cocobot/cocotter/elec/hw/cartes/pmi_charger_2023/pmi_charger_2023.step

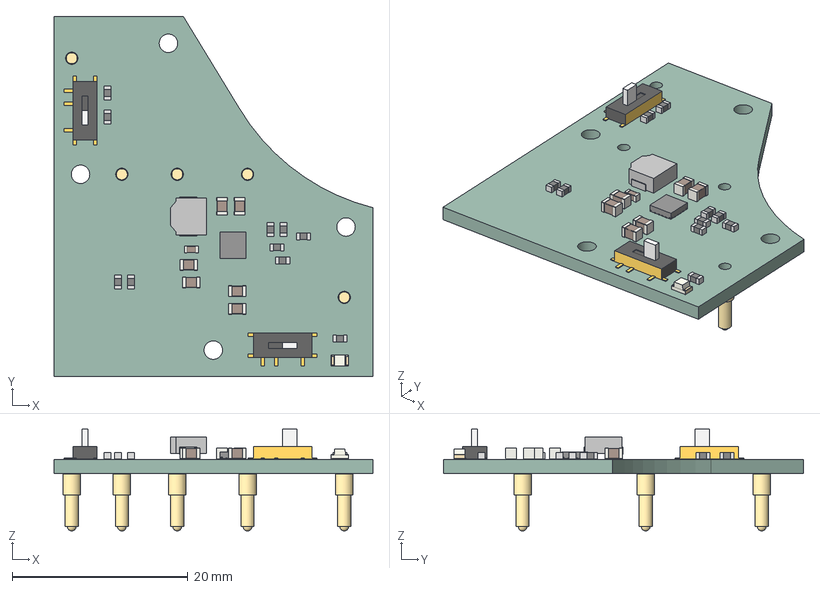
[picture p5: CAD file, 2024-06-13]
elec/hw/cartes/pmi_charger_2023/pmi_charger_2023.step
36.2 x 41.0 x 11.6 mm
C_0805_2012Metric x 6
SPM4020F
LED_0805_2012Metric
C_0603_1608Metric
RTE0016C_ASM
pmi_charger_PCB
