cocobot/cocotter/meca/pami/PAMI-support_moteur_helice.stl

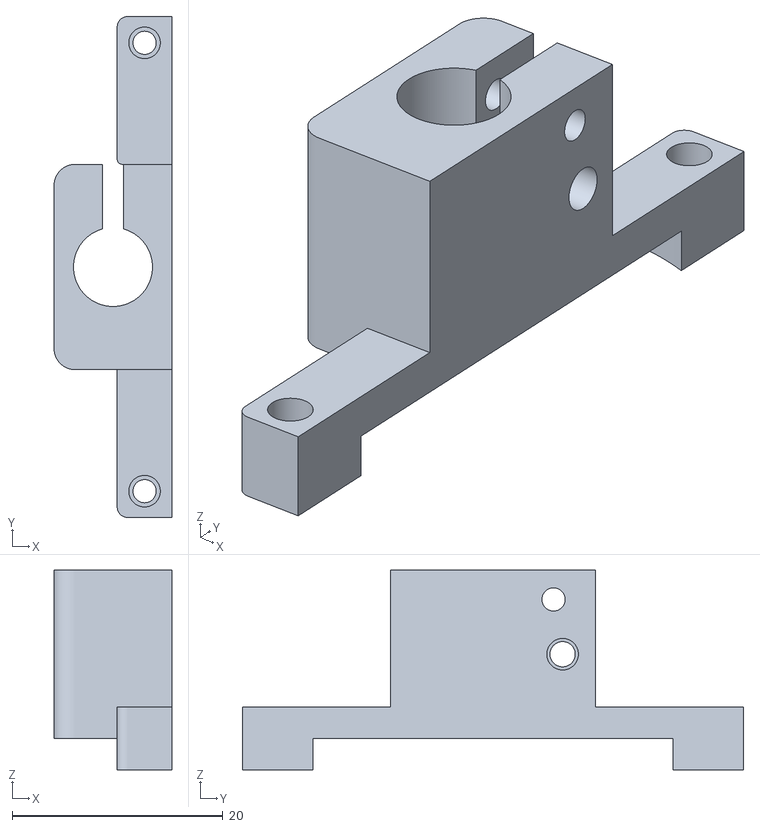
[picture p6: CAD file, 2025-01-07]
meca/pami/PAMI-support_moteur_helice.stl
11.2 x 47.6 x 19.0
