cocobot/cocotter/elec/hw/cartes/pmi_2023/pmi_2023.kicad_pcb

## KiCad design elec/hw/cartes/pmi_2023/pmi_2023.kicad_pcb (2024-12-13)

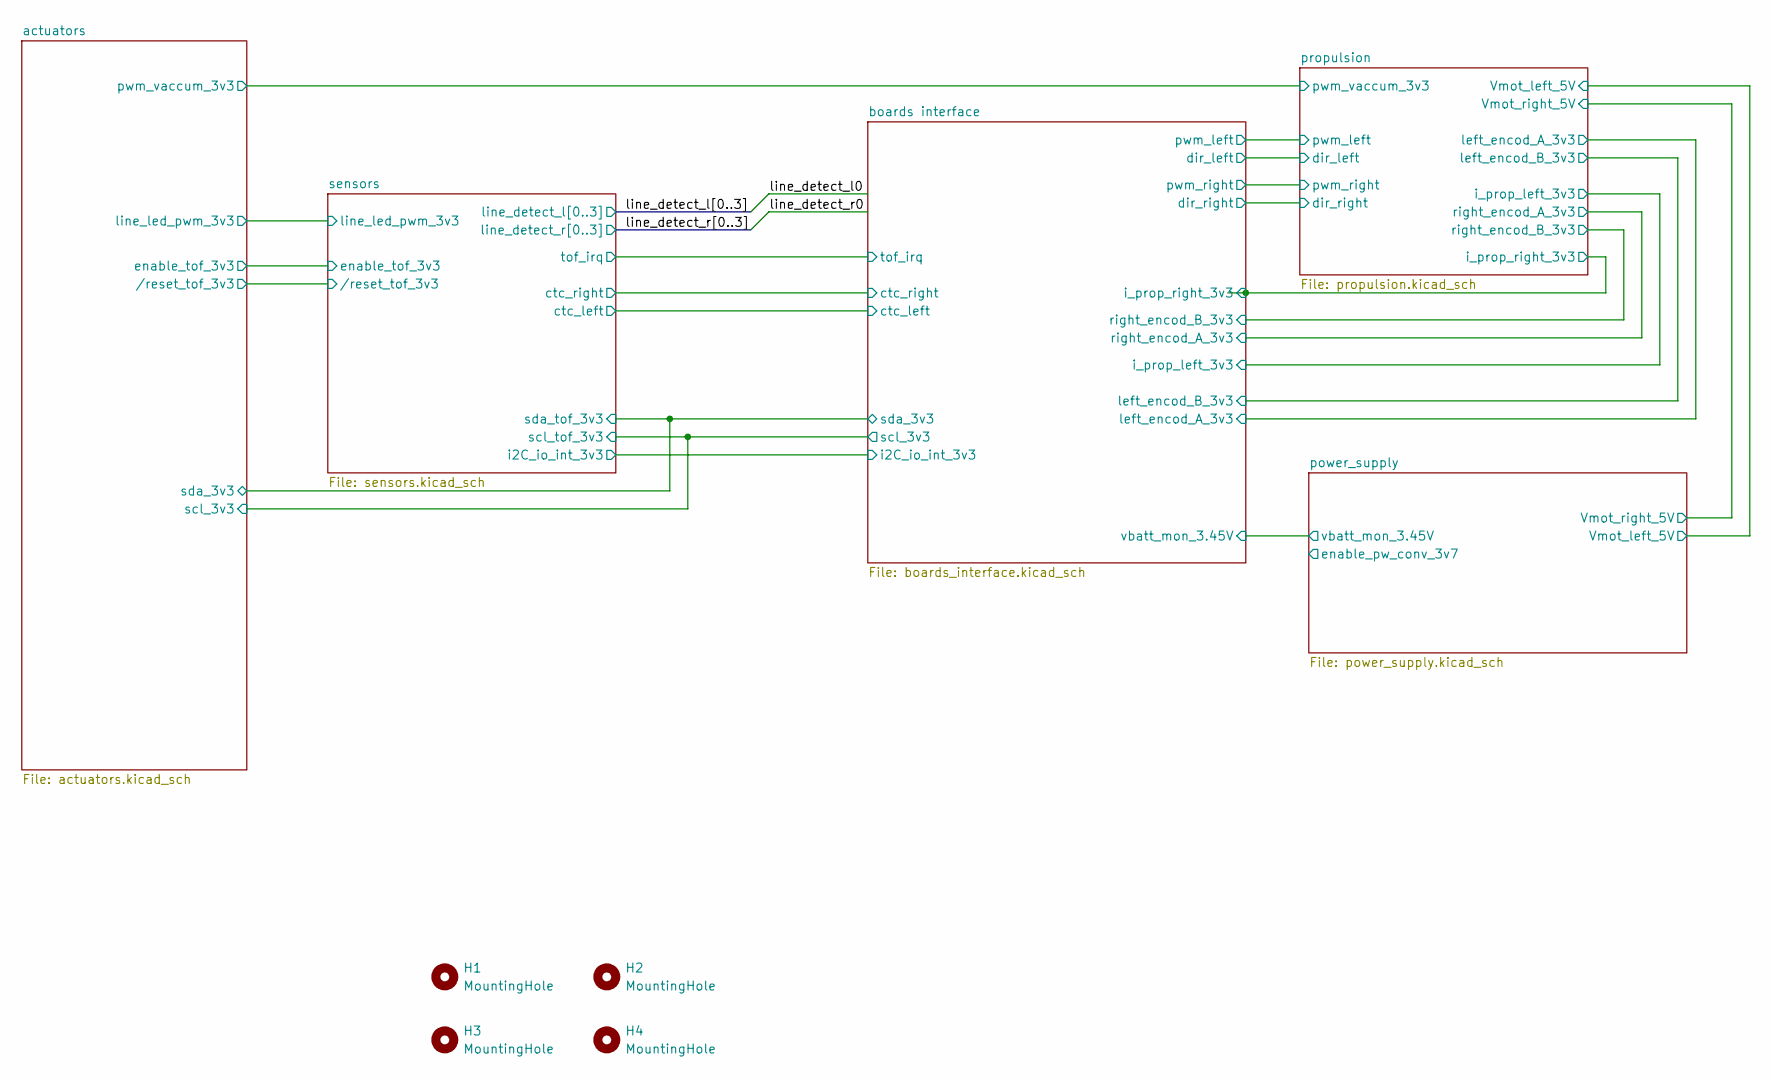
[picture p7: schematic pmi_2023.kicad_sch]

Parts:
H1, H2, H3, H4: MountingHole; MountingHole_2.1mm

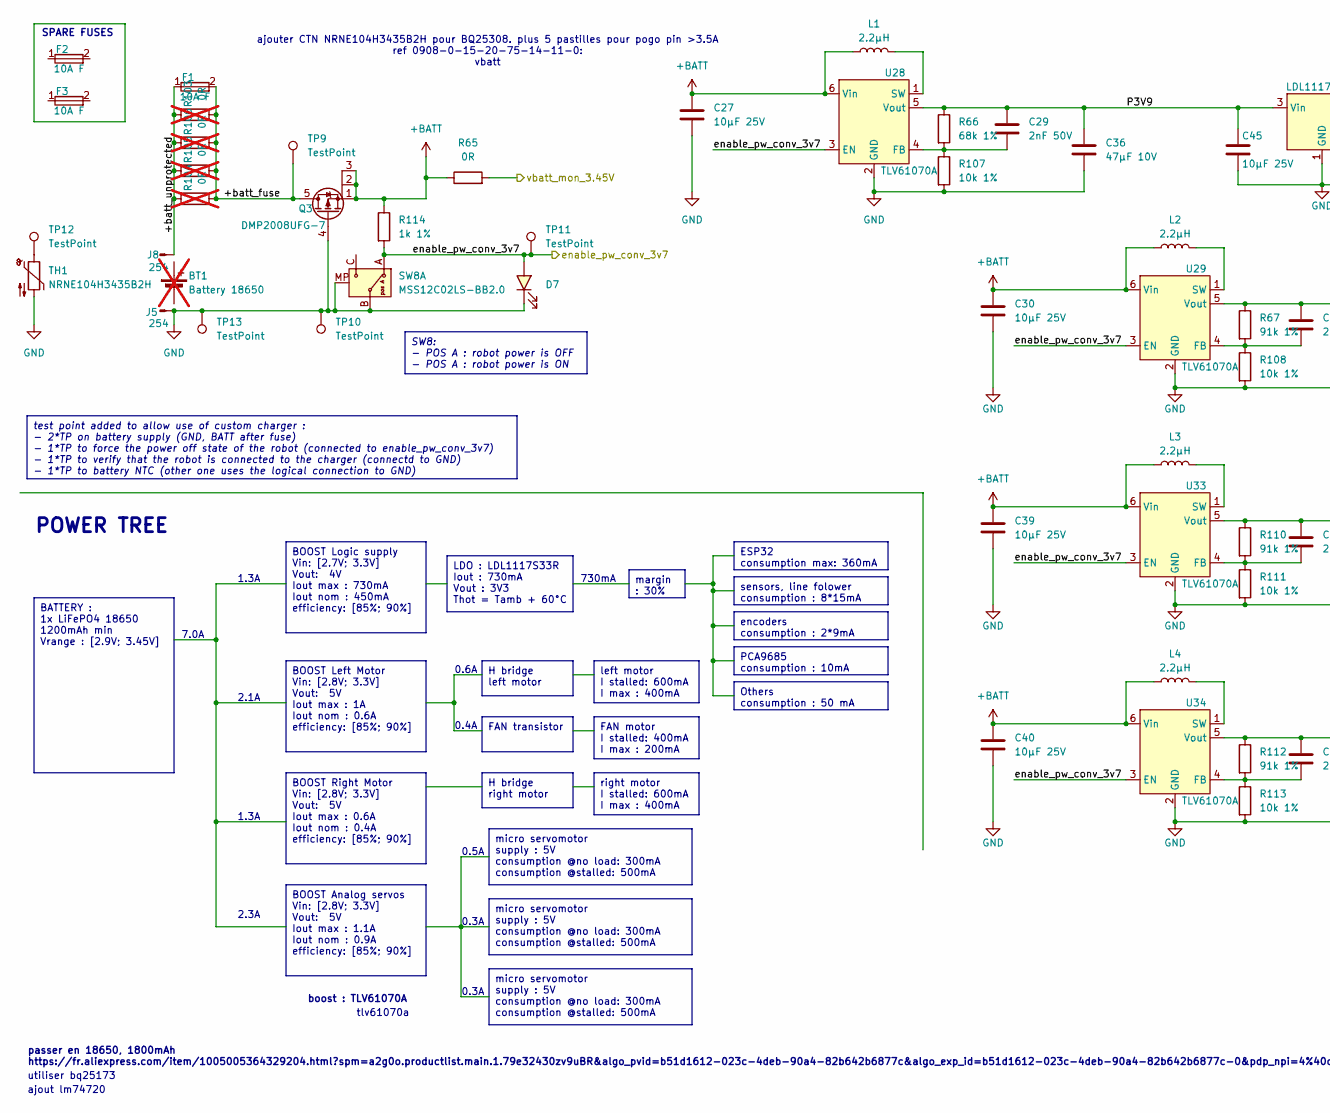
[picture p8: schematic power_supply.kicad_sch, part in row 1, column 1]

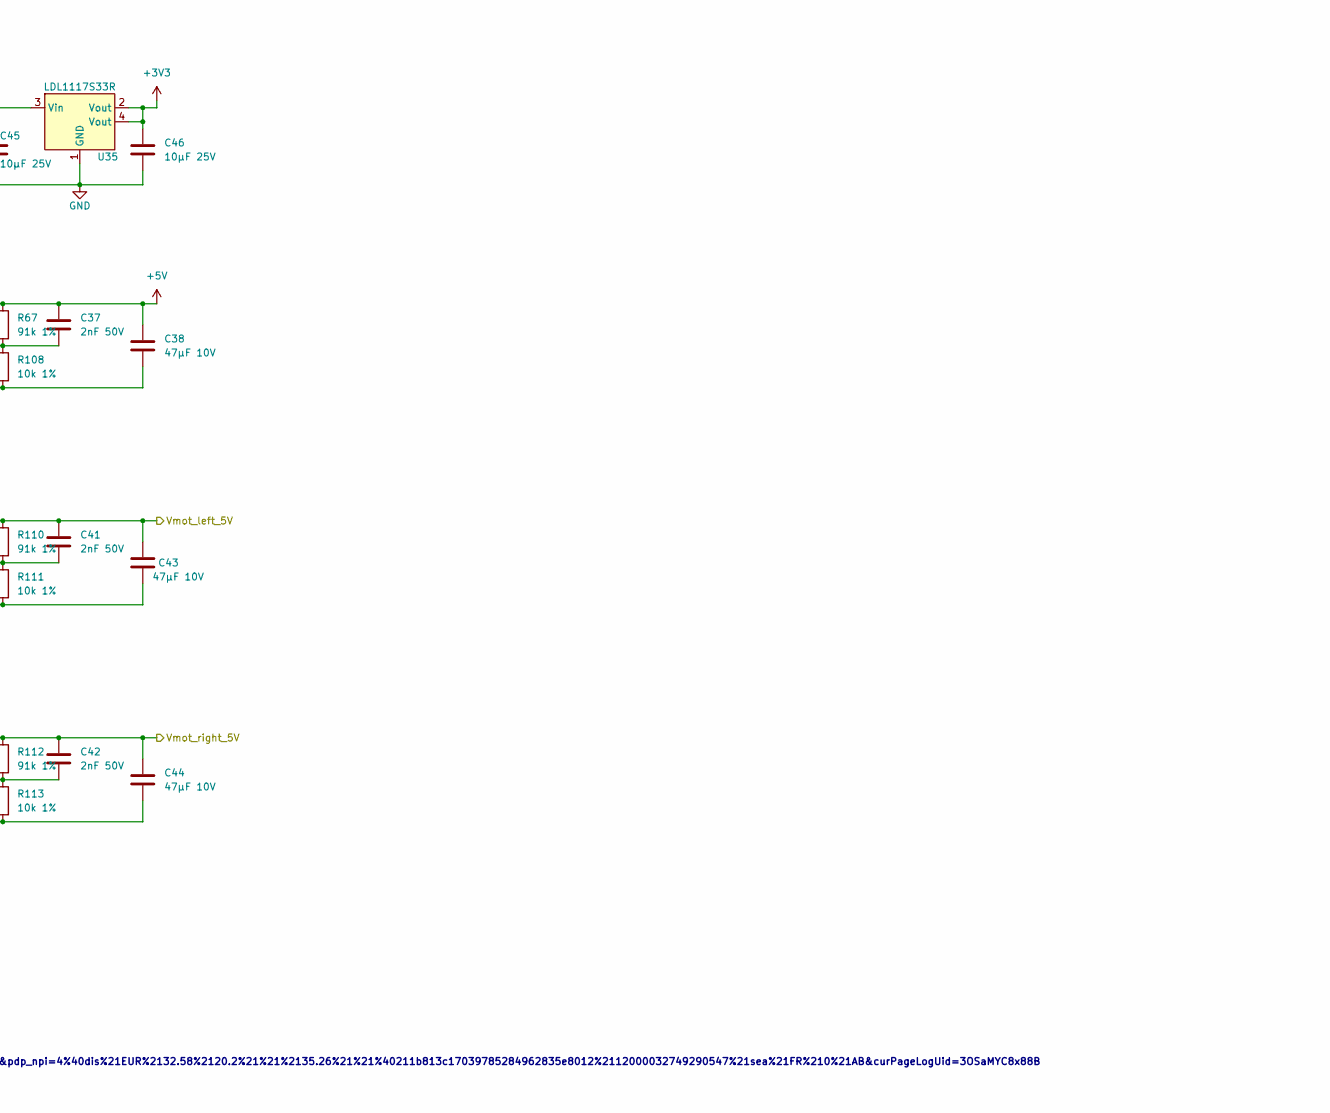
[picture p9: schematic power_supply.kicad_sch, part in row 1, column 2]

Parts:
BT1: Battery 18650; not fitted
C27, C30, C39, C40, C45, C46: 10µF 25V; C_0805_2012Metric; JLCPCB Part # C15850
C29, C37, C41, C42: 2nF 50V; C_0603_1608Metric; JLCPCB Part # C282245
C36, C38, C43, C44: 47µF 10V; C_1206_3216Metric; JLCPCB Part # C96123
D7: green, 0603; LED_0603_1608Metric; DIGIKEY_REF 3147-B19Y1UYG-20C000313U1930CT-ND
F1, F2, F3: 10A F; JFC2410; JLCPCB Part # C136374
J5, J8: 254; JLCPCB Part # C2979182
L1, L2, L3, L4: 2.2µH; L_Kyocera_07A7_7.3x6.6mm; MOUSER 581-LMLP07A7M2R2DTAS
Q3: DMP2008UFG-7; Diodes_PowerDI3333-8; JLCPCB Part # C461052
R65: 0R; r0603_reflow; JLCPCB Part # C431718
R66: 68k 1%; r0603_reflow; JLCPCB Part # C23231
R67, R110, R112: 91k 1%; r0603_reflow; JLCPCB Part # C23265
R103, R104, R105, R106: 0R; r0603_reflow; JLCPCB Part # C431718; not fitted
R107, R108, R111, R113: 10k 1%; r0603_reflow; mouser 603-RC0603FR-10100KL
R114: 1k 1%; r0603_reflow; mouser 603-RC0603FR-10100KL
SW8: MSS12C02LS-BB2.0; JLCPCB Part # C3008585
TH1: NRNE104H3435B2H; CTN-NRN
TP9, TP10, TP11, TP12, TP13: TestPoint; testpoint-THT-0.5mm
U28, U29, U33, U34: TLV61070A; SOT-23-6
U35: LDL1117S33R; SOT-223

Connections:
+3V3: C46.1, U35.2 (Vout), U35.4 (Vout); also elsewhere on the board
+5V: C37.1, C38.1, R67.1, U29.5 (Vout); also elsewhere on the board
+BATT: C27.1, C30.1, C39.1, C40.1, L1.1, L2.1, L3.1, L4.1, Q3.1 (S), Q3.2 (S), Q3.3 (S), R65.1, R114.1, U28.6 (Vin), U29.6 (Vin), U33.6 (Vin), U34.6 (Vin)
/boards interface/vbatt_mon_3.45V: R65.2; also elsewhere on the board
/power_supply/+batt_fuse: F1.2, Q3.5 (D), R103.2, R104.2, R105.2, R106.2, TP9.1
/power_supply/+batt_unprotected: F1.1, J8.1 (GND), R103.1, R104.1, R105.1, R106.1
/power_supply/P3V9: C29.1, C36.1, C45.1, R66.1, U28.5 (Vout), U35.3 (Vin)
/power_supply/Vmot_left_5V: C41.1, C43.1, R110.1, U33.5 (Vout); also elsewhere on the board
/power_supply/Vmot_right_5V: C42.1, C44.1, R112.1, U34.5 (Vout); also elsewhere on the board
/power_supply/enable_pw_conv_3v7: D7.A, R114.2, SW8.A, TP11.1, U28.3 (EN), U29.3 (EN), U33.3 (EN), U34.3 (EN)
GND: C27.2, C30.2, C36.2, C38.2, C39.2, C40.2, C43.2, C44.2, C45.2, C46.2, D7.C, J5.1 (GND), Q3.4 (G), R107.2, R108.2, R111.2, R113.2, SW8.B, SW8.MP, TH1.2, TP10.1, TP13.1, U28.2 (GND), U29.2 (GND), U33.2 (GND), U34.2 (GND), U35.1 (GND); also elsewhere on the board
unnamed: TH1.1, TP12.1
unnamed: C29.2, R66.2, R107.1, U28.4 (FB)
unnamed: L1.2, U28.1 (SW)
unnamed: C37.2, R67.2, R108.1, U29.4 (FB)
unnamed: L2.2, U29.1 (SW)
unnamed: C41.2, R110.2, R111.1, U33.4 (FB)
unnamed: L3.2, U33.1 (SW)
unnamed: C42.2, R112.2, R113.1, U34.4 (FB)
unnamed: L4.2, U34.1 (SW)

Notes on the sheet:
FAN motor I stalled: 400mA I max : 200mA
H bridge left motor
micro servomotor supply : 5V consumption @no load: 300mA consumption @stalled: 500mA
right motor I stalled: 600mA I max : 400mA
BATTERY : 1x LiFePO4 18650 1200mAh min Vrange : [2.9V; 3.45V]
encoders consumption : 2*9mA
BOOST Right Motor Vin: [2.8V; 3.3V] Vout: 5V Iout max : 0.6A Iout nom : 0.4A efficiency: [85%; 90%]
FAN transistor
left motor I stalled: 600mA I max : 400mA
ESP32 consumption max: 360mA
H bridge right motor
Others consumption : 50 mA
BOOST Left Motor Vin: [2.8V; 3.3V] Vout: 5V Iout max : 1A Iout nom : 0.6A efficiency: [85%; 90%]
BOOST Logic supply Vin: [2.7V; 3.3V] Vout: 4V Iout max : 730mA Iout nom : 450mA efficiency: [85%; 90%]
PCA9685 consumption : 10mA
SW8: - POS A : robot power is OFF - POS A : robot power is ON
test point added to allow use of custom charger : - 2*TP on battery supply (GND, BATT after fuse) - 1*TP to force the power off state of the robot (connected to enable_pw_conv_3v7) - 1*TP to verify that the robot is connected to the charger (connectd to GND) - 1*TP to battery NTC (other one uses th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
margin : 30%
BOOST Analog servos Vin: [2.8V; 3.3V] Vout: 5V Iout max : 1.1A Iout nom : 0.9A efficiency: [85%; 90%]
LDO : LDL1117S33R Iout : 730mA Vout : 3V3 Thot = Tamb + 60°C
sensors, line folower consumption : 8*15mA
ajouter CTN NRNE104H3435B2H pour BQ25308. plus 5 pastilles pour pogo pin >3.5A ref 0908-0-15-20-75-14-11-0: vbatt
0.3A
1.3A
ajout lm74720
POWER TREE
passer en 18650, 1800mAh https://fr.aliexpress.com/item/1005005364329204.html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…
0.4A
2.1A
tlv61070a
utiliser bq25173
0.6A
2.3A
boost : TLV61070A
SPARE FUSES
7.0A
0.5A
730mA

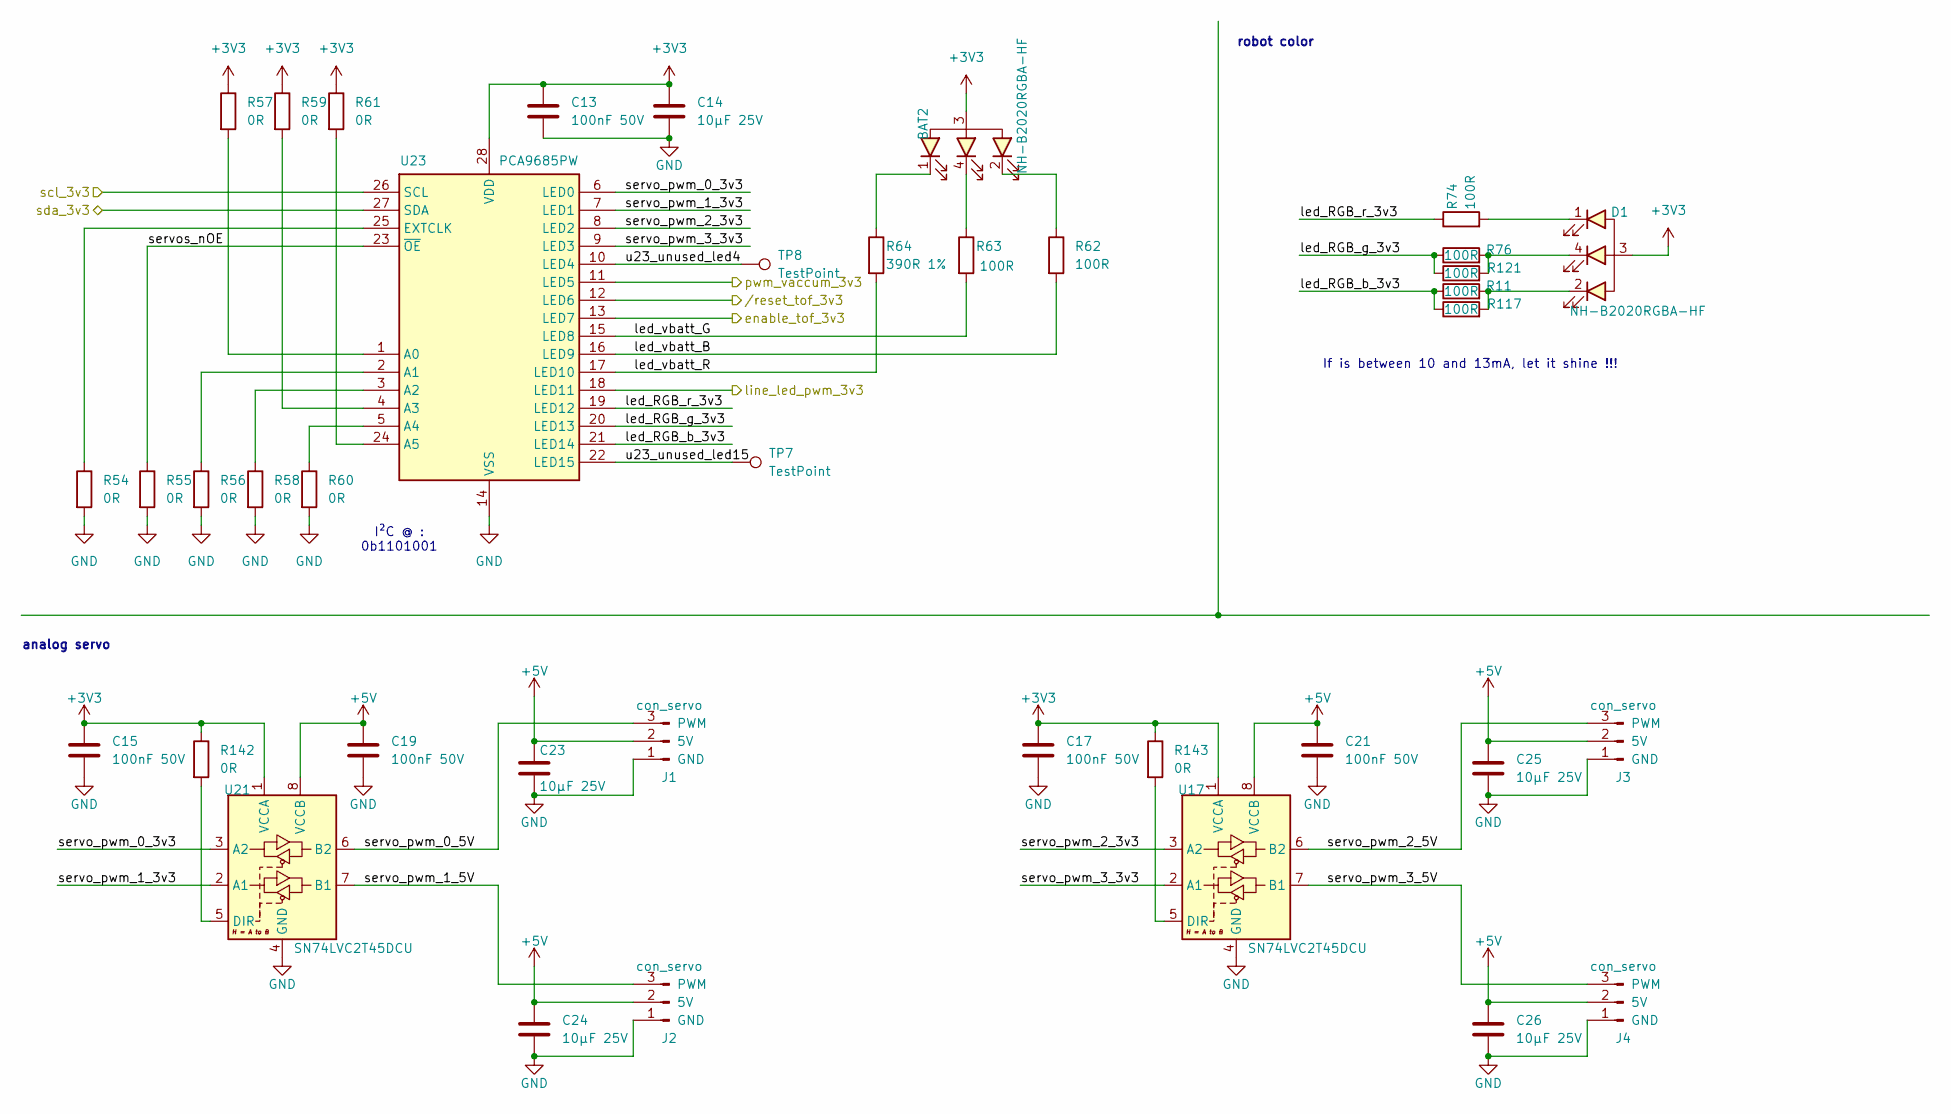
[picture p10: schematic actuators.kicad_sch]

Parts:
BAT2: NH-B2020RGBA-HF; JLCPCB Part # C2874116
C13, C15, C17, C19, C21: 100nF 50V; C_0603_1608Metric; JLCPCB Part # C14663
C14, C23, C24, C25, C26: 10µF 25V; C_0805_2012Metric; JLCPCB Part # C15850
D1: NH-B2020RGBA-HF; JLCPCB Part # C2874116
J1, J2, J3, J4: con_servo; ana_servo_5V; JLCPCB Part # C2932698
R11, R74, R76, R117, R121: 100R; r0603_reflow; JLCPCB Part # C22775
R54, R55, R56, R57, R58, R59, R60, R61, R142, R143: 0R; r0603_reflow; JLCPCB Part # C431718
R62, R63: 100R; r0603_reflow; mouser 603-RC0603FR-10100KL
R64: 390R 1%; r0603_reflow; mouser 603-RC0603FR-10100KL
TP7, TP8: TestPoint; testpoint-THT-0.5mm
U17, U21: SN74LVC2T45DCU; VSSOP-8-DCU
U23: PCA9685PW; TSSOP-28_4.4x9.7mm_P0.65mm; JLCPCB Part # C2678753

Connections:
+3V3: BAT2.3 (COM), C13.1, C14.1, C15.1, C17.1, D1.3 (COM), R57.1, R59.1, R61.1, R142.1, R143.1, U17.1 (VCCA), U21.1 (VCCA), U23.28 (VDD); also elsewhere on the board
+5V: C19.1, C21.1, C23.1, C24.1, C25.1, C26.1, J1.2 (5V), J2.2 (5V), J3.2 (5V), J4.2 (5V), U17.8 (VCCB), U21.8 (VCCB); also elsewhere on the board
/actuators/enable_tof_3v3: U23.13 (LED7); also elsewhere on the board
/actuators/led_RGB_b_3v3: R11.1, R117.1, U23.21 (LED14)
/actuators/led_RGB_g_3v3: R76.1, R121.1, U23.20 (LED13)
/actuators/led_RGB_r_3v3: R74.1, U23.19 (LED12)
/actuators/led_vbatt_B: R62.2, U23.16 (LED9)
/actuators/led_vbatt_G: R63.2, U23.15 (LED8)
/actuators/led_vbatt_R: R64.2, U23.17 (LED10)
/actuators/line_led_pwm_3v3: U23.18 (LED11); also elsewhere on the board
/actuators/scl_3v3: U23.26 (SCL); also elsewhere on the board
/actuators/sda_3v3: U23.27 (SDA); also elsewhere on the board
/actuators/servo_pwm_0_3v3: U21.3 (A2), U23.6 (LED0)
/actuators/servo_pwm_0_5V: J1.3 (PWM), U21.6 (B2)
/actuators/servo_pwm_1_3v3: U21.2 (A1), U23.7 (LED1)
/actuators/servo_pwm_1_5V: J2.3 (PWM), U21.7 (B1)
/actuators/servo_pwm_2_3v3: U17.3 (A2), U23.8 (LED2)
/actuators/servo_pwm_2_5V: J3.3 (PWM), U17.6 (B2)
/actuators/servo_pwm_3_3v3: U17.2 (A1), U23.9 (LED3)
/actuators/servo_pwm_3_5V: J4.3 (PWM), U17.7 (B1)
/actuators/servos_nOE: R55.1, U23.23 (~OE)
/actuators/u23_unused_led4: TP8.1, U23.10 (LED4)
/actuators/u23_unused_led15: TP7.1, U23.22 (LED15)
/actuators//reset_tof_3v3: U23.12 (LED6); also elsewhere on the board
/propulsion/pwm_vaccum_3v3: U23.11 (LED5); also elsewhere on the board
GND: C13.2, C14.2, C15.2, C17.2, C19.2, C21.2, C23.2, C24.2, C25.2, C26.2, J1.1 (GND), J2.1 (GND), J3.1 (GND), J4.1 (GND), R54.2, R55.2, R56.2, R58.2, R60.2, U17.4 (GND), U21.4 (GND), U23.14 (VSS); also elsewhere on the board
unnamed: BAT2.2 (C_BLUE), R62.1
unnamed: BAT2.4 (C_GREEN), R63.1
unnamed: BAT2.1 (C_RED), R64.1
unnamed: D1.2 (C_BLUE), R11.2, R117.2
unnamed: D1.4 (C_GREEN), R76.2, R121.2
unnamed: D1.1 (C_RED), R74.2
unnamed: R143.2, U17.5 (DIR)
unnamed: R142.2, U21.5 (DIR)
unnamed: R57.2, U23.1 (A0)
unnamed: R56.1, U23.2 (A1)
unnamed: R58.1, U23.3 (A2)
unnamed: R59.2, U23.4 (A3)
unnamed: R60.1, U23.5 (A4)
unnamed: R61.2, U23.24 (A5)
unnamed: R54.1, U23.25 (EXTCLK)

Notes on the sheet:
I²C @ : 0b1101001
If is between 10 and 13mA, let it shine !!!
robot color
analog servo

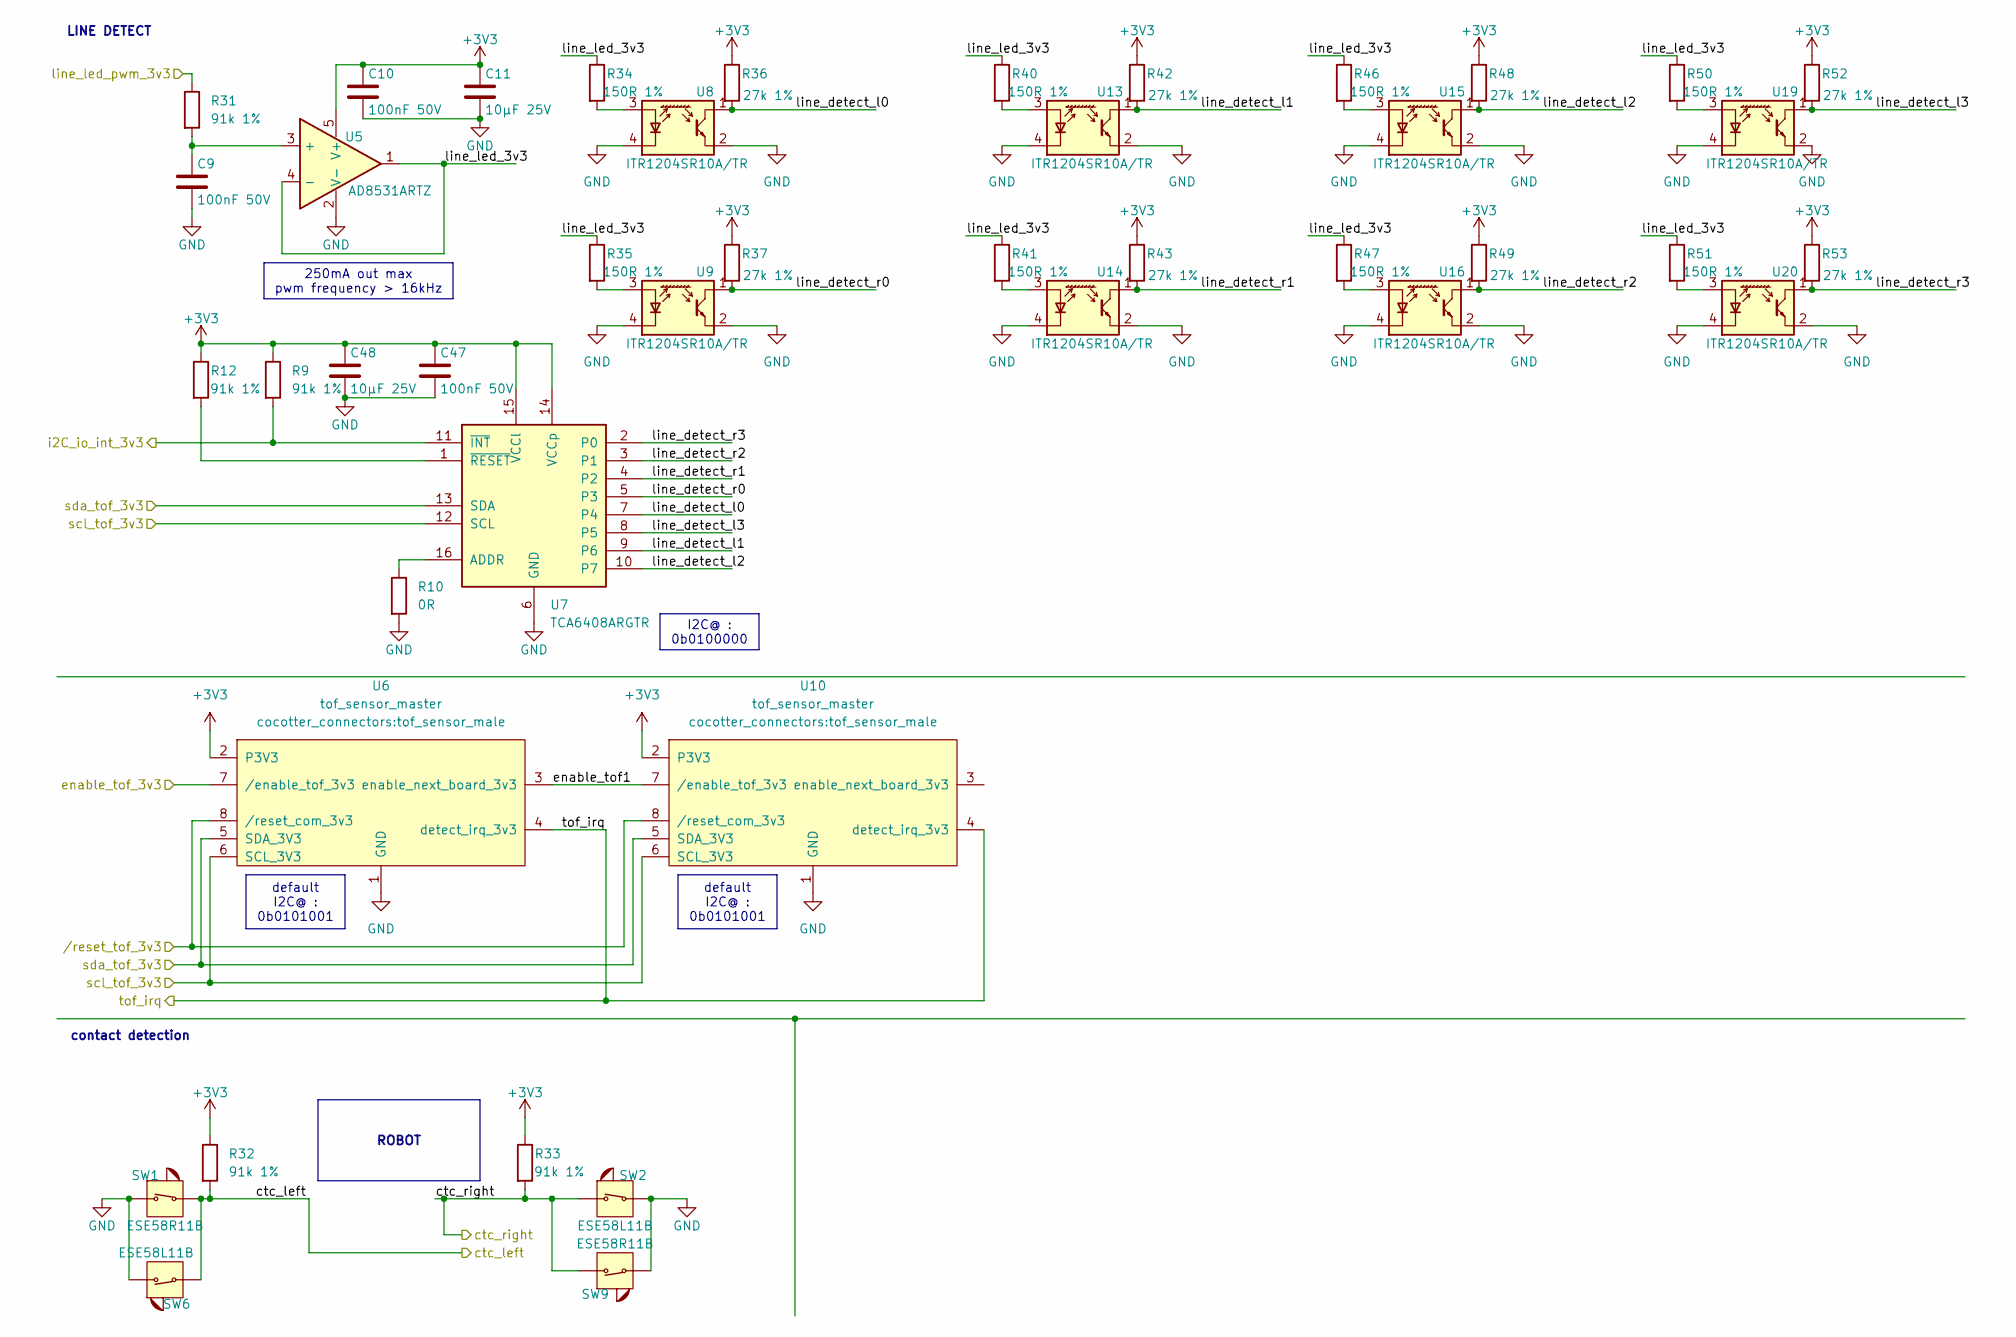
[picture p11: schematic sensors.kicad_sch]

Parts:
C9, C10, C47: 100nF 50V; C_0603_1608Metric; JLCPCB Part # C14663
C11, C48: 10µF 25V; C_0805_2012Metric; JLCPCB Part # C15850
R9, R12, R31, R32, R33: 91k 1%; r0603_reflow; JLCPCB Part # C23265
R10: 0R; r0603_reflow; JLCPCB Part # C431718
R34, R35, R40, R41, R46, R47, R50, R51: 150R 1%; r0805_reflow; JLCPCB Part # C17471
R36, R37, R42, R43, R48, R49, R52, R53: 27k 1%; r0603_reflow; JLCPCB Part # C22967
SW1, SW9: ESE58R11B; Mouser 667-ESE-22MH22
SW2, SW6: ESE58L11B; Mouser 667-ESE-22MH24
U5: AD8531ARTZ; SOT-23-5; MOUSER_REF 584-AD8531ARTZ-R7
U6, U10: tof_sensor_master; tof_sensor_male
U7: TCA6408ARGTR; VQFN-16-1EP_3x3mm_P0.5mm_EP1.1x1.1mm; mouser 595-TCA6408ARGTR
U8, U9, U13, U14, U15, U16, U19, U20: ITR1204SR10A/TR; ITR1204SR10A; JLCPCB Part # C2943466

Connections:
+3V3: C10.1, C11.1, C47.1, C48.1, R9.1, R12.1, R32.1, R33.1, R36.1, R37.1, R42.1, R43.1, R48.1, R49.1, R52.1, R53.1, U5.5 (V+), U6.2 (P3V3), U7.14 (VCCp), U7.15 (VCCl), U10.2 (P3V3); also elsewhere on the board
/actuators/enable_tof_3v3: U6.7 (/enable_tof_3v3); also elsewhere on the board
/actuators/line_led_pwm_3v3: R31.1; also elsewhere on the board
/actuators/scl_3v3: U6.6 (SCL_3V3), U7.12 (SCL), U10.6 (SCL_3V3); also elsewhere on the board
/actuators/sda_3v3: U6.5 (SDA_3V3), U7.13 (SDA), U10.5 (SDA_3V3); also elsewhere on the board
/actuators//reset_tof_3v3: U6.8 (/reset_com_3v3), U10.8 (/reset_com_3v3); also elsewhere on the board
/boards interface/i2C_io_int_3v3: R9.2, U7.11 (~INT); also elsewhere on the board
/sensors/ctc_left: R32.2, SW1.2, SW6.2; also elsewhere on the board
/sensors/ctc_right: R33.2, SW2.1, SW9.1; also elsewhere on the board
/sensors/enable_tof1: U6.3 (enable_next_board_3v3), U10.7 (/enable_tof_3v3)
/sensors/line_detect_l0: R36.2, U7.7 (P4), U8.1 (C)
/sensors/line_detect_l1: R42.2, U7.9 (P6), U13.1 (C)
/sensors/line_detect_l2: R48.2, U7.10 (P7), U15.1 (C)
/sensors/line_detect_l3: R52.2, U7.8 (P5), U19.1 (C)
/sensors/line_detect_r0: R37.2, U7.5 (P3), U9.1 (C)
/sensors/line_detect_r1: R43.2, U7.4 (P2), U14.1 (C)
/sensors/line_detect_r2: R49.2, U7.3 (P1), U16.1 (C)
/sensors/line_detect_r3: R53.2, U7.2 (P0), U20.1 (C)
/sensors/line_led_3v3: R34.1, R35.1, R40.1, R41.1, R46.1, R47.1, R50.1, R51.1, U5.1, U5.4 (-)
/sensors/tof_irq: U6.4 (detect_irq_3v3), U10.4 (detect_irq_3v3); also elsewhere on the board
GND: C9.2, C10.2, C11.2, C47.2, C48.2, R10.2, SW1.1, SW2.2, SW6.1, SW9.2, U5.2 (V-), U6.1 (GND), U7.6 (GND), U8.2 (E), U8.4 (K), U9.2 (E), U9.4 (K), U10.1 (GND), U13.2 (E), U13.4 (K), U14.2 (E), U14.4 (K), U15.2 (E), U15.4 (K), U16.2 (E), U16.4 (K), U19.2 (E), U19.4 (K), U20.2 (E), U20.4 (K); also elsewhere on the board
unnamed: C9.1, R31.2, U5.3 (+)
unnamed: R10.1, U7.16 (ADDR)
unnamed: R12.2, U7.1 (~RESET)
unnamed: R34.2, U8.3 (A)
unnamed: R35.2, U9.3 (A)
unnamed: R40.2, U13.3 (A)
unnamed: R41.2, U14.3 (A)
unnamed: R46.2, U15.3 (A)
unnamed: R47.2, U16.3 (A)
unnamed: R50.2, U19.3 (A)
unnamed: R51.2, U20.3 (A)

Notes on the sheet:
250mA out max pwm frequency > 16kHz
default I2C@ : 0b0101001
ROBOT
I2C@ : 0b0100000
contact detection
LINE DETECT

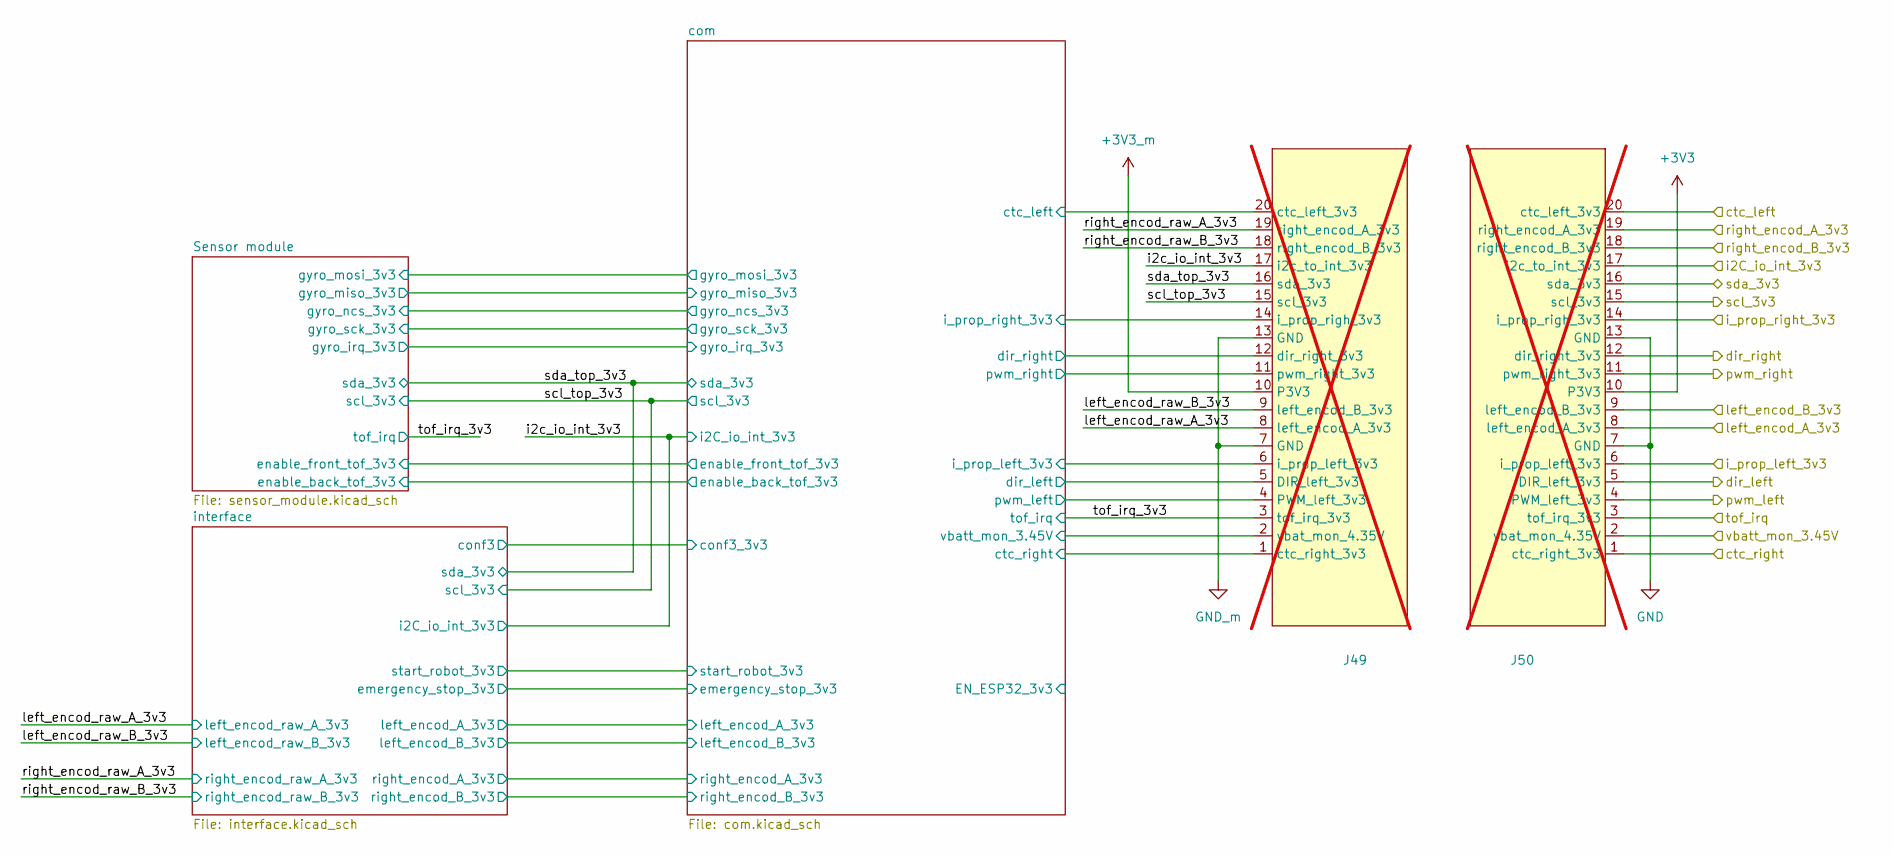
[picture p12: schematic boards_interface.kicad_sch]

Parts:
J49: pmi_2023_interconnection_top; not fitted
J50: pmi_2023_interconnection; not fitted

Connections:
+3V3: J50.10 (P3V3); also elsewhere on the board
+3V3_m: J49.10 (P3V3); also elsewhere on the board
/actuators/scl_3v3: J50.15 (scl_3v3); also elsewhere on the board
/actuators/sda_3v3: J50.16 (sda_3v3); also elsewhere on the board
/boards interface/com/ctc_left: J49.20 (ctc_left_3v3); also elsewhere on the board
/boards interface/com/ctc_right: J49.1 (ctc_right_3v3); also elsewhere on the board
/boards interface/com/dir_left: J49.5 (DIR_left_3v3); also elsewhere on the board
/boards interface/com/dir_right: J49.12 (dir_right_3v3); also elsewhere on the board
/boards interface/com/i_prop_left_3v3: J49.6 (i_prop_left_3v3); also elsewhere on the board
/boards interface/com/i_prop_right_3v3: J49.14 (i_prop_righ_3v3); also elsewhere on the board
/boards interface/com/pwm_left: J49.4 (PWM_left_3v3); also elsewhere on the board
/boards interface/com/pwm_right: J49.11 (pwm_right_3v3); also elsewhere on the board
/boards interface/com/vbatt_mon_3.45V: J49.2 (vbat_mon_4.35V); also elsewhere on the board
/boards interface/i2C_io_int_3v3: J50.17 (i2c_to_int_3v3); also elsewhere on the board
/boards interface/i2c_io_int_3v3: J49.17 (i2c_to_int_3v3); also elsewhere on the board
/boards interface/i_prop_left_3v3: J50.6 (i_prop_left_3v3); also elsewhere on the board
/boards interface/i_prop_right_3v3: J50.14 (i_prop_righ_3v3); also elsewhere on the board
/boards interface/left_encod_raw_A_3v3: J49.8 (left_encod_A_3v3); also elsewhere on the board
/boards interface/left_encod_raw_B_3v3: J49.9 (left_encod_B_3v3); also elsewhere on the board
/boards interface/right_encod_raw_A_3v3: J49.19 (right_encod_A_3v3); also elsewhere on the board
/boards interface/right_encod_raw_B_3v3: J49.18 (right_encod_B_3v3); also elsewhere on the board
/boards interface/scl_top_3v3: J49.15 (scl_3v3); also elsewhere on the board
/boards interface/sda_top_3v3: J49.16 (sda_3v3); also elsewhere on the board
/boards interface/tof_irq_3v3: J49.3 (tof_irq_3v3); also elsewhere on the board
/boards interface/vbatt_mon_3.45V: J50.2 (vbat_mon_4.35V); also elsewhere on the board
/propulsion/dir_left: J50.5 (DIR_left_3v3); also elsewhere on the board
/propulsion/dir_right: J50.12 (dir_right_3v3); also elsewhere on the board
/propulsion/left_encod_A_3v3: J50.8 (left_encod_A_3v3); also elsewhere on the board
/propulsion/left_encod_B_3v3: J50.9 (left_encod_B_3v3); also elsewhere on the board
/propulsion/pwm_left: J50.4 (PWM_left_3v3); also elsewhere on the board
/propulsion/pwm_right: J50.11 (pwm_right_3v3); also elsewhere on the board
/propulsion/right_encod_A_3v3: J50.19 (right_encod_A_3v3); also elsewhere on the board
/propulsion/right_encod_B_3v3: J50.18 (right_encod_B_3v3); also elsewhere on the board
/sensors/ctc_left: J50.20 (ctc_left_3v3); also elsewhere on the board
/sensors/ctc_right: J50.1 (ctc_right_3v3); also elsewhere on the board
/sensors/tof_irq: J50.3 (tof_irq_3v3); also elsewhere on the board
GND: J50.7 (GND), J50.13 (GND); also elsewhere on the board
GND_m: J49.7 (GND), J49.13 (GND); also elsewhere on the board
