cocobot/cocotter/elec/hw/cartes/pmi_2023/pmi_2023.kicad_pcb

## KiCad design elec/hw/cartes/pmi_2023/pmi_2023.kicad_pcb (continued)

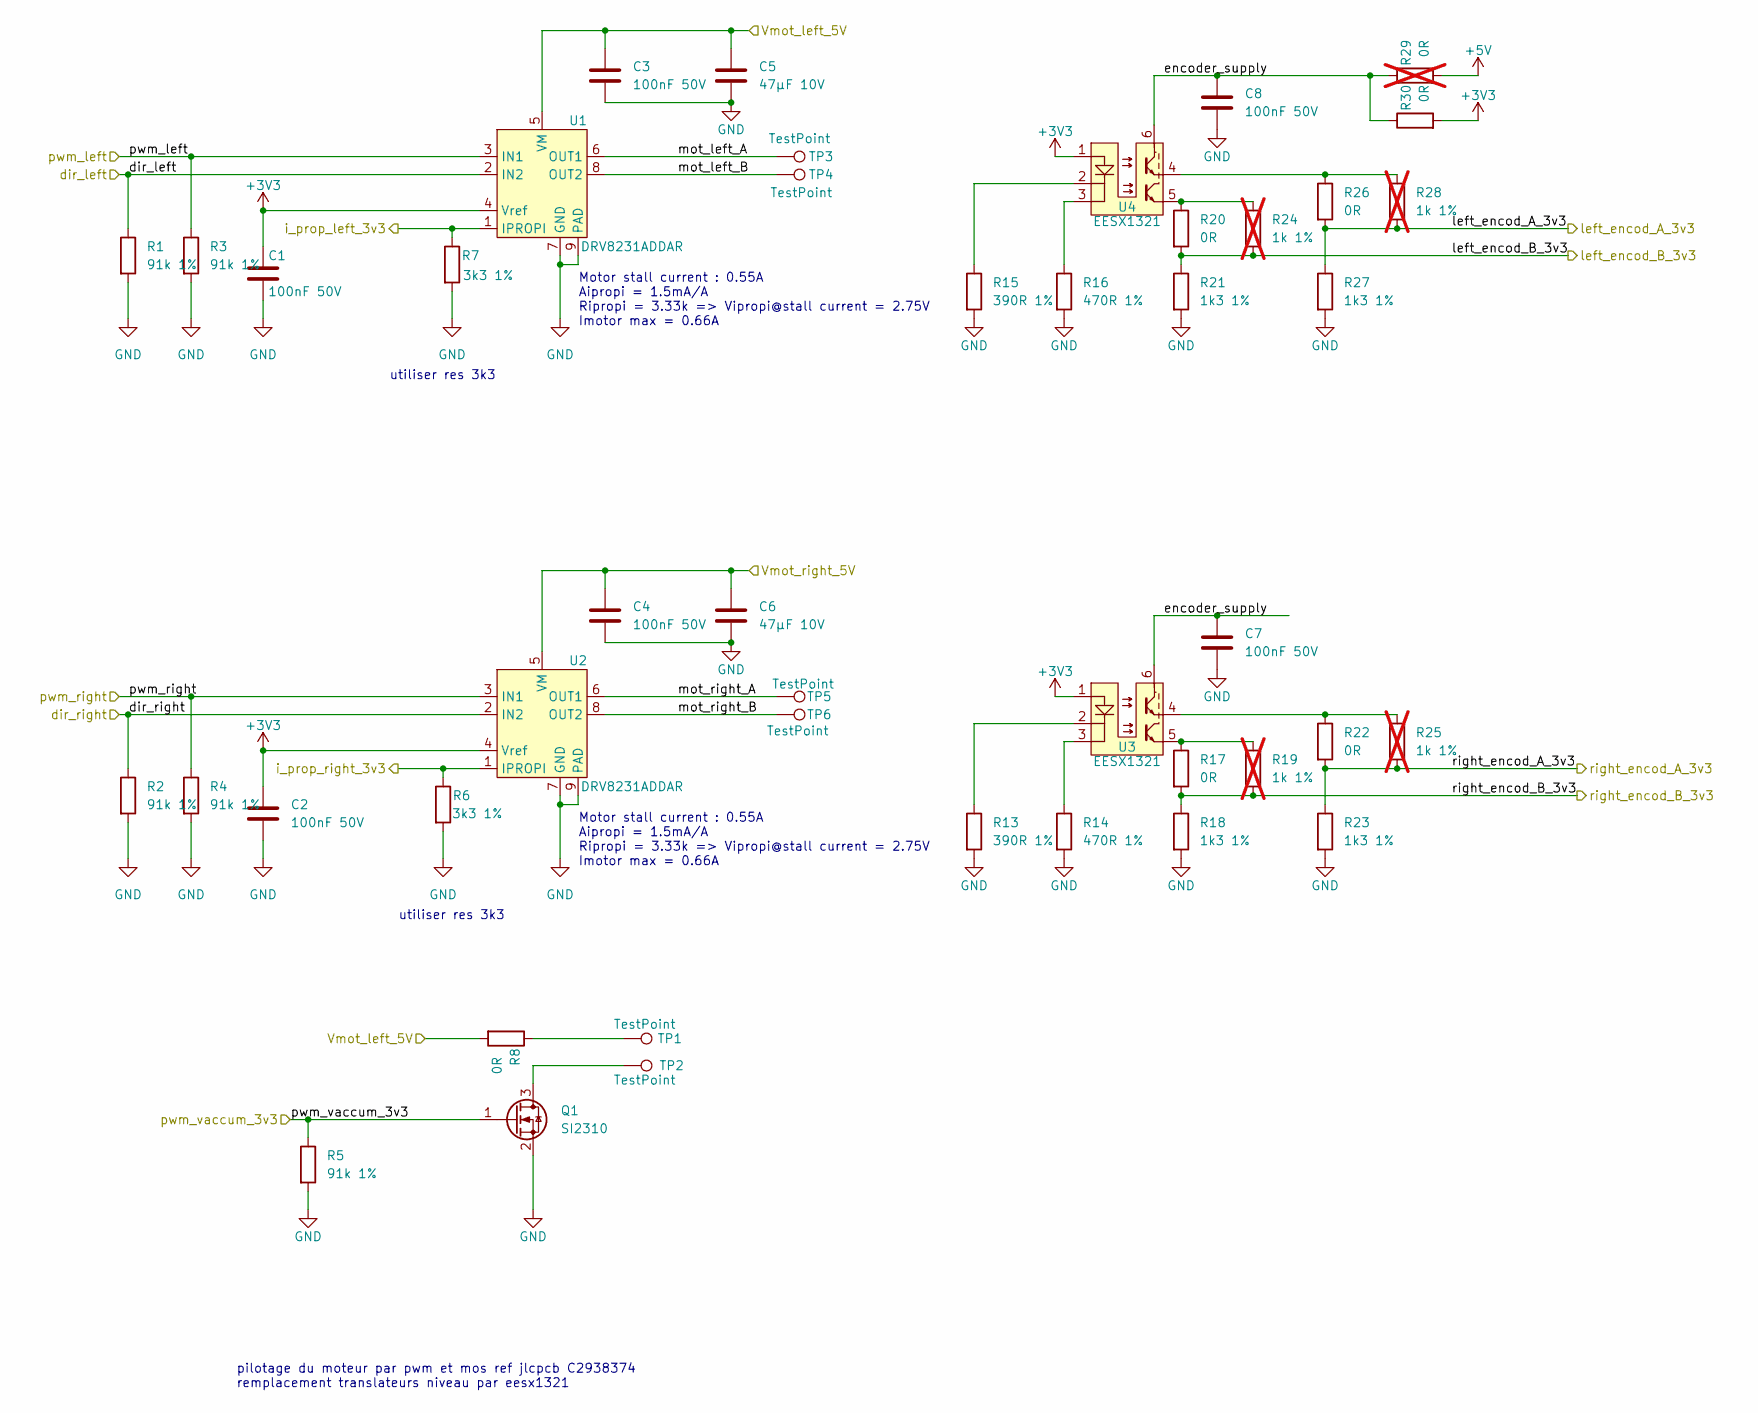
[picture p13: schematic propulsion.kicad_sch]

Parts:
C1, C2, C3, C4, C7, C8: 100nF 50V; C_0603_1608Metric; JLCPCB Part # C14663
C5, C6: 47µF 10V; C_1206_3216Metric; JLCPCB Part # C96123
Q1: SI2310; SOT-23-3; JLCPCB Part # C2938374
R1, R2, R3, R4, R5: 91k 1%; r0603_reflow; JLCPCB Part # C23265
R6, R7: 3k3 1%; r0603_reflow; JLCPCB Part # C22978
R8, R17, R20, R22, R26, R30: 0R; r0603_reflow; JLCPCB Part # C431718
R13, R15: 390R 1%; r0603_reflow; JLCPCB Part # C23151
R14, R16: 470R 1%; r0603_reflow; JLCPCB Part # C23179
R18, R21, R23, R27: 1k3 1%; r0603_reflow; JLCPCB Part # C22767
R19, R24, R25, R28: 1k 1%; r0603_reflow; mouser 603-RC0603FR-10100KL; not fitted
R29: 0R; r0603_reflow; JLCPCB Part # C431718; not fitted
TP1, TP2, TP3, TP4, TP5, TP6: TestPoint; testpoint-THT-0.5mm
U1, U2: DRV8231ADDAR; DDA0008B; JLCPCB Part # C5218849
U3, U4: EESX1321

Connections:
+3V3: C1.1, C2.1, R30.2, U1.4 (Vref), U2.4 (Vref), U3.1 (A), U4.1 (A); also elsewhere on the board
+5V: R29.2; also elsewhere on the board
/boards interface/i_prop_left_3v3: R7.1, U1.1 (IPROPI); also elsewhere on the board
/boards interface/i_prop_right_3v3: R6.1, U2.1 (IPROPI); also elsewhere on the board
/power_supply/Vmot_left_5V: C3.1, C5.1, R8.2, U1.5 (VM); also elsewhere on the board
/power_supply/Vmot_right_5V: C4.1, C6.1, U2.5 (VM); also elsewhere on the board
/propulsion/dir_left: R1.1, U1.2 (IN2); also elsewhere on the board
/propulsion/dir_right: R2.1, U2.2 (IN2); also elsewhere on the board
/propulsion/encoder_supply: C7.1, C8.1, R29.1, R30.1, U3.6 (C), U4.6 (C)
/propulsion/left_encod_A_3v3: R26.2, R27.1, R28.2; also elsewhere on the board
/propulsion/left_encod_B_3v3: R20.2, R21.1, R24.2; also elsewhere on the board
/propulsion/mot_left_A: TP3.1, U1.6 (OUT1)
/propulsion/mot_left_B: TP4.1, U1.8 (OUT2)
/propulsion/mot_right_A: TP5.1, U2.6 (OUT1)
/propulsion/mot_right_B: TP6.1, U2.8 (OUT2)
/propulsion/pwm_left: R3.1, U1.3 (IN1); also elsewhere on the board
/propulsion/pwm_right: R4.1, U2.3 (IN1); also elsewhere on the board
/propulsion/pwm_vaccum_3v3: Q1.1 (G), R5.1; also elsewhere on the board
/propulsion/right_encod_A_3v3: R22.2, R23.1, R25.2; also elsewhere on the board
/propulsion/right_encod_B_3v3: R17.2, R18.1, R19.2; also elsewhere on the board
GND: C1.2, C2.2, C3.2, C4.2, C5.2, C6.2, C7.2, C8.2, Q1.2 (S), R1.2, R2.2, R3.2, R4.2, R5.2, R6.2, R7.2, R13.2, R14.2, R15.2, R16.2, R18.2, R21.2, R23.2, R27.2, U1.7 (GND), U1.9 (PAD), U2.7 (GND), U2.9 (PAD); also elsewhere on the board
unnamed: Q1.3 (D), TP2.1
unnamed: R8.1, TP1.1
unnamed: R13.1, U3.2 (C1)
unnamed: R14.1, U3.3 (C2)
unnamed: R22.1, R25.1, U3.4 (E1)
unnamed: R17.1, R19.1, U3.5 (E2)
unnamed: R15.1, U4.2 (C1)
unnamed: R16.1, U4.3 (C2)
unnamed: R26.1, R28.1, U4.4 (E1)
unnamed: R20.1, R24.1, U4.5 (E2)

Notes on the sheet:
utiliser res 3k3
Motor stall current : 0.55A Aipropi = 1.5mA/A Ripropi = 3.33k => Vipropi@stall current = 2.75V Imotor max = 0.66A
pilotage du moteur par pwm et mos ref jlcpcb C2938374 remplacement translateurs niveau par eesx1321

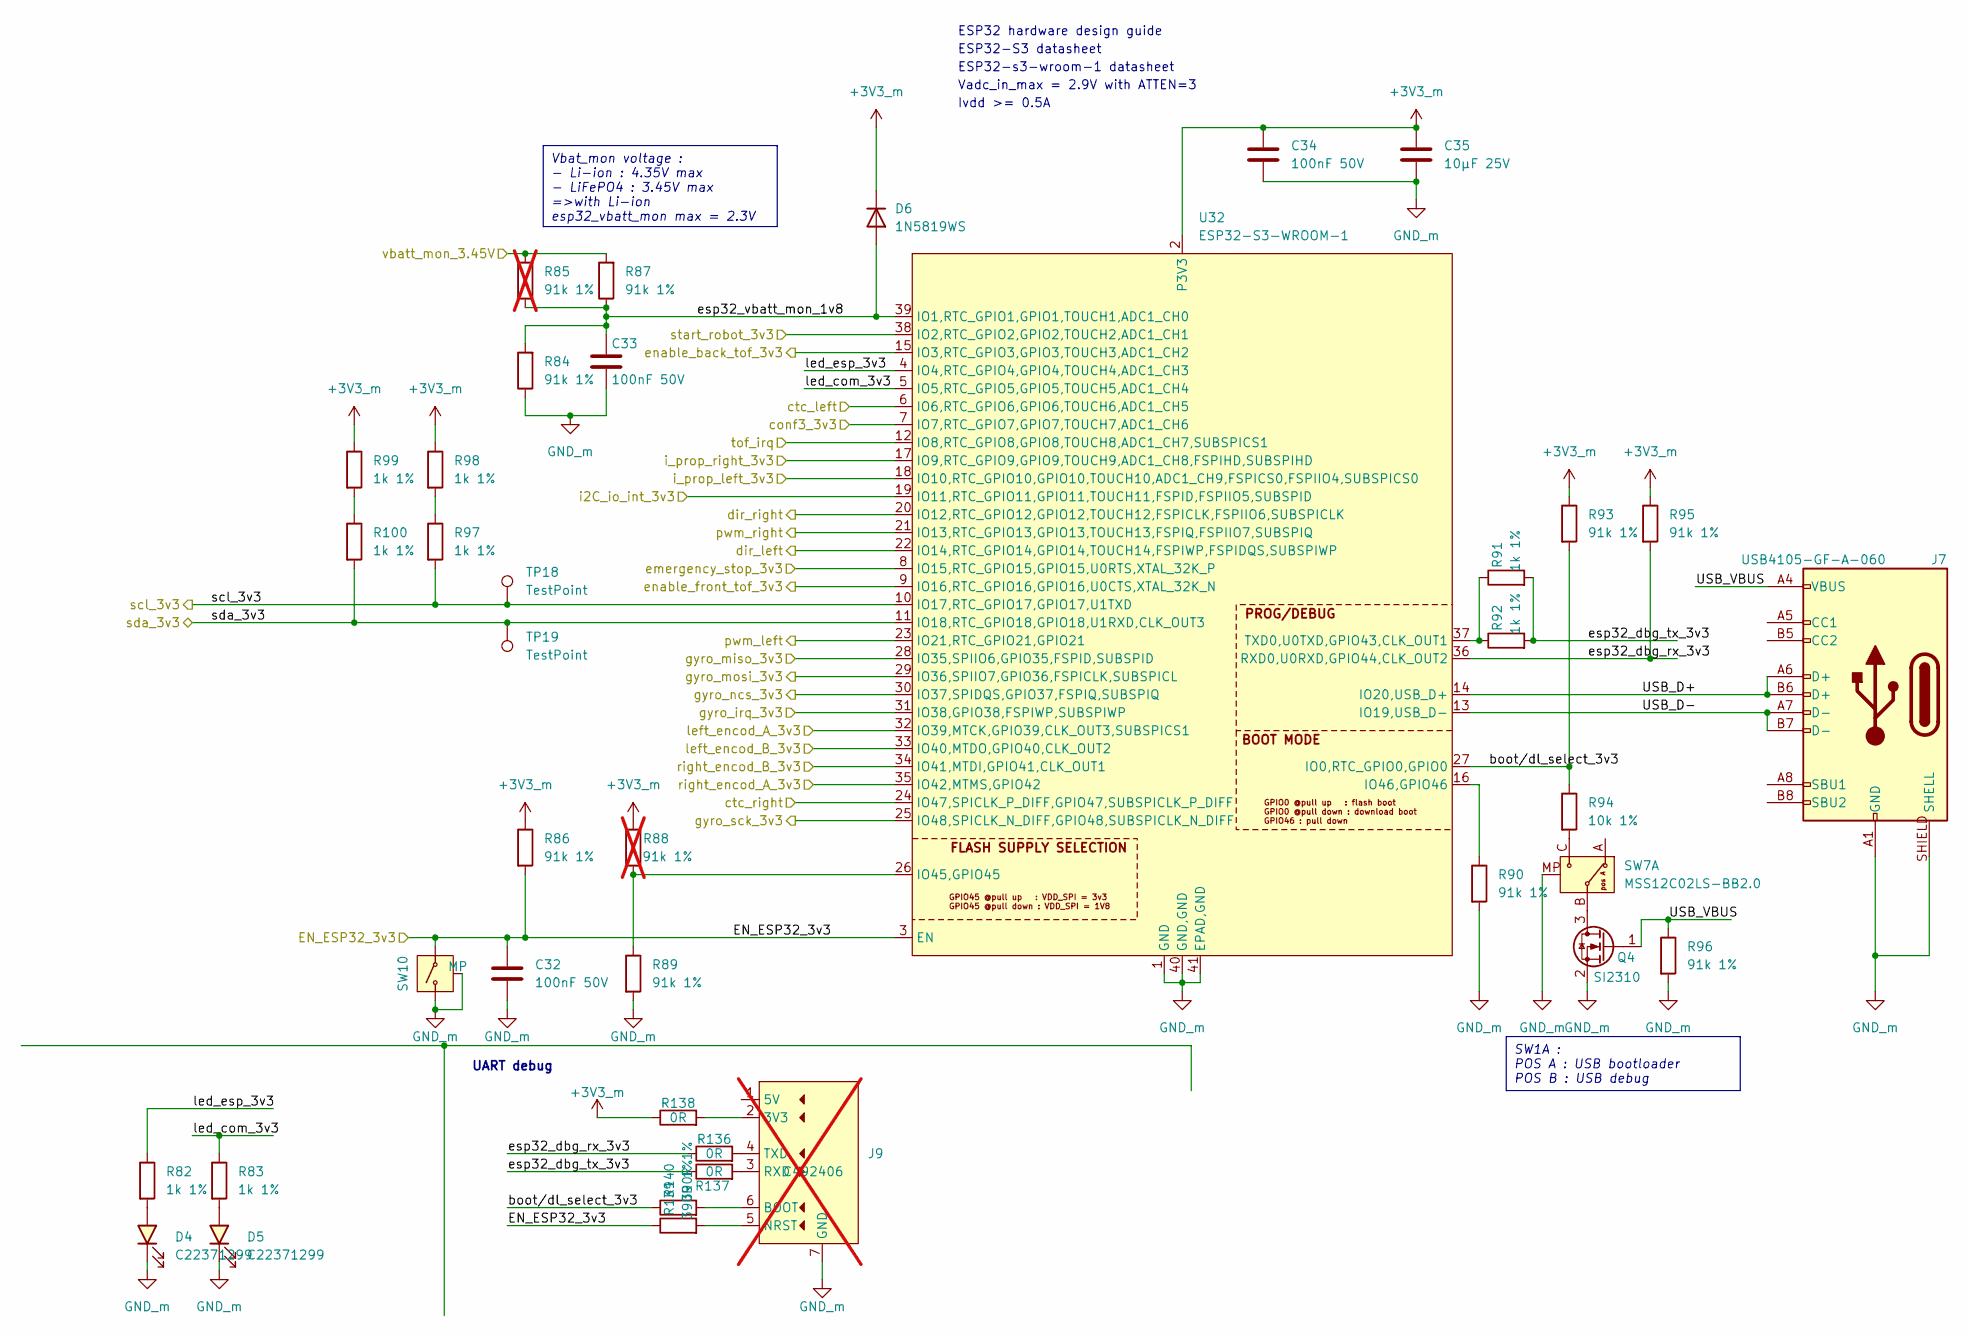
[picture p14: schematic com.kicad_sch]

Parts:
C32, C33, C34: 100nF 50V; C_0603_1608Metric; JLCPCB Part # C14663
C35: 10µF 25V; C_0805_2012Metric; JLCPCB Part # C15850
D4, D5: green, 0603; LED_0603_1608Metric; DIGIKEY_REF 3147-B19Y1UYG-20C000313U1930CT-ND
D6: 1N5819WS; D_SOD-323F; JLCPCB C191023
J7: USB4105-GF-A-060; USB4105; DIGIKEY_REF 2073-USB4105-GF-A-060TR-ND
J9: eps32_uart_programmer; JLCPCB Part # C492406; not fitted
Q4: SI2310; SOT-23-3; JLCPCB Part # C2938374
R82, R83, R91, R92, R97, R98, R99, R100: 1k 1%; r0603_reflow; mouser 603-RC0603FR-10100KL
R84, R86, R89, R90, R93, R95, R96: 91k 1%; r0603_reflow; JLCPCB Part # C23265
R85, R88: 91k 1%; r0603_reflow; JLCPCB Part # C23265; not fitted
R87: 91k 1%; r0603_reflow; mouser 603-RC0603FR-10100KL
R94: 10k 1%; r0603_reflow; mouser 603-RC0603FR-10100KL
R136, R137, R138: 0R; r0603_reflow; JLCPCB Part # C431718
R139, R140: 390R 1%; r0603_reflow; JLCPCB Part # C23151
SW7: MSS12C02LS-BB2.0; JLCPCB Part # C3008585
SW10: TSB001A3526A02; JLCPCB Part # C2888889
TP18, TP19: TestPoint; testpoint-THT-0.5mm
U32: ESP32-S3-WROOM-1; JLCPCB Part # C3013944

Connections:
+3V3_m: C34.1, C35.1, D6.1 (K), R86.1, R88.1, R93.1, R95.1, R98.1, R99.1, R138.1, U32.2 (P3V3); also elsewhere on the board
/boards interface/Sensor module/enable_back_tof_3v3: U32.15 (IO3,RTC_GPIO3,GPIO3,TOUCH3,ADC1_CH2); also elsewhere on the board
/boards interface/Sensor module/enable_front_tof_3v3: U32.9 (IO16,RTC_GPIO16,GPIO16,U0CTS,XTAL_32K_N); also elsewhere on the board
/boards interface/Sensor module/gyro_irq_3v3: U32.31 (IO38,GPIO38,FSPIWP,SUBSPIWP); also elsewhere on the board
/boards interface/Sensor module/gyro_miso_3v3: U32.28 (IO35,SPIIO6,GPIO35,FSPID,SUBSPID); also elsewhere on the board
/boards interface/Sensor module/gyro_mosi_3v3: U32.29 (IO36,SPIIO7,GPIO36,FSPICLK,SUBSPICL); also elsewhere on the board
/boards interface/Sensor module/gyro_ncs_3v3: U32.30 (IO37,SPIDQS,GPIO37,FSPIQ,SUBSPIQ); also elsewhere on the board
/boards interface/Sensor module/gyro_sck_3v3: U32.25 (IO48,SPICLK_N_DIFF,GPIO48,SUBSPICLK_N_D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); also elsewhere on the board
/boards interface/com/EN_ESP32_3v3: C32.1, R86.2, R139.1, SW10.2, U32.3 (EN)
/boards interface/com/USB_D+: J7.A6 (D+), J7.B6 (D+), U32.14 (IO20,USB_D+)
/boards interface/com/USB_D-: J7.A7 (D-), J7.B7 (D-), U32.13 (IO19,USB_D-)
/boards interface/com/USB_VBUS: J7.A4 (VBUS), J7.A9 (VBUS), J7.B4 (VBUS), J7.B9 (VBUS), Q4.1 (G), R96.1
/boards interface/com/boot/dl_select_3v3: R93.2, R94.1, R140.1, U32.27 (IO0,RTC_GPIO0,GPIO0)
/boards interface/com/ctc_left: U32.6 (IO6,RTC_GPIO6,GPIO6,TOUCH6,ADC1_CH5); also elsewhere on the board
/boards interface/com/ctc_right: U32.24 (IO47,SPICLK_P_DIFF,GPIO47,SUBSPICLK_P_D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); also elsewhere on the board
/boards interface/com/dir_left: U32.22 (IO14,RTC_GPIO14,GPIO14,TOUCH14,FSPIWP,F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); also elsewhere on the board
/boards interface/com/dir_right: U32.20 (IO12,RTC_GPIO12,GPIO12,TOUCH12,FSPICLK,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); also elsewhere on the board
/boards interface/com/emergency_stop_3v3: U32.8 (IO15,RTC_GPIO15,GPIO15,U0RTS,XTAL_32K_P); also elsewhere on the board
/boards interface/com/esp32_dbg_rx_3v3: R95.2, R136.1, U32.36 (RXD0,U0RXD,GPIO44,CLK_OUT2)
/boards interface/com/esp32_dbg_tx_3v3: R91.2, R92.2, R137.1
/boards interface/com/esp32_vbatt_mon_1v8: C33.1, D6.2 (A), R84.2, R85.1, R87.1, U32.39 (IO1,RTC_GPIO1,GPIO1,TOUCH1,ADC1_CH0)
/boards interface/com/i_prop_left_3v3: U32.18 (IO10,RTC_GPIO10,GPIO10,TOUCH10,ADC1_CH9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); also elsewhere on the board
/boards interface/com/i_prop_right_3v3: U32.17 (IO9,RTC_GPIO9,GPIO9,TOUCH9,ADC1_CH8,FSP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); also elsewhere on the board
/boards interface/com/led_com_3v3: R83.1, U32.5 (IO5,RTC_GPIO5,GPIO5,TOUCH5,ADC1_CH4)
/boards interface/com/led_esp_3v3: R82.1, U32.4 (IO4,RTC_GPIO4,GPIO4,TOUCH4,ADC1_CH3)
/boards interface/com/left_encod_A_3v3: U32.32 (IO39,MTCK,GPIO39,CLK_OUT3,SUBSPICS1); also elsewhere on the board
/boards interface/com/left_encod_B_3v3: U32.33 (IO40,MTDO,GPIO40,CLK_OUT2); also elsewhere on the board
/boards interface/com/pwm_left: U32.23 (IO21,RTC_GPIO21,GPIO21); also elsewhere on the board
/boards interface/com/pwm_right: U32.21 (IO13,RTC_GPIO13,GPIO13,TOUCH13,FSPIQ,FS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); also elsewhere on the board
/boards interface/com/right_encod_A_3v3: U32.35 (IO42,MTMS,GPIO42); also elsewhere on the board
/boards interface/com/right_encod_B_3v3: U32.34 (IO41,MTDI,GPIO41,CLK_OUT1); also elsewhere on the board
/boards interface/com/start_robot_3v3: U32.38 (IO2,RTC_GPIO2,GPIO2,TOUCH2,ADC1_CH1); also elsewhere on the board
/boards interface/com/vbatt_mon_3.45V: R85.2, R87.2; also elsewhere on the board
/boards interface/i2c_io_int_3v3: U32.19 (IO11,RTC_GPIO11,GPIO11,TOUCH11,FSPID,FS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); also elsewhere on the board
/boards interface/interface/conf3: U32.7 (IO7,RTC_GPIO7,GPIO7,TOUCH7,ADC1_CH6); also elsewhere on the board
/boards interface/scl_top_3v3: R97.2, TP18.1, U32.10 (IO17,RTC_GPIO17,GPIO17,U1TXD); also elsewhere on the board
/boards interface/sda_top_3v3: R100.2, TP19.1, U32.11 (IO18,RTC_GPIO18,GPIO18,U1RXD,CLK_OUT3); also elsewhere on the board
/boards interface/tof_irq_3v3: U32.12 (IO8,RTC_GPIO8,GPIO8,TOUCH8,ADC1_CH7,SUB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); also elsewhere on the board
GND_m: C32.2, C33.2, C34.2, C35.2, D4.C, D5.C, J7.A1 (GND), J7.A12 (GND), J7.B1 (GND), J7.B12 (GND), J7.SHIELD (SHELL), J9.7 (GND), Q4.2 (S), R84.1, R89.2, R90.2, R96.2, SW7.MP, SW10.1, SW10.MP, U32.1 (GND), U32.40 (GND,GND), U32.41 (EPAD,GND); also elsewhere on the board
unnamed: D4.A, R82.2
unnamed: D5.A, R83.2
unnamed: J9.2 (3V3), R138.2
unnamed: J9.6 (BOOT), R140.2
unnamed: J9.5 (NRST), R139.2
unnamed: J9.3 (RXD), R137.2
unnamed: J9.4 (TXD), R136.2
unnamed: Q4.3 (D), SW7.B
unnamed: R94.2, SW7.C
unnamed: R97.1, R98.2
unnamed: R99.2, R100.1
unnamed: R88.2, R89.1, U32.26 (IO45,GPIO45)
unnamed: R90.1, U32.16 (IO46,GPIO46)
unnamed: R91.1, R92.1, U32.37 (TXD0,U0TXD,GPIO43,CLK_OUT1)

Notes on the sheet:
Vbat_mon voltage : - Li-ion : 4.35V max - LiFePO4 : 3.45V max =>with Li-ion esp32_vbatt_mon max = 2.3V
SW1A : POS A : USB bootloader POS B : USB debug
ESP32-s3-wroom-1 datasheet
ESP32-S3 datasheet
ESP32 hardware design guide
UART debug
Ivdd >= 0.5A
Vadc_in_max = 2.9V with ATTEN=3

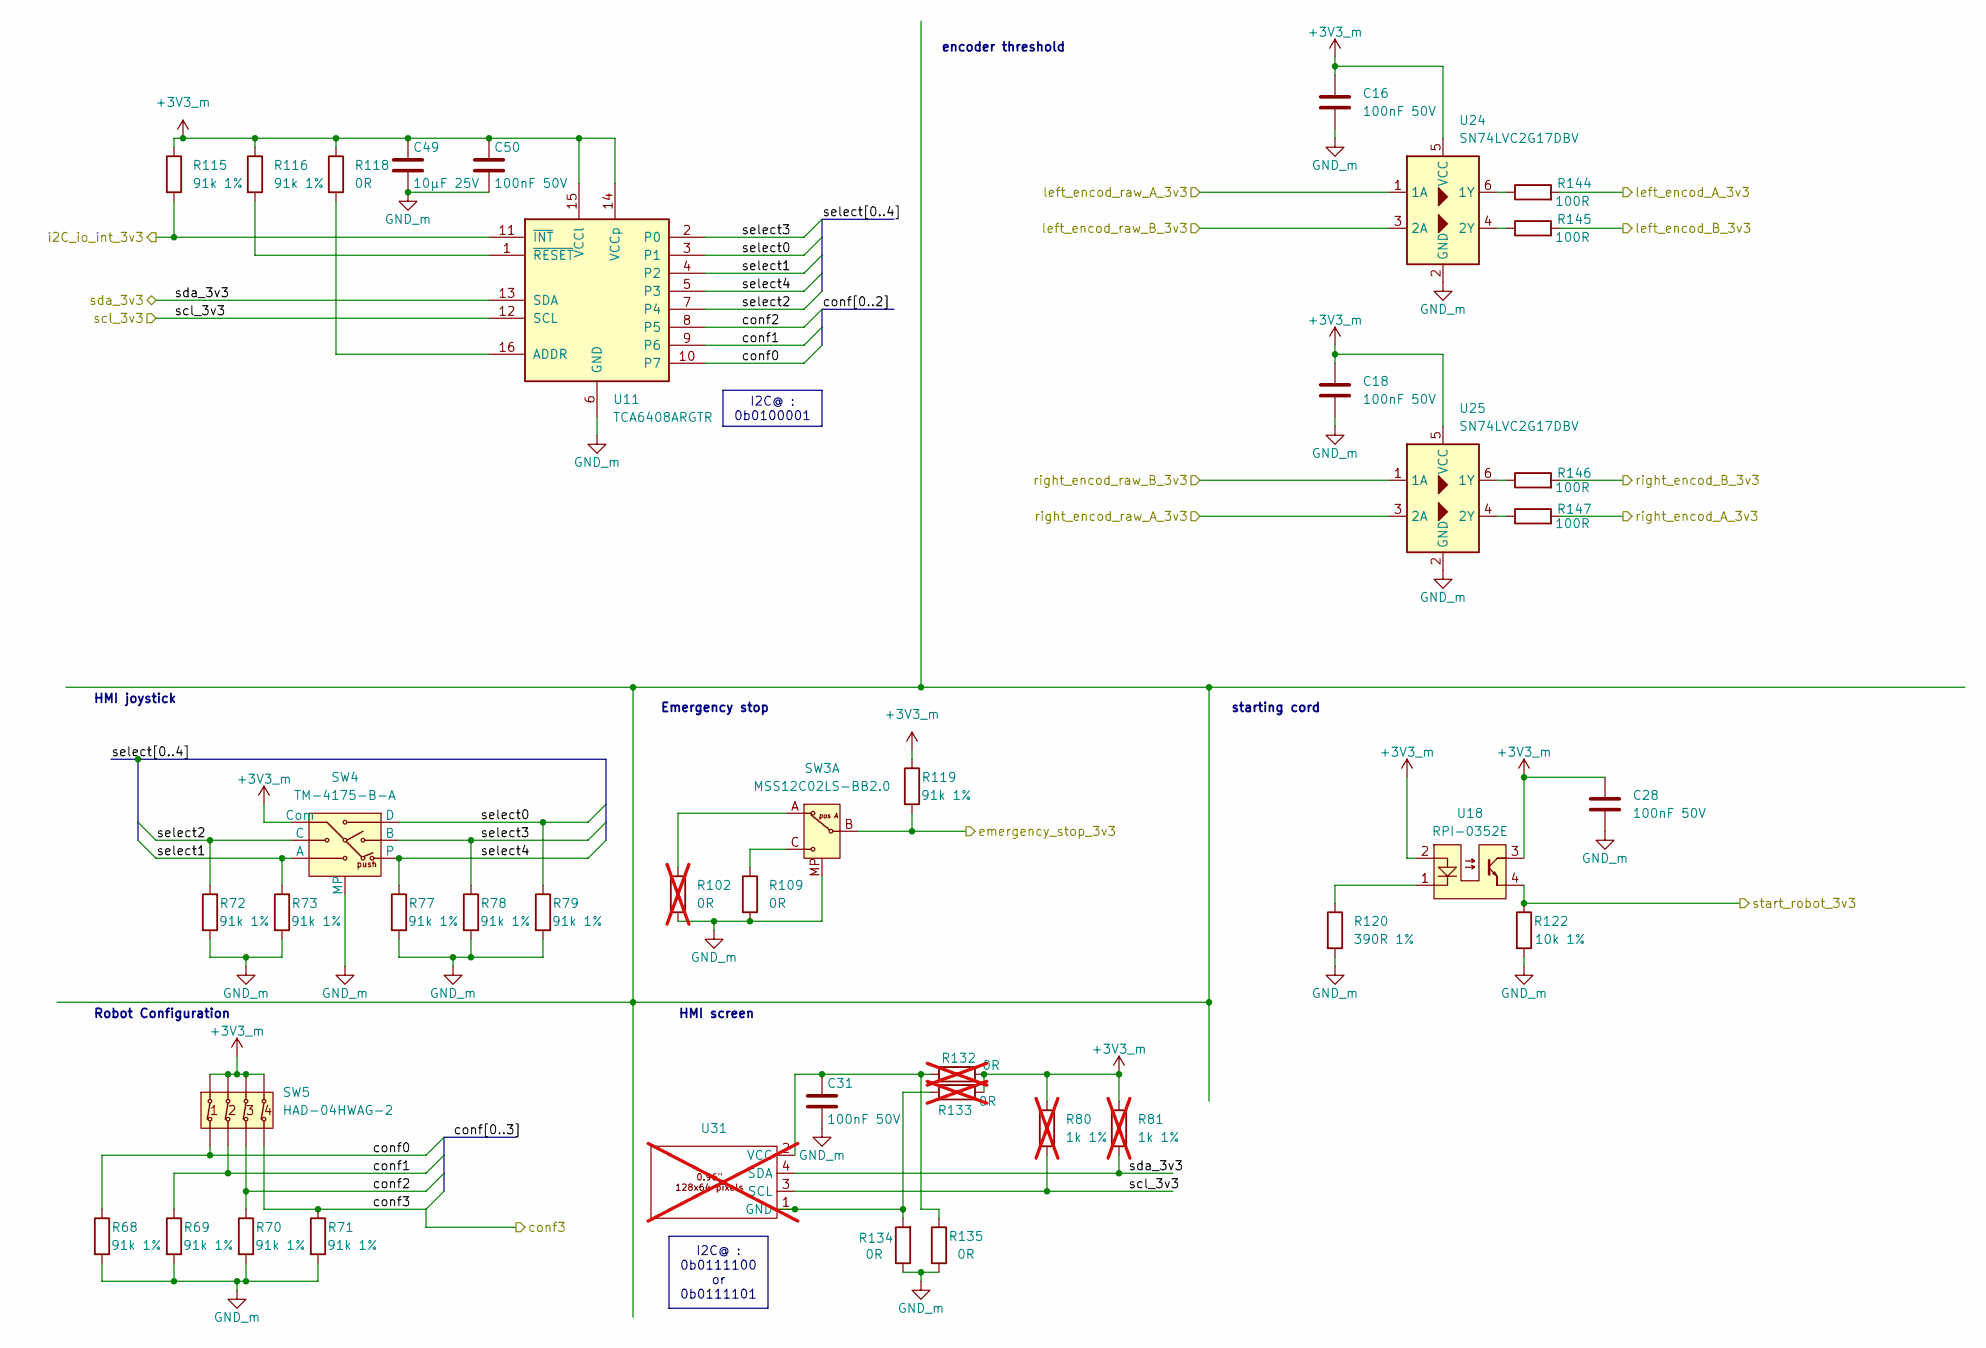
[picture p15: schematic interface.kicad_sch]

Parts:
C16, C18, C28, C31, C50: 100nF 50V; C_0603_1608Metric; JLCPCB Part # C14663
C49: 10µF 25V; C_0805_2012Metric; JLCPCB Part # C15850
R68, R69, R70, R71, R72, R73, R77, R78, R79, R115, R116, R119: 91k 1%; r0603_reflow; JLCPCB Part # C23265
R80, R81: 1k 1%; r0603_reflow; mouser 603-RC0603FR-10100KL; not fitted
R102, R132, R133: 0R; r0603_reflow; JLCPCB Part # C431718; not fitted
R109, R118, R134, R135: 0R; r0603_reflow; JLCPCB Part # C431718
R120: 390R 1%; r0603_reflow; mouser 603-RC0603FR-10100KL
R122: 10k 1%; r0603_reflow; mouser 603-RC0603FR-10100KL
R144, R145, R146, R147: 100R; r0603_reflow; JLCPCB Part # C22775
SW3: MSS12C02LS-BB2.0; JLCPCB Part # C3008585
SW4: TM-4175-B-A; DIGIKEY_REF 450-2425755-1TR-ND
SW5: HAD-04HWAG-2; JLCPCB Part # C437204
U11: TCA6408ARGTR; VQFN-16-1EP_3x3mm_P0.5mm_EP1.1x1.1mm; mouser 595-TCA6408ARGTR
U18: RPI-0352E; JLCPCB Part # C509307
U24, U25: SN74LVC2G17DBV; SOT-23-6
U31: OLED_0.96inch; not fitted

Connections:
+3V3_m: C16.1, C18.1, C28.1, C49.1, C50.1, R80.1, R81.1, R115.1, R116.1, R118.1, R119.1, R132.2, R133.2, SW4.5 (Com), SW5.5, SW5.6, SW5.7, SW5.8, U11.14 (VCCp), U11.15 (VCCl), U18.2 (A), U18.3 (C), U24.5 (VCC), U25.5 (VCC); also elsewhere on the board
/boards interface/com/emergency_stop_3v3: R119.2, SW3.B; also elsewhere on the board
/boards interface/com/left_encod_A_3v3: R144.2; also elsewhere on the board
/boards interface/com/left_encod_B_3v3: R145.2; also elsewhere on the board
/boards interface/com/right_encod_A_3v3: R147.2; also elsewhere on the board
/boards interface/com/right_encod_B_3v3: R146.2; also elsewhere on the board
/boards interface/com/start_robot_3v3: R122.1, U18.4 (E); also elsewhere on the board
/boards interface/i2c_io_int_3v3: R115.2, U11.11 (~INT); also elsewhere on the board
/boards interface/interface/conf0: R68.1, SW5.1, U11.10 (P7)
/boards interface/interface/conf1: R69.1, SW5.2, U11.9 (P6)
/boards interface/interface/conf2: R70.1, SW5.3, U11.8 (P5)
/boards interface/interface/conf3: R71.1, SW5.4; also elsewhere on the board
/boards interface/interface/select0: R79.1, SW4.6 (D), U11.3 (P1)
/boards interface/interface/select1: R73.1, SW4.1 (A), U11.4 (P2)
/boards interface/interface/select2: R72.1, SW4.3 (C), U11.7 (P4)
/boards interface/interface/select3: R78.1, SW4.4 (B), U11.2 (P0)
/boards interface/interface/select4: R77.1, SW4.2, U11.5 (P3)
/boards interface/left_encod_raw_A_3v3: U24.1 (1A); also elsewhere on the board
/boards interface/left_encod_raw_B_3v3: U24.3 (2A); also elsewhere on the board
/boards interface/right_encod_raw_A_3v3: U25.3 (2A); also elsewhere on the board
/boards interface/right_encod_raw_B_3v3: U25.1 (1A); also elsewhere on the board
/boards interface/scl_top_3v3: R80.2, U11.12 (SCL), U31.3 (SCL); also elsewhere on the board
/boards interface/sda_top_3v3: R81.2, U11.13 (SDA), U31.4 (SDA); also elsewhere on the board
GND_m: C16.2, C18.2, C28.2, C31.2, C49.2, C50.2, R68.2, R69.2, R70.2, R71.2, R72.2, R73.2, R77.2, R78.2, R79.2, R102.2, R109.2, R120.2, R122.2, R134.1, R135.2, SW3.MP, SW4.MP, U11.6 (GND), U24.2 (GND), U25.2 (GND); also elsewhere on the board
unnamed: R102.1, SW3.A
unnamed: R109.1, SW3.C
unnamed: R120.1, U18.1 (C)
unnamed: R118.2, U11.16 (ADDR)
unnamed: R116.2, U11.1 (~RESET)
unnamed: R144.1, U24.6 (1Y)
unnamed: R145.1, U24.4 (2Y)
unnamed: R146.1, U25.6 (1Y)
unnamed: R147.1, U25.4 (2Y)
unnamed: R133.1, R134.2, U31.1 (GND)
unnamed: C31.1, R132.1, R135.1, U31.2 (VCC)

Notes on the sheet:
I2C@ : 0b0111100 or 0b0111101
I2C@ : 0b0100001
Emergency stop
HMI screen
Robot Configuration
HMI joystick
encoder threshold
starting cord

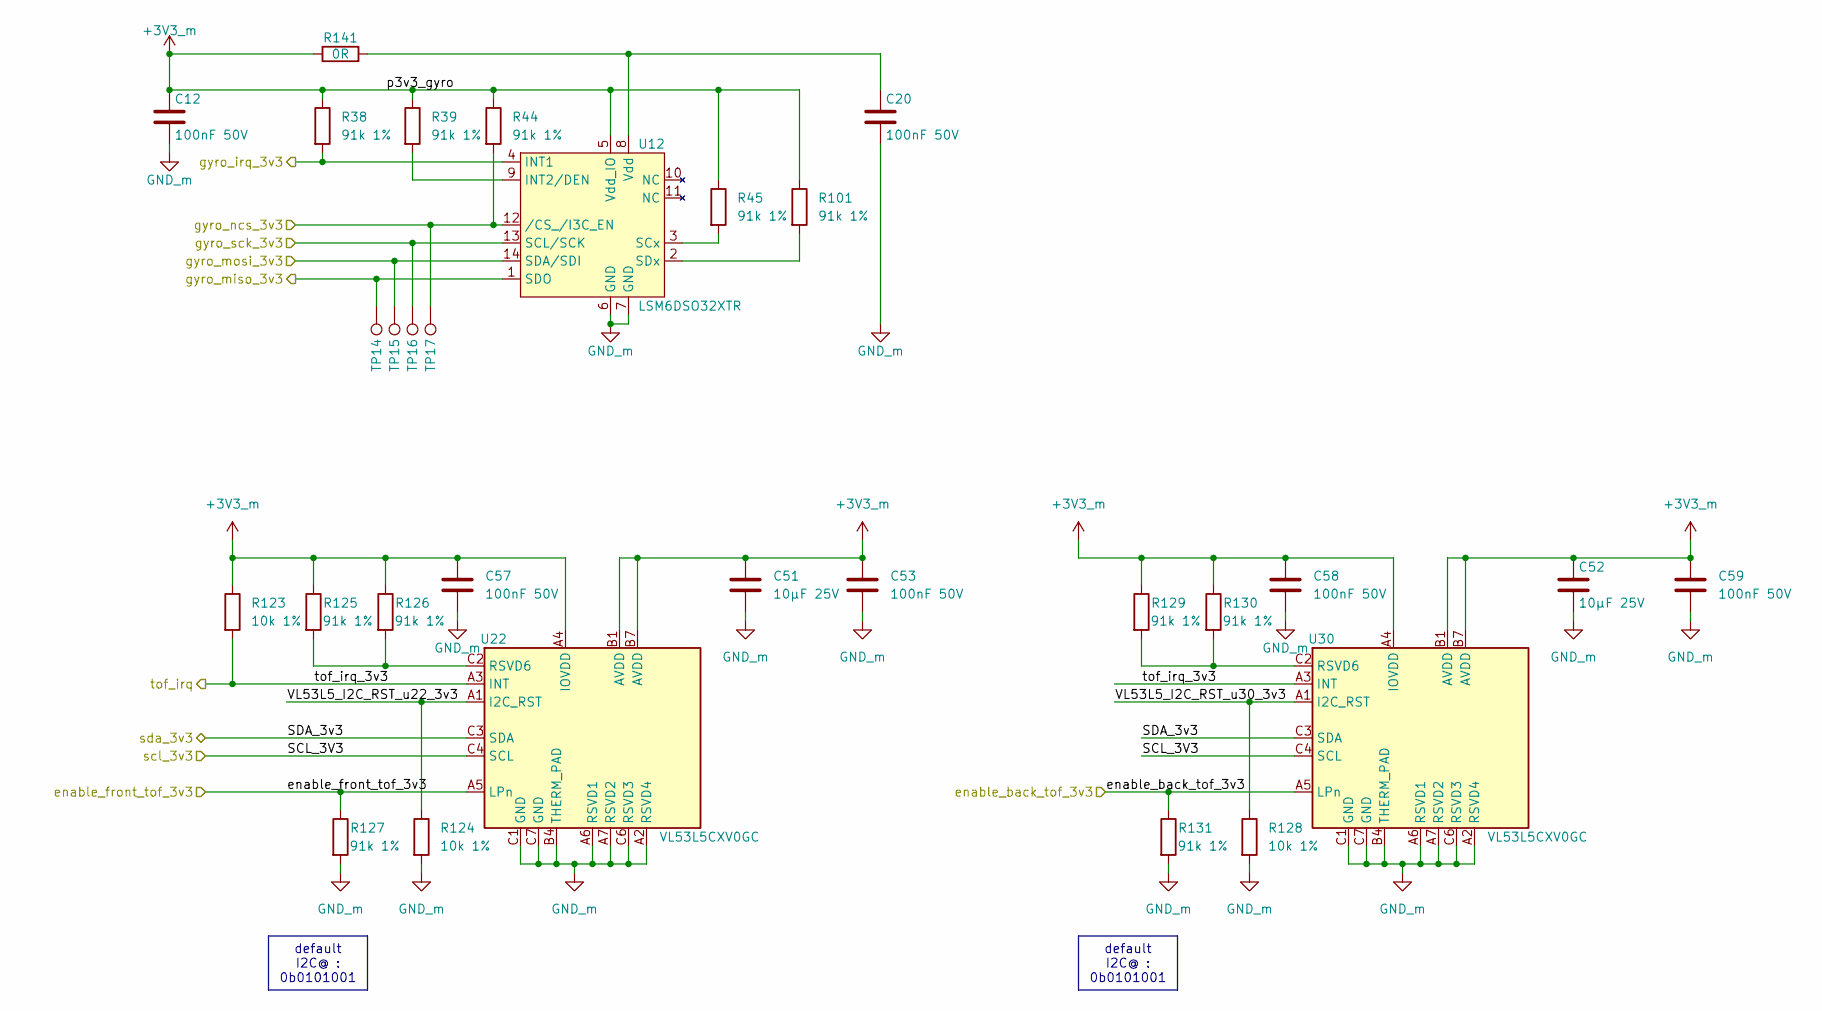
[picture p16: schematic sensor_module.kicad_sch]

Parts:
C12, C20, C53, C57, C58, C59: 100nF 50V; C_0603_1608Metric; JLCPCB Part # C14663
C51, C52: 10µF 25V; C_0805_2012Metric; JLCPCB Part # C15850
R38, R39, R44, R45, R101, R125, R126, R127, R129, R130, R131: 91k 1%; r0603_reflow; JLCPCB Part # C23265
R123, R124, R128: 10k 1%; r0603_reflow; mouser 603-RC0603FR-10100KL
R141: 0R; r0603_reflow; JLCPCB Part # C431718
TP14, TP15, TP16, TP17: TestPoint; testpoint-THT-0.5mm
U12: LSM6DSO32XTR; LGA-14_3x2.5mm_P0.5mm_LayoutBorder3x4y; JLCPCB Part # C2655100
U22, U30: VL53L5CXV0GC; VL53L5CX; JLCPCB Part # C3178303

Connections:
+3V3_m: C12.1, C51.1, C52.1, C53.1, C57.1, C58.1, C59.1, R38.1, R39.1, R44.1, R45.1, R101.1, R123.1, R125.1, R126.1, R129.1, R130.1, R141.1, U12.5 (Vdd_IO), U22.A4 (IOVDD), U22.B1 (AVDD), U22.B7 (AVDD), U30.A4 (IOVDD), U30.B1 (AVDD), U30.B7 (AVDD); also elsewhere on the board
/boards interface/Sensor module/VL53L5_I2C_RST_u22_3v3: R124.1, U22.A1 (I2C_RST)
/boards interface/Sensor module/VL53L5_I2C_RST_u30_3v3: R128.1, U30.A1 (I2C_RST)
/boards interface/Sensor module/enable_back_tof_3v3: R131.1, U30.A5 (LPn); also elsewhere on the board
/boards interface/Sensor module/enable_front_tof_3v3: R127.1, U22.A5 (LPn); also elsewhere on the board
/boards interface/Sensor module/gyro_irq_3v3: R38.2, U12.4 (INT1); also elsewhere on the board
/boards interface/Sensor module/gyro_miso_3v3: TP14.1, U12.1 (SDO); also elsewhere on the board
/boards interface/Sensor module/gyro_mosi_3v3: TP15.1, U12.14 (SDA/SDI); also elsewhere on the board
/boards interface/Sensor module/gyro_ncs_3v3: R44.2, TP17.1, U12.12 (/CS_/I3C_EN); also elsewhere on the board
/boards interface/Sensor module/gyro_sck_3v3: TP16.1, U12.13 (SCL/SCK); also elsewhere on the board
/boards interface/scl_top_3v3: U22.C4 (SCL), U30.C4 (SCL); also elsewhere on the board
/boards interface/sda_top_3v3: U22.C3 (SDA), U30.C3 (SDA); also elsewhere on the board
/boards interface/tof_irq_3v3: R123.2, U22.A3 (INT), U30.A3 (INT); also elsewhere on the board
GND_m: C12.2, C20.2, C51.2, C52.2, C53.2, C57.2, C58.2, C59.2, R124.2, R127.2, R128.2, R131.2, U12.6 (GND), U12.7 (GND), U22.A2 (RSVD4), U22.A6 (RSVD1), U22.A7 (RSVD2), U22.B4 (THERM_PAD), U22.C1 (GND), U22.C6 (RSVD3), U22.C7 (GND), U30.A2 (RSVD4), U30.A6 (RSVD1), U30.A7 (RSVD2), U30.B4 (THERM_PAD), U30.C1 (GND), U30.C6 (RSVD3), U30.C7 (GND); also elsewhere on the board
unnamed: R39.2, U12.9 (INT2/DEN)
unnamed: R45.2, U12.3 (SCx)
unnamed: R101.2, U12.2 (SDx)
unnamed: C20.1, R141.2, U12.8 (Vdd)
unnamed: R125.2, R126.2, U22.C2 (RSVD6)
unnamed: R129.2, R130.2, U30.C2 (RSVD6)

Notes on the sheet:
default I2C@ : 0b0101001

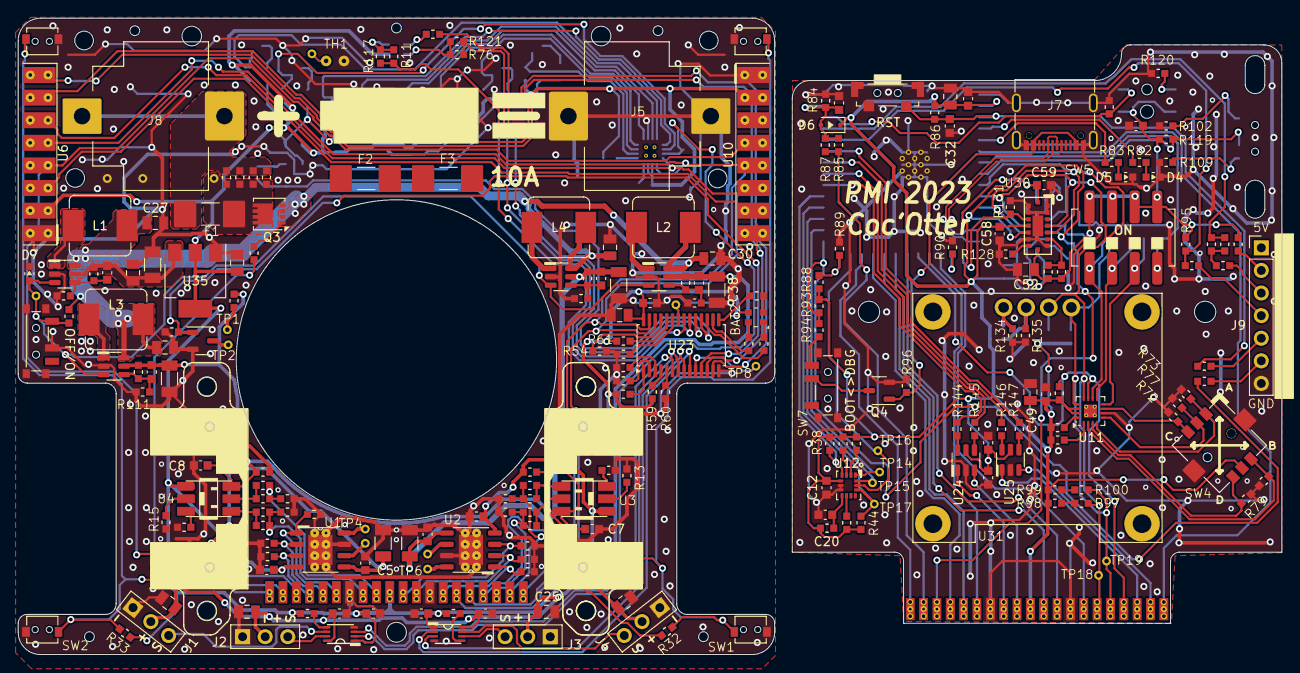
[picture p17: board pmi_2023.kicad_pcb from above]

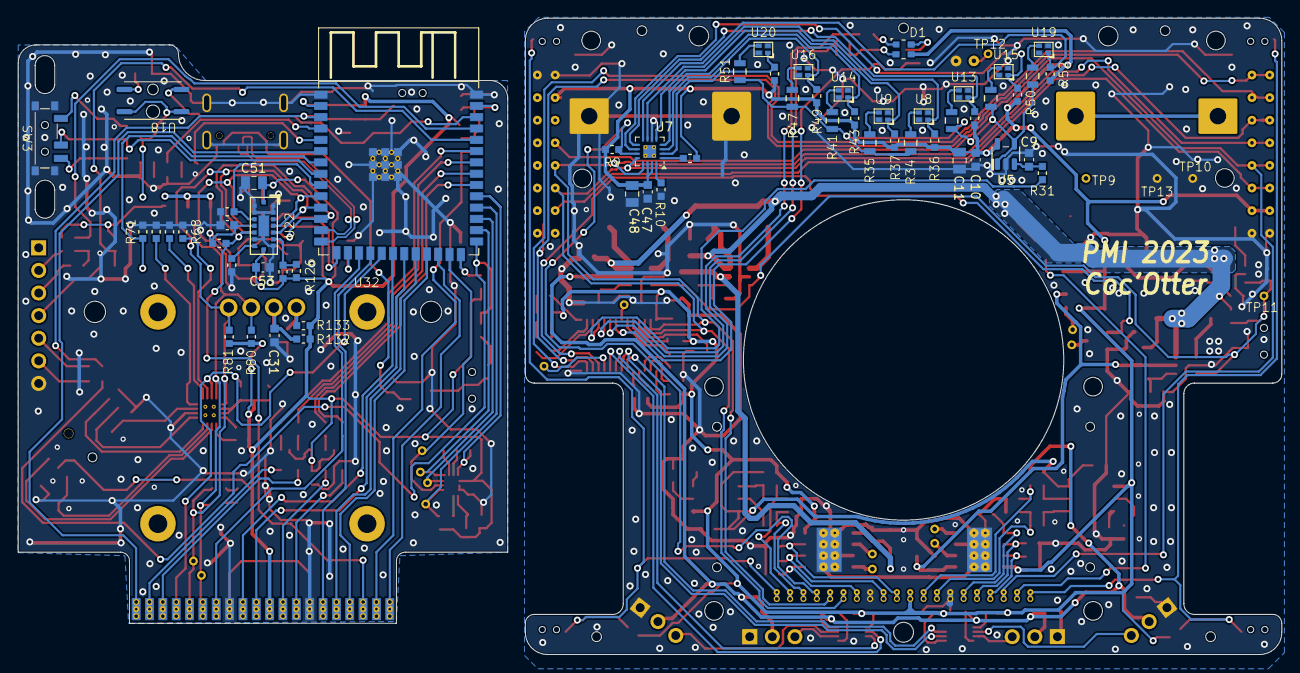
[picture p18: board pmi_2023.kicad_pcb from below]

Board: 2 copper layers, 142.0 x 71.5 mm, 294 parts (62 on the bottom side), 192 nets.
