cocobot/cocotter/elec/hw/cartes/pmi_2023/pmi_tof_sensor/pmi_tof_sensor.kicad_pcb

## KiCad design elec/hw/cartes/pmi_2023/pmi_tof_sensor/pmi_tof_sensor.kicad_pcb (2024-11-04)

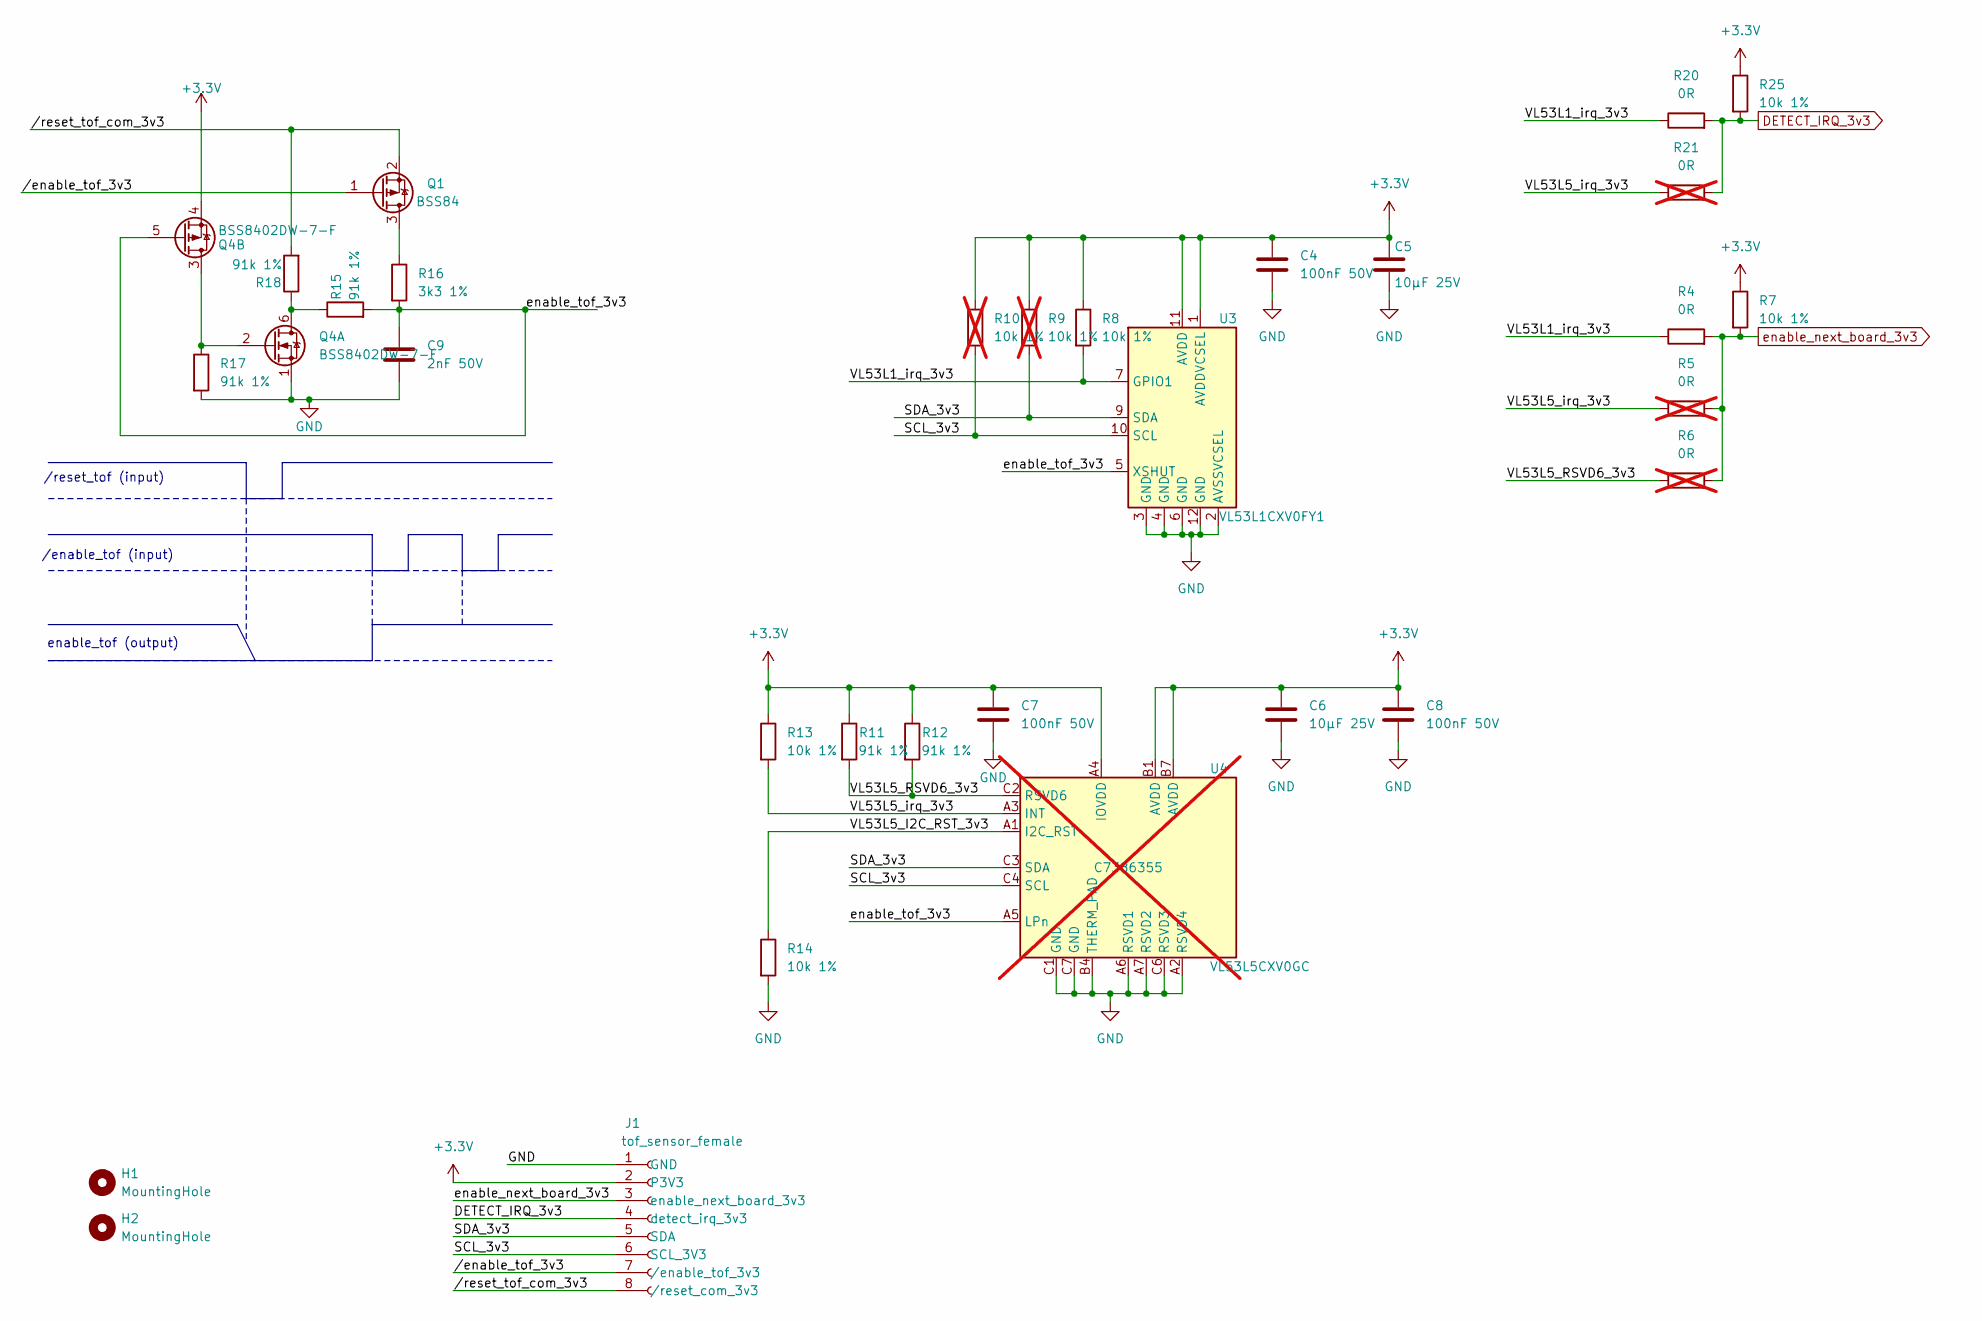
[picture p19: schematic pmi_tof_sensor.kicad_sch]

Parts:
C4, C7, C8: 100nF 50V; C_0603_1608Metric; JLCPCB C14663
C5, C6: 10µF 25V; C_0805_2012Metric; JLCPCB C15850
C9: 2nF 50V; C_0603_1608Metric; JLCPCB C1588
H1, H2: MountingHole; MountingHole_2.5mm-slot_1mm
J1: tof_sensor_female
Q1: BSS84; SOT-23-3
Q4: BSS8402DW-7-F; SOT-363_SC-70-6
R4, R20: 0R; r0603_reflow; JLCPCB C431718
R5, R6, R21: 0R; r0603_reflow; JLCPCB C431718; not fitted
R7, R8, R13, R14, R25: 10k 1%; r0603_reflow; mouser 603-RC0603FR-10100KL
R9, R10: 10k 1%; r0603_reflow; mouser 603-RC0603FR-10100KL; not fitted
R11, R12, R15, R17, R18: 91k 1%; r0603_reflow; JLCPCB Part # C23265
R16: 3k3 1%; r0603_reflow; JLCPCB C22978
U3: VL53L1CXV0FY1; ST_VL53L1x; JLCPCB C190004
U4: VL53L5CXV0GC; VL53L5CX; JLCPCB C7386355; not fitted

Connections:
+3.3V: C4.2, C5.1, C6.1, C7.1, C8.1, J1.2 (P3V3), Q4.4 (SP), R7.1, R8.1, R9.1, R10.1, R11.1, R12.1, R13.1, R25.1, U3.1 (AVDDVCSEL), U3.11 (AVDD), U4.A4 (IOVDD), U4.B1 (AVDD), U4.B7 (AVDD)
/SCL_3v3: J1.6 (SCL_3V3), R10.2, U3.10 (SCL), U4.C4 (SCL)
/SDA_3v3: J1.5 (SDA), R9.2, U3.9 (SDA), U4.C3 (SDA)
/VL53L1_irq_3v3: R4.1, R8.2, R20.1, U3.7 (GPIO1)
/VL53L5_I2C_RST_3v3: R14.1, U4.A1 (I2C_RST)
/VL53L5_RSVD6_3v3: R6.1, R11.2, R12.2, U4.C2 (RSVD6)
/VL53L5_irq_3v3: R5.1, R13.2, R21.1, U4.A3 (INT)
/enable_tof_3v3: C9.1, Q4.5 (GP), R15.2, R16.2, U3.5 (XSHUT), U4.A5 (LPn)
//enable_tof_3v3: J1.7 (/enable_tof_3v3), Q1.1 (G)
//reset_tof_com_3v3: J1.8 (/reset_com_3v3), Q1.2 (S), R18.2
DETECT_IRQ_3v3: J1.4 (detect_irq_3v3), R20.2, R21.2, R25.2
GND: C4.1, C5.2, C6.2, C7.2, C8.2, C9.2, J1.1 (GND), Q4.1 (SN), R14.2, R17.2, U3.2 (AVSSVCSEL), U3.3 (GND), U3.4 (GND), U3.6 (GND), U3.12 (GND), U4.A2 (RSVD4), U4.A6 (RSVD1), U4.A7 (RSVD2), U4.B4 (THERM_PAD), U4.C1 (GND), U4.C6 (RSVD3), U4.C7 (GND)
unnamed: Q1.3 (D), R16.1
unnamed: Q4.6 (DN), R15.1, R18.1
unnamed: Q4.2 (GN), Q4.3 (DP), R17.1
enable_next_board_3v3: J1.3 (enable_next_board_3v3), R4.2, R5.2, R6.2, R7.2

Notes on the sheet:
/enable_tof (input)
/reset_tof (input)
enable_tof (output)

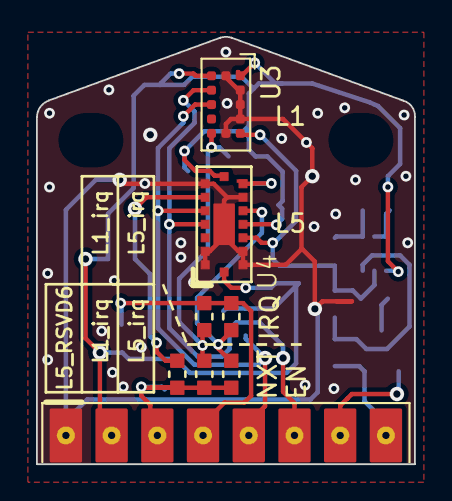
[picture p20: board pmi_tof_sensor.kicad_pcb from above]

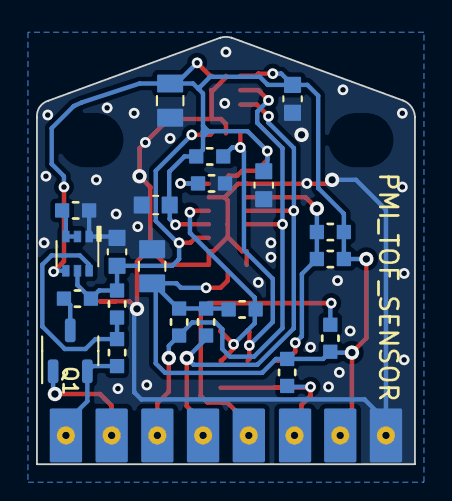
[picture p21: board pmi_tof_sensor.kicad_pcb from below]

Board: 2 copper layers, 21.0 x 23.7 mm, 31 parts (21 on the bottom side), 16 nets.
