cocobot/cocotter/elec/hw/cartes/pmi_charger_2023/pmi_charger_2023.kicad_pcb

## KiCad design elec/hw/cartes/pmi_charger_2023/pmi_charger_2023.kicad_pcb (2024-06-17)

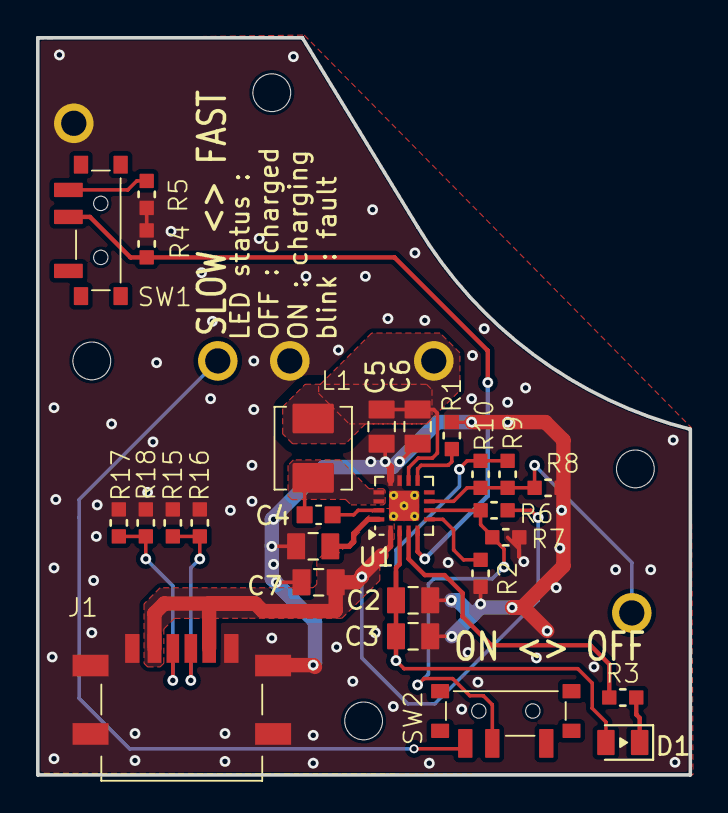
[picture p22: board pmi_charger_2023.kicad_pcb from above]

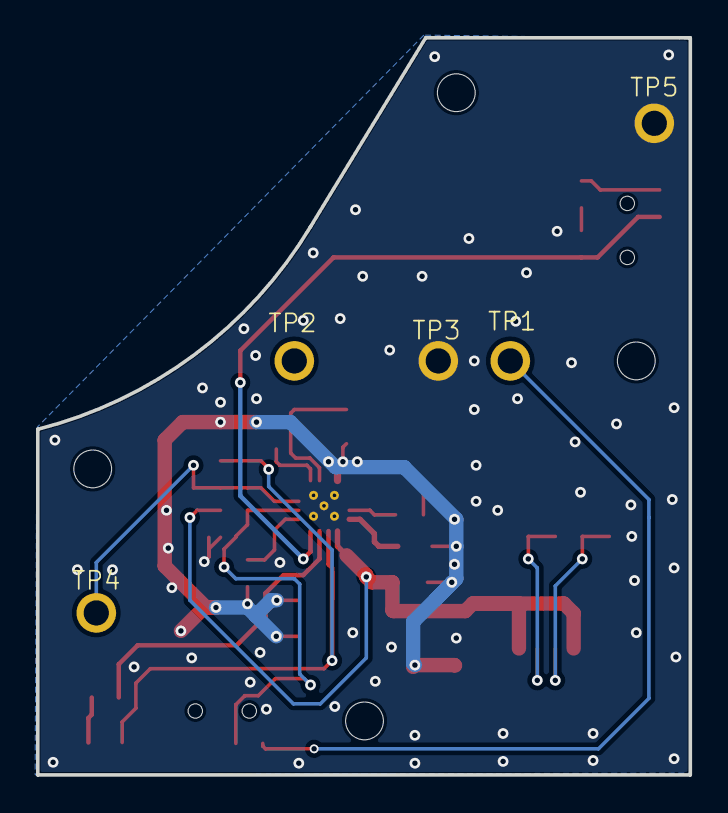
[picture p23: board pmi_charger_2023.kicad_pcb from below]

Board: 2 copper layers, 36.2 x 41.0 mm, 36 parts (5 on the bottom side), 18 nets.

Parts:
C1, C5, C6, C7: 10µF 25V; C_0805_2012Metric
C2, C3: 1µF 50V; C_0805_2012Metric
C4: 47nF 50V; C_0603_1608Metric
D1: yellow, 0805; LED_0805_2012Metric
H1, H2, H3, H4: MountingHole_Pad; MountingHole_2.1mm
J1: BTC-TC6S-23
L1: 1µH; SPM4020T
R1: 100k; r0603_reflow
R2: 1k 1%; r0603_reflow
R3: 330R; r0603_reflow
R4: 68k 1%; r0603_reflow
R5, R8: 22k 1%; r0603_reflow
R6, R7, R9, R10, R15, R16, R17, R18: 10k 1%; r0603_reflow
SW1, SW2: MSS12C02LS-BB2.0
TP1, TP2, TP3, TP4, TP5: CPG-07-TH-B
U1: BQ25308RTER; RTE0016C

Connections:
/BAT_TEMP: R8.1, R9.2, R10.2, TP4.1, U1.7 (TS)
/ICHG: R4.1, SW1.B, U1.4 (ICHG)
/POL: R2.1, U1.5 (POL)
/REGN: C2.1, C3.1, D1.A, R9.1, R10.1, U1.2 (REGN)
/bat+: C5.1, C6.1, L1.2, TP2.1, U1.10 (BAT)
/sw: C4.1, L1.1, U1.13 (SW), U1.14 (SW)
//enable_charger: R6.2, R7.2, SW2.B, U1.6 (/EN)
GND: C1.2, C2.2, C3.2, C5.2, C6.2, C7.2, J1.A12 (GND), J1.B12 (GND), J1.SHIELD (SHELL), R1.2, R2.2, R4.2, R5.2, R7.1, R8.2, R15.2, R16.2, R17.2, R18.2, TP3.1, TP5.1, U1.11 (GND), U1.12 (GND), U1.17 (PAD)
unnamed: D1.C, R3.2
unnamed: J1.A5 (CC1), R17.1, R18.1
unnamed: J1.B5 (CC2), R15.1, R16.1
unnamed: R5.1, SW1.C
unnamed: SW2.C, TP1.1
unnamed: C4.2, U1.15 (BTST)
unnamed: C1.1, U1.16 (PMID)
unnamed: R3.1, U1.3 (STAT)
unnamed: R1.1, U1.9 (VSET)
VBUS: C7.1, J1.A9 (VBUS), J1.B9 (VBUS), R6.1, U1.1 (VBUS)
