cocobot/cocotter/elec/hw/cartes/canon_2019/canon_2019.kicad_pcb

## KiCad design elec/hw/cartes/canon_2019/canon_2019.kicad_pcb (2023-08-31)

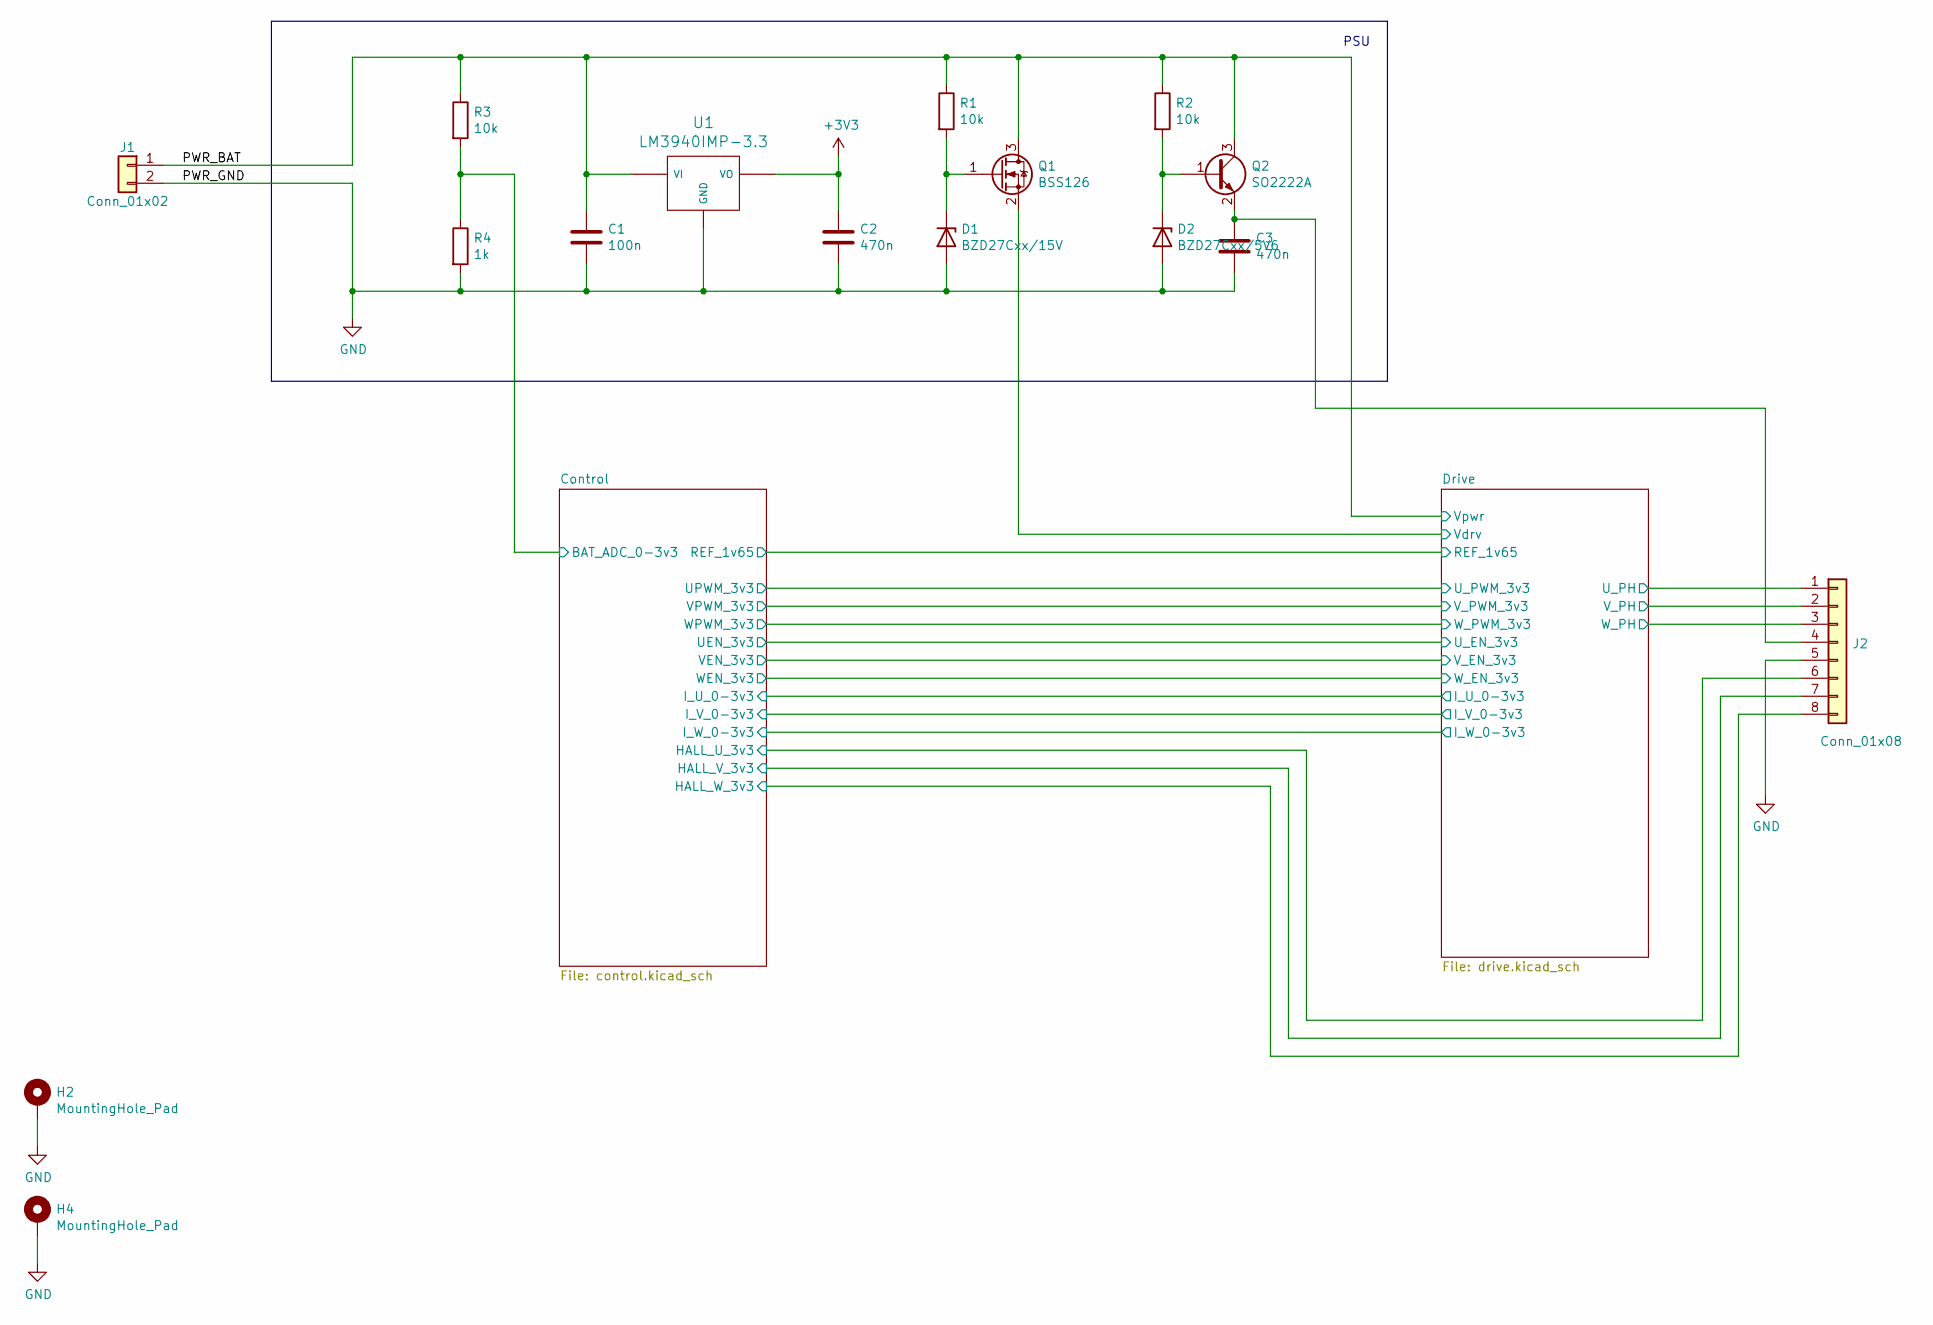
[picture p24: schematic canon_2019.kicad_sch, Canon]

Parts:
C1: 100n; C_0603
C2, C3: 470n; C_0603
D1: BZD27Cxx/15V; D_SOD-323
D2: BZD27Cxx/5V6; D_SOD-323
H2, H4: MountingHole_Pad; MountingHole_3.2mm_M3
J1: Conn_01x02; Pin_Header_Straight_1x02_Pitch2.54mm
J2: Conn_01x08; Pin_Header_Straight_1x08_Pitch2.54mm
Q1: BSS126; SOT-23
Q2: SO2222A; SOT-23
R1, R2, R3: 10k; R_0603
R4: 1k; R_0603
U1: LM3940IMP-3.3; SOT-223-3_TabPin2

Connections:
+3V3: C2.1, U1.3 (VO); also elsewhere on the board
/Control/BAT_ADC_0-3v3: R3.2, R4.1; also elsewhere on the board
/Control/HALL_U_3v3: J2.6; also elsewhere on the board
/Control/HALL_V_3v3: J2.7; also elsewhere on the board
/Control/HALL_W_3v3: J2.8; also elsewhere on the board
/Drive/U_PH: J2.1; also elsewhere on the board
/Drive/V_PH: J2.2; also elsewhere on the board
/Drive/Vdrv: Q1.2 (S); also elsewhere on the board
/Drive/W_PH: J2.3; also elsewhere on the board
/PWR_BAT: C1.1, J1.1, Q1.3 (D), Q2.3 (C), R1.1, R2.1, R3.1, U1.1 (VI); also elsewhere on the board
GND: C1.2, C2.2, C3.2, D1.2 (A), D2.2 (A), H2.1, H4.1, J1.2, J2.5, R4.2, U1.2 (GND); also elsewhere on the board
unnamed: C3.1, J2.4, Q2.2 (E)
unnamed: D1.1 (K), Q1.1 (G), R1.2
unnamed: D2.1 (K), Q2.1 (B), R2.2

Notes on the sheet:
PSU

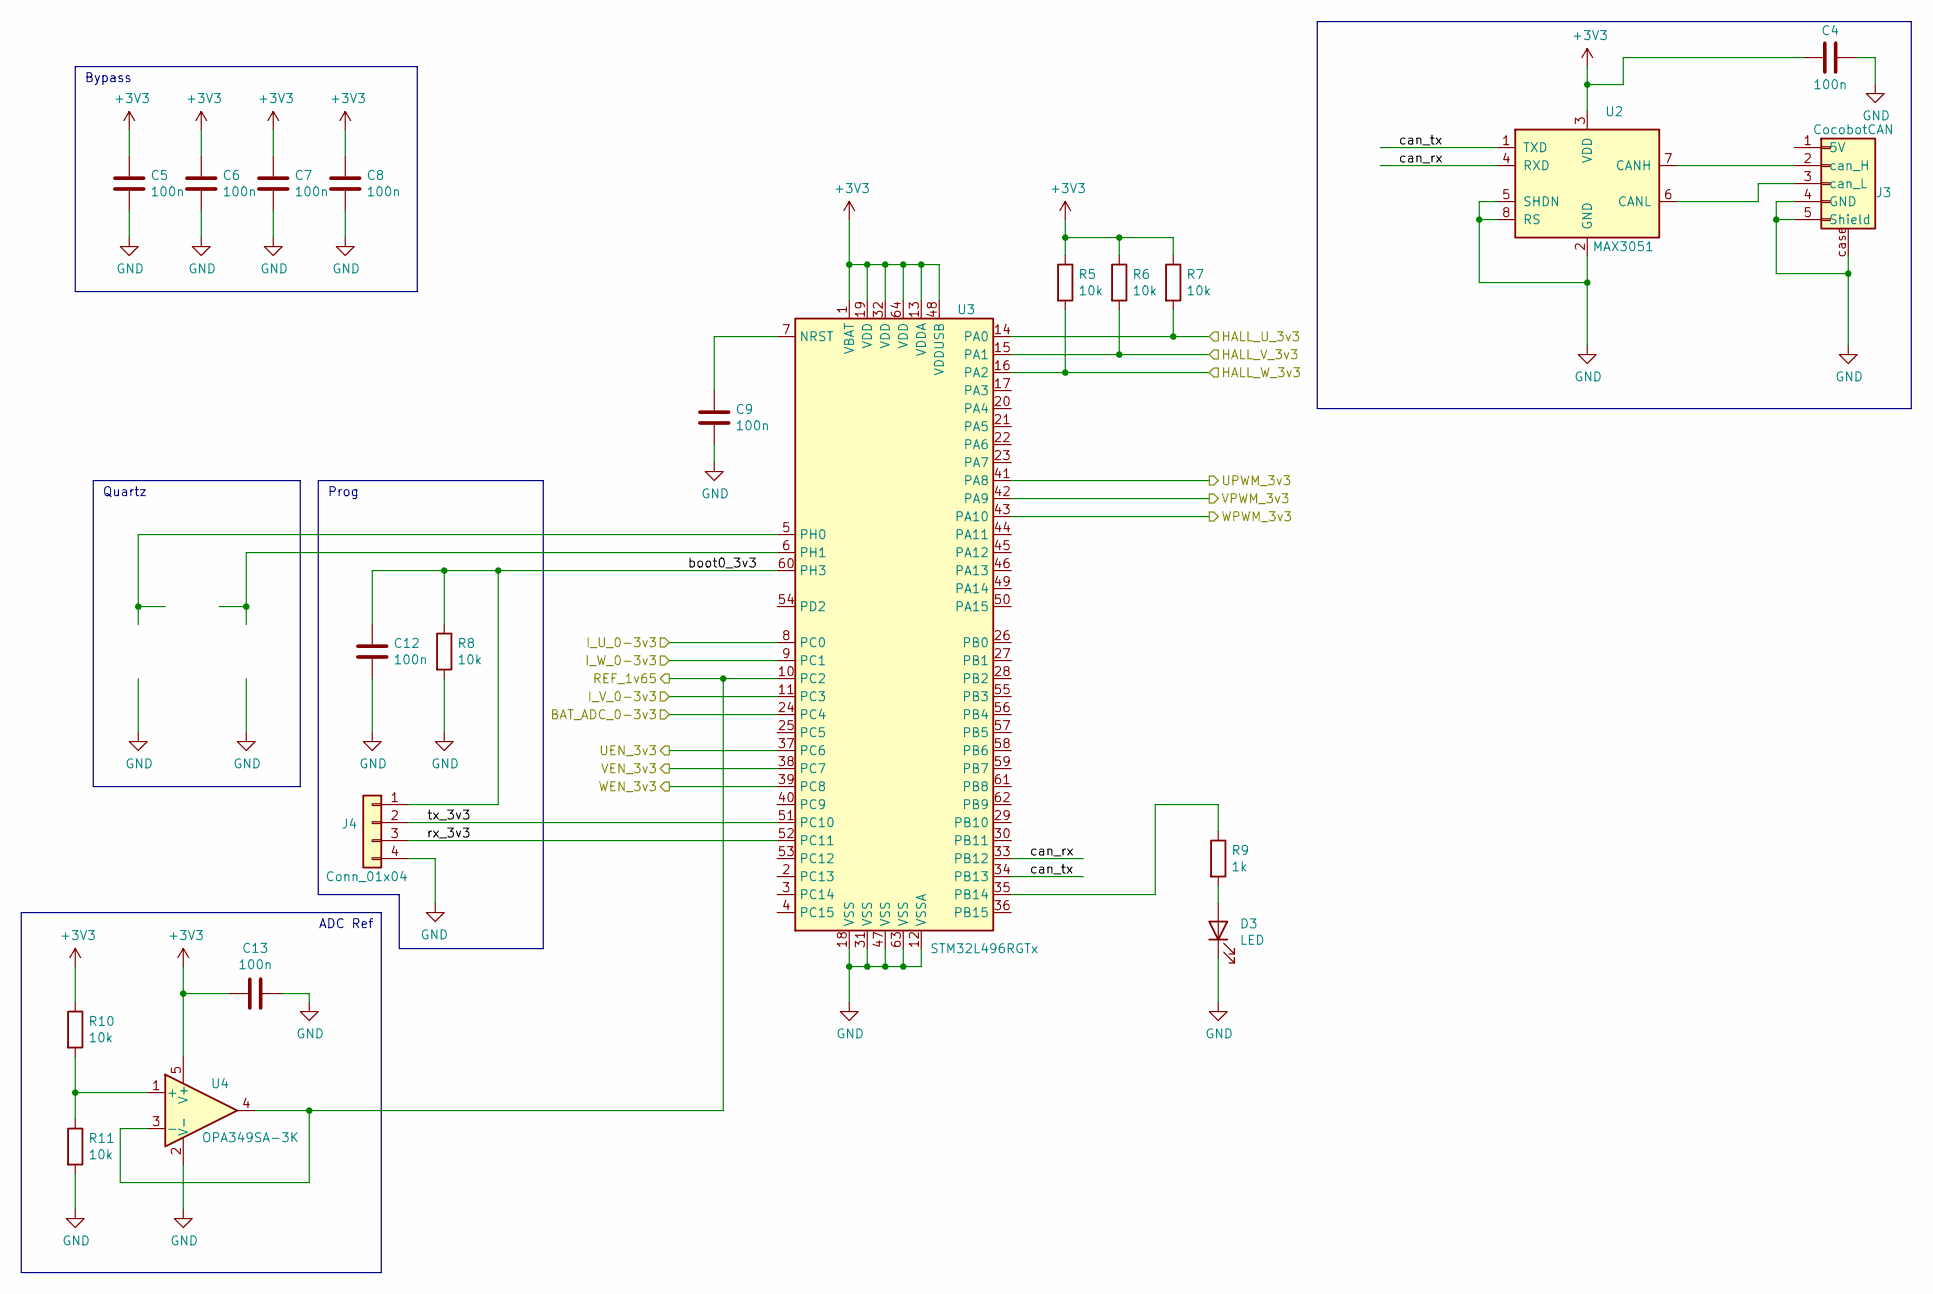
[picture p25: schematic control.kicad_sch, Canon]

Parts:
C4, C5, C6, C7, C8, C9, C12, C13: 100n; C_0603
D3: LED; LED_0805
J3: CocobotCAN; JST_PH_S5B-PH-SM4-TB_05x2.00mm_Angled
J4: Conn_01x04; Pin_Header_Straight_1x04_Pitch2.54mm
R5, R6, R7, R8, R10, R11: 10k; R_0603
R9: 1k; R_0603
U2: MAX3051; SOIC-8_3.9x4.9mm_Pitch1.27mm
U3: STM32L496RGTx; LQFP-64_10x10mm_Pitch0.5mm
U4: OPA349SA-3K; SOT-353_SC-70-5

Connections:
+3V3: C4.1, C5.1, C6.1, C7.1, C8.1, C13.2, R5.1, R6.1, R7.1, R10.1, U2.3 (VDD), U3.1 (VBAT), U3.13 (VDDA), U3.19 (VDD), U3.32 (VDD), U3.48 (VDDUSB), U3.64 (VDD), U4.5 (V+); also elsewhere on the board
/Control/BAT_ADC_0-3v3: U3.24 (PC4); also elsewhere on the board
/Control/HALL_U_3v3: R7.2, U3.14 (PA0); also elsewhere on the board
/Control/HALL_V_3v3: R6.2, U3.15 (PA1); also elsewhere on the board
/Control/HALL_W_3v3: R5.2, U3.16 (PA2); also elsewhere on the board
/Control/I_U_0-3v3: U3.8 (PC0); also elsewhere on the board
/Control/I_V_0-3v3: U3.11 (PC3); also elsewhere on the board
/Control/I_W_0-3v3: U3.9 (PC1); also elsewhere on the board
/Control/REF_1v65: U3.10 (PC2), U4.3 (-), U4.4; also elsewhere on the board
/Control/UEN_3v3: U3.37 (PC6); also elsewhere on the board
/Control/UPWM_3v3: U3.41 (PA8); also elsewhere on the board
/Control/VEN_3v3: U3.38 (PC7); also elsewhere on the board
/Control/VPWM_3v3: U3.42 (PA9); also elsewhere on the board
/Control/WEN_3v3: U3.39 (PC8); also elsewhere on the board
/Control/WPWM_3v3: U3.43 (PA10); also elsewhere on the board
/Control/boot0_3v3: C12.1, J4.1, R8.1, U3.60 (PH3)
/Control/can_rx: U2.4 (RXD), U3.33 (PB12)
/Control/can_tx: U2.1 (TXD), U3.34 (PB13)
/Control/rx_3v3: J4.3, U3.52 (PC11)
/Control/tx_3v3: J4.2, U3.51 (PC10)
GND: C4.2, C5.2, C6.2, C7.2, C8.2, C9.2, C12.2, C13.1, D3.1 (K), J3.4 (GND), J3.5 (Shield), J3.case, J4.4, R8.2, R11.2, U2.2 (GND), U2.5 (SHDN), U2.8 (RS), U3.12 (VSSA), U3.18 (VSS), U3.31 (VSS), U3.47 (VSS), U3.63 (VSS), U4.2 (V-); also elsewhere on the board
unnamed: C9.1, U3.7 (NRST)
unnamed: D3.2 (A), R9.2
unnamed: J3.2 (can_H), U2.7 (CANH)
unnamed: J3.3 (can_L), U2.6 (CANL)
unnamed: R9.1, U3.35 (PB14)
unnamed: R10.2, R11.1, U4.1 (+)

Notes on the sheet:
ADC Ref
Prog
Quartz
Bypass

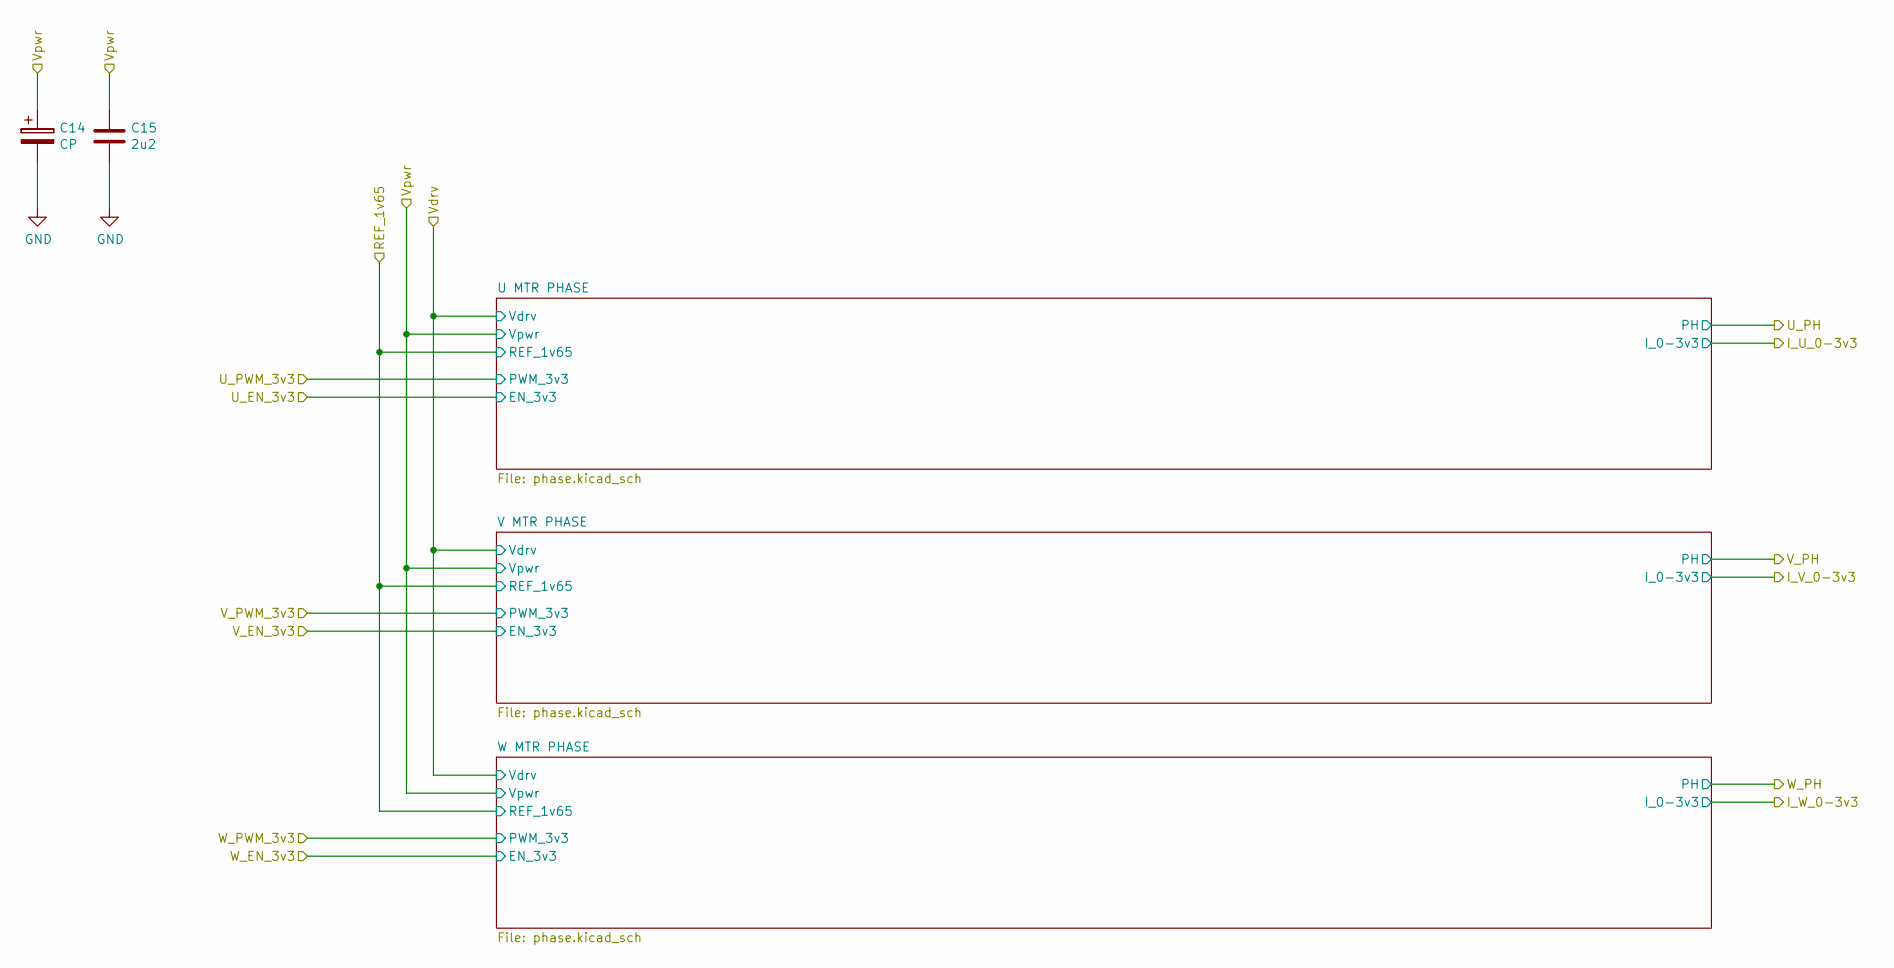
[picture p26: schematic drive.kicad_sch, Canon]

Parts:
C14: CP; c_elec_6.3x7.7
C15: 2u2; C_0603

Connections:
/PWR_BAT: C14.1, C15.1; also elsewhere on the board
GND: C14.2, C15.2; also elsewhere on the board

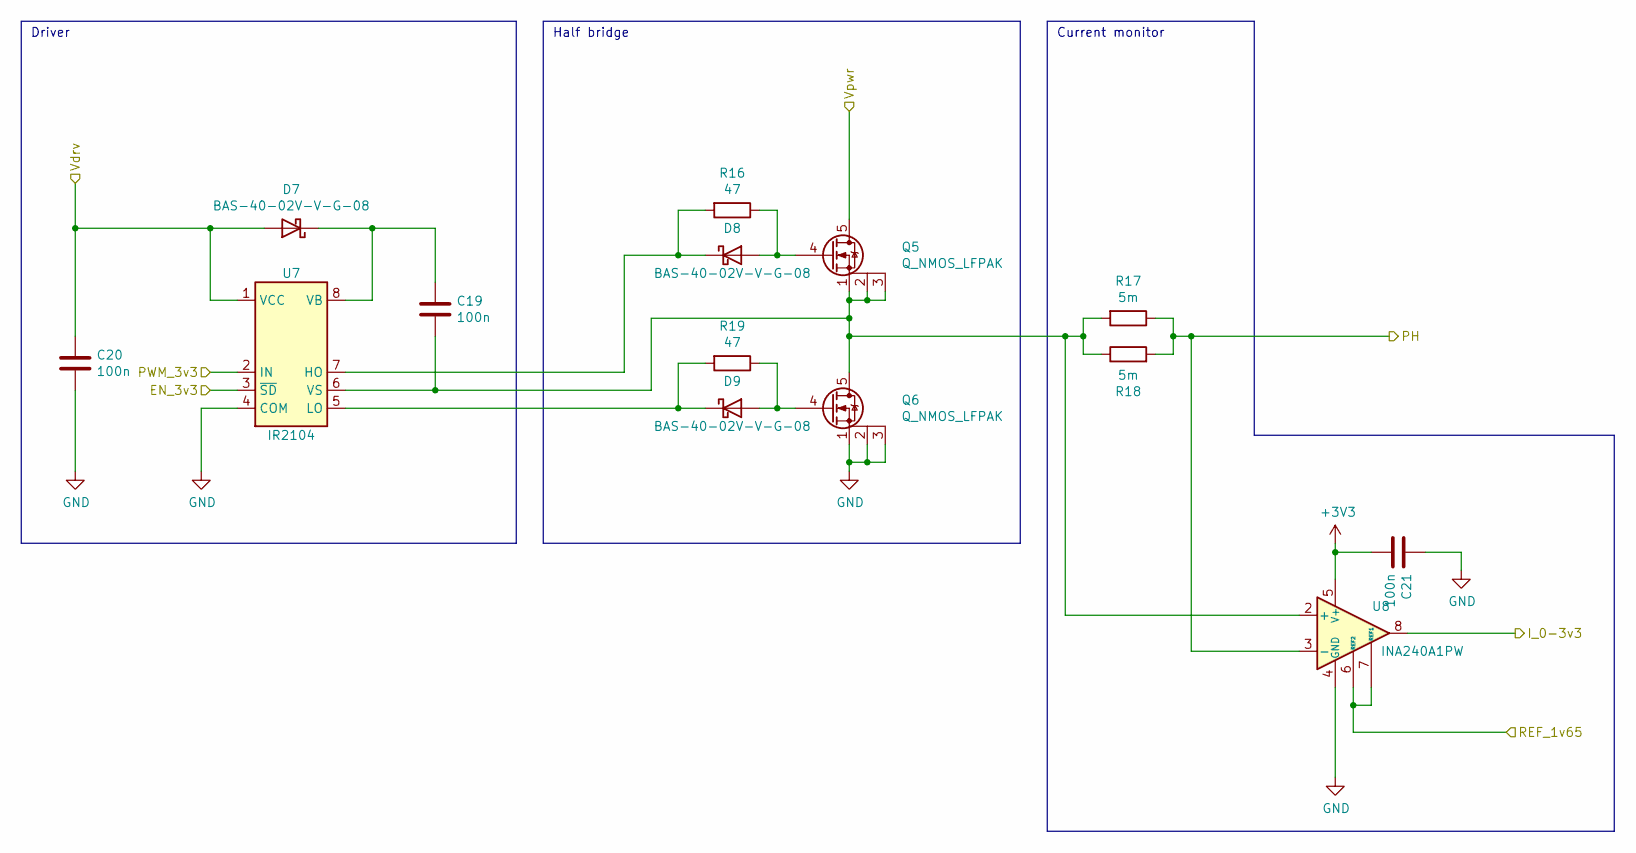
[picture p27: schematic phase.kicad_sch, Canon]

Parts:
C19, C20, C21: 100n; C_0603
D7, D8, D9: BAS-40-02V-V-G-08; D_SOD-523
Q5, Q6: Q_NMOS_LFPAK; SOT-669_LFPAK
R16, R19: 47; R_0603
R17, R18: 5m; R_1206
U7: IR2104; SOIC-8_3.9x4.9mm_Pitch1.27mm
U8: INA240A1PW; TSSOP-8_4.4x3mm_Pitch0.65mm

Connections:
+3V3: C21.2, U8.5 (V+); also elsewhere on the board
/Control/I_V_0-3v3: U8.8; also elsewhere on the board
/Control/REF_1v65: U8.6 (REF2), U8.7 (REF1); also elsewhere on the board
/Control/VEN_3v3: U7.3 (~SD); also elsewhere on the board
/Control/VPWM_3v3: U7.2 (IN); also elsewhere on the board
/Drive/V_PH: R17.1, R18.2, U8.3 (-); also elsewhere on the board
/Drive/Vdrv: C20.1, D7.2 (A), U7.1 (VCC); also elsewhere on the board
/PWR_BAT: Q5.5 (D); also elsewhere on the board
GND: C20.2, C21.1, Q6.1 (S), Q6.2 (D), Q6.3 (D), U7.4 (COM), U8.1 (GND), U8.4 (GND); also elsewhere on the board
unnamed: C19.1, D7.1 (K), U7.8 (VB)
unnamed: C19.2, Q5.1 (S), Q5.2 (D), Q5.3 (D), Q6.5 (D), R17.2, R18.1, U7.6 (VS), U8.2 (+)
unnamed: D8.1 (K), R16.2, U7.7 (HO)
unnamed: D8.2 (A), Q5.4 (G), R16.1
unnamed: D9.1 (K), R19.2, U7.5 (LO)
unnamed: D9.2 (A), Q6.4 (G), R19.1

Parts of its further copies:
C16, C17, C18, C22, C23, C24: 100n; C_0603
D4, D5, D6, D10, D11, D12: BAS-40-02V-V-G-08; D_SOD-523
Q3, Q4, Q7, Q8: Q_NMOS_LFPAK; SOT-669_LFPAK
R12, R15, R20, R23: 47; R_0603
R13, R14, R21, R22: 5m; R_1206
U5, U9: IR2104; SOIC-8_3.9x4.9mm_Pitch1.27mm
U6, U10: INA240A1PW; TSSOP-8_4.4x3mm_Pitch0.65mm

Connections of its further copies:
+3V3: C18.2, C24.2, U6.5 (V+), U10.5 (V+); also elsewhere on the board
/Control/I_U_0-3v3: U6.8; also elsewhere on the board
/Control/I_W_0-3v3: U10.8; also elsewhere on the board
/Control/REF_1v65: U6.6 (REF2), U6.7 (REF1), U10.6 (REF2), U10.7 (REF1); also elsewhere on the board
/Control/UEN_3v3: U5.3 (~SD); also elsewhere on the board
/Control/UPWM_3v3: U5.2 (IN); also elsewhere on the board
/Control/WEN_3v3: U9.3 (~SD); also elsewhere on the board
/Control/WPWM_3v3: U9.2 (IN); also elsewhere on the board
/Drive/U_PH: R13.1, R14.2, U6.3 (-); also elsewhere on the board
/Drive/Vdrv: C17.1, C23.1, D4.2 (A), D10.2 (A), U5.1 (VCC), U9.1 (VCC); also elsewhere on the board
/Drive/W_PH: R21.1, R22.2, U10.3 (-); also elsewhere on the board
/PWR_BAT: Q3.5 (D), Q7.5 (D); also elsewhere on the board
GND: C17.2, C18.1, C23.2, C24.1, Q4.1 (S), Q4.2 (D), Q4.3 (D), Q8.1 (S), Q8.2 (D), Q8.3 (D), U5.4 (COM), U6.1 (GND), U6.4 (GND), U9.4 (COM), U10.1 (GND), U10.4 (GND); also elsewhere on the board
unnamed: C16.1, D4.1 (K), U5.8 (VB)
unnamed: C16.2, Q3.1 (S), Q3.2 (D), Q3.3 (D), Q4.5 (D), R13.2, R14.1, U5.6 (VS), U6.2 (+)
unnamed: C22.1, D10.1 (K), U9.8 (VB)
unnamed: C22.2, Q7.1 (S), Q7.2 (D), Q7.3 (D), Q8.5 (D), R21.2, R22.1, U9.6 (VS), U10.2 (+)
unnamed: D5.1 (K), R12.2, U5.7 (HO)
unnamed: D5.2 (A), Q3.4 (G), R12.1
unnamed: D6.1 (K), R15.2, U5.5 (LO)
unnamed: D6.2 (A), Q4.4 (G), R15.1
unnamed: D11.1 (K), R20.2, U9.7 (HO)
unnamed: D11.2 (A), Q7.4 (G), R20.1
unnamed: D12.1 (K), R23.2, U9.5 (LO)
unnamed: D12.2 (A), Q8.4 (G), R23.1

Notes on the sheet:
Half bridge
Current monitor
Driver

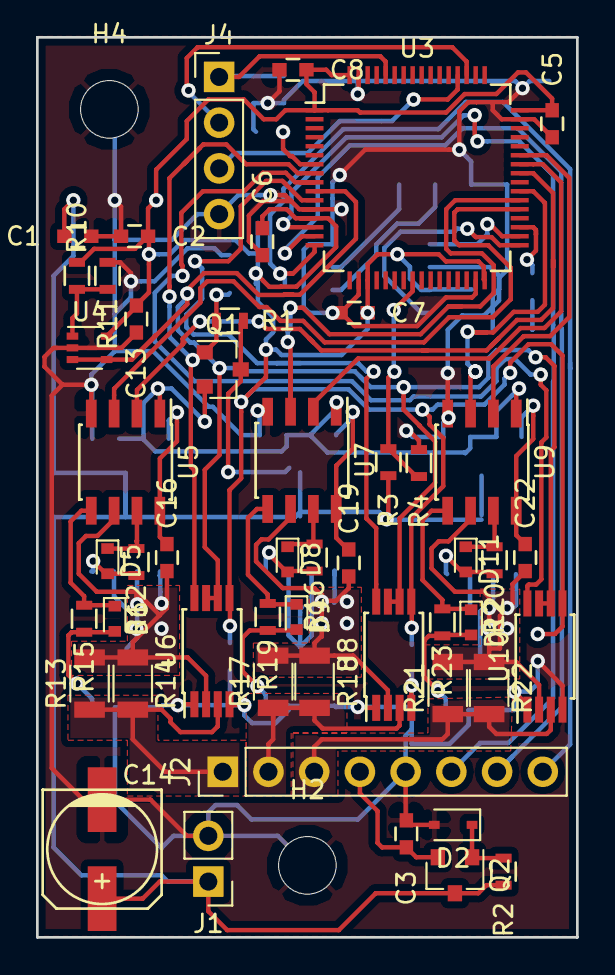
[picture p28: board canon_2019.kicad_pcb from above]

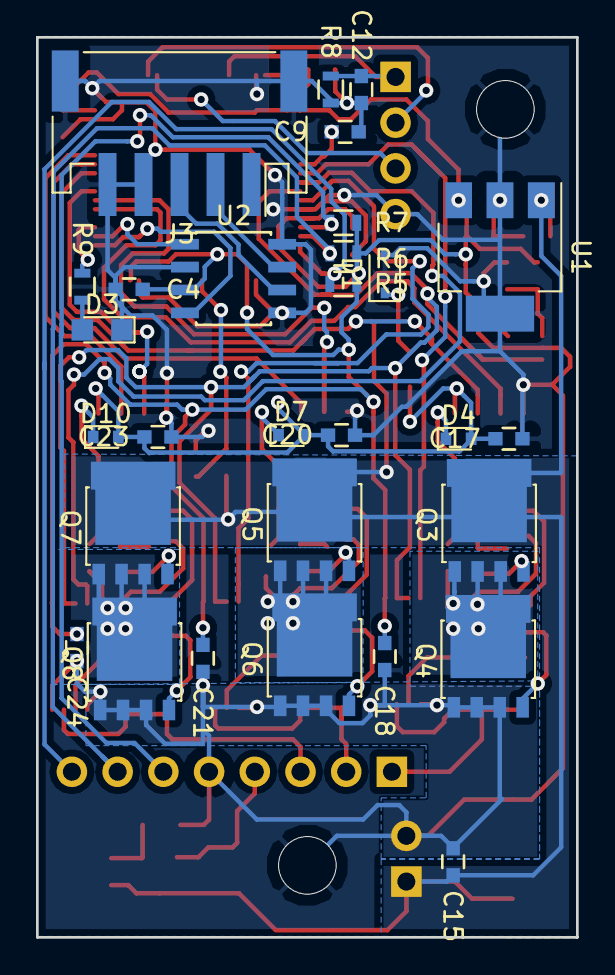
[picture p29: board canon_2019.kicad_pcb from below]

Board: 2 copper layers, 30.0 x 50.0 mm, 81 parts (29 on the bottom side), 53 nets.
