cocobot/cocotter/code/boards/pami/src/esp.rs

use std::rc::Rc;
use std::sync::Mutex;
use flume::{Receiver, Sender};
use embedded_hal_bus::i2c::MutexDevice;
use esp_idf_svc::{
    hal::{
        adc::{
            ADCU1,
            attenuation,
            oneshot::{config::AdcChannelConfig, AdcChannelDriver, AdcDriver},
        },
        gpio::{Input, Output, PinDriver, Pull},
        i2c::{I2cConfig, I2cDriver},
        ledc::{LedcDriver, LedcTimerDriver, Resolution, config::TimerConfig},
        peripherals::Peripherals,
        units::Hertz,
    },
    nvs::EspDefaultNvsPartition,
};
use ssd1306::{
    I2CDisplayInterface, Ssd1306,
    mode::BufferedGraphicsMode,
    prelude::{
        DisplayConfig,
        DisplayRotation,
        DisplaySize128x64,
        I2CInterface as DisplayI2CInterface,
    },
};

use board_common::esp::EspEncoder;
use ble::BleBuilder;
use tca6408::TCA6408;
use vlx::{DistanceData, VlxI2cDriver, VlxError, VlxSensor, ZoneAlarm, l5::VL53L5CX};
use crate::{BatteryLevel, BatteryReader, DpadState, PamiBoard, PamiButtons, PamiButtonsState, PamiLeds, PamiMotor, PamiMotors, PamiPwmController};


pub type I2cType = MutexDevice<'static, I2cDriver<'static>>;
pub type PamiDisplay = Ssd1306<DisplayI2CInterface<I2cType>, DisplaySize128x64, BufferedGraphicsMode<DisplaySize128x64>>;


pub struct EspPamiBoard {
    battery_reader: Option<PamiBatteryReader>,
    emergency_stop: Option<PinDriver<'static, Input>>,
    starting_cord: Option<PinDriver<'static, Input>>,
    buttons: Option<EspPamiButtons>,
    display: Option<PamiDisplay>,
    leds: Option<PamiLeds<PinDriver<'static, Output>>>,
    line_sensor: Option<TCA6408<I2cType>>,
    vlx_sensor: Option<PamiVlxSensor>,
    motors: Option<PamiMotors<EspEncoder<'static>, LedcDriver<'static>>>,
    pwm_controller: Option<PamiPwmController<I2cType>>,
}

impl PamiBoard for EspPamiBoard {
    type BatteryReader = PamiBatteryReader;
    type I2c = I2cType;
    type Led = PinDriver<'static, Output>;
    type Display = PamiDisplay;
    type Buttons = EspPamiButtons;
    type Vlx = PamiVlxSensor;
    type MotorEncoder = EspEncoder<'static>;
    type MotorPwm = LedcDriver<'static>;

    fn init() -> Self {
        esp_idf_svc::sys::link_patches();

        let logger = esp_idf_svc::log::init_from_esp_idf();
        logger.filter().set_target_level("NimBLE", log::LevelFilter::Warn).unwrap();

        let _nvs = EspDefaultNvsPartition::take().unwrap();

        let peripherals = Peripherals::take().unwrap();

        // Initialize digital output pins
        let leds = PamiLeds {
            esp: PinDriver::output(peripherals.pins.gpio4).unwrap(),
            com: PinDriver::output(peripherals.pins.gpio5).unwrap(),
        };

        // Initialize the I2C bus
        let config = I2cConfig::new().baudrate(Hertz(100_000));
        let i2c_driver = Mutex::new(I2cDriver::new(peripherals.i2c0, peripherals.pins.gpio18, peripherals.pins.gpio17, &config).unwrap());
        // Leak `i2c_driver` to get a static lifetime
        // The I2cDriver never be dropped the end of the program, but it's fine
        let i2c_driver_static = Box::leak(Box::new(i2c_driver));

        // VLX sensor
        let vlx_i2c_driver = VlxI2cDriver::register(MutexDevice::new(i2c_driver_static));
        let vlx_sensor = PamiVlxSensor {
            sensor: VL53L5CX::new(&vlx_i2c_driver, 0x31, vlx::l5::Orientation::TopRight),
            enable: PinDriver::output(peripherals.pins.gpio3).unwrap(),
        };

        // ADC
        let adc = Rc::new(AdcDriver::new(peripherals.adc1).unwrap());
        let adc_vbatt = AdcChannelDriver::new(
            adc,
            peripherals.pins.gpio1,
            &AdcChannelConfig { attenuation: attenuation::DB_12, ..Default::default() },
        ).unwrap();
        let battery_reader = PamiBatteryReader(adc_vbatt);

        let _modem = peripherals.modem; // consumed to prevent reuse (Nimble will use it outside rust code)

        let line_sensor = TCA6408::new(MutexDevice::new(i2c_driver_static), 0b010_0000);
        let buttons = EspPamiButtons {
            tca: TCA6408::new(MutexDevice::new(i2c_driver_static), 0b010_0001),
            pin: PinDriver::input(peripherals.pins.gpio7, Pull::Floating).unwrap(),
        };

        // Screen
        let display = {
            let interface = I2CDisplayInterface::new(MutexDevice::new(i2c_driver_static));
            let mut display  = Ssd1306::new(interface, DisplaySize128x64, DisplayRotation::Rotate0)
                .into_buffered_graphics_mode();
            display.init().unwrap();
            display
        };

        // Motors
        let motor_pwm = LedcTimerDriver::new(
            peripherals.ledc.timer0,
            &TimerConfig::new().frequency(Hertz(25_000)).resolution(Resolution::Bits10),
        ).unwrap();
        let motors = PamiMotors {
            left: PamiMotor {
                encoder: EspEncoder::new(peripherals.pins.gpio39,  peripherals.pins.gpio40).unwrap(),
                pwm_forward: LedcDriver::new(peripherals.ledc.channel0, &motor_pwm, peripherals.pins.gpio21).unwrap(),
                pwm_backward: LedcDriver::new(peripherals.ledc.channel1, &motor_pwm, peripherals.pins.gpio14).unwrap(),
            },
            right: PamiMotor {
                encoder: EspEncoder::new(peripherals.pins.gpio41, peripherals.pins.gpio42).unwrap(),
                pwm_forward: LedcDriver::new(peripherals.ledc.channel2, &motor_pwm, peripherals.pins.gpio12).unwrap(),
                pwm_backward: LedcDriver::new(peripherals.ledc.channel3, &motor_pwm, peripherals.pins.gpio13).unwrap(),
            },
        };

        let pwm_controller = PamiPwmController::new(MutexDevice::new(i2c_driver_static), 0b110_1001).unwrap();

        let emergency_stop = PinDriver::input(peripherals.pins.gpio15, Pull::Up).unwrap();
        let starting_cord = PinDriver::input(peripherals.pins.gpio2, Pull::Up).unwrap();

        Self {
            battery_reader: Some(battery_reader),
            emergency_stop: Some(emergency_stop),
            starting_cord: Some(starting_cord),
            leds: Some(leds),
            line_sensor: Some(line_sensor),
            buttons: Some(buttons),
            display: Some(display),
            vlx_sensor: Some(vlx_sensor),
            motors: Some(motors),
            pwm_controller: Some(pwm_controller),
        }
    }

    fn restart() {
        esp_idf_svc::hal::reset::restart();
    }

    fn bt_mac_address(&self) -> [u8; 6] {
        let mut mac = [0; 6];
        let mac_type = esp_idf_svc::sys::esp_mac_type_t_ESP_MAC_BT;
        // SAFETY: MAC address is 6-byte long
        unsafe { esp_idf_svc::sys::esp_read_mac(mac.as_mut_ptr() as *mut _, mac_type) };
        mac
    }

    fn battery_reader(&mut self) -> Option<Self::BatteryReader> {
        self.battery_reader.take()
    }

    fn emergency_stop(&mut self) -> Option<Box<dyn FnMut() -> bool>> {
        let pin = self.emergency_stop.take()?;
        let f = move || { pin.is_low() };
        Some(Box::new(f))
    }

    fn starting_cord(&mut self) -> Option<Box<dyn FnMut() -> bool>> {
        let pin = self.starting_cord.take()?;
        let f = move || { pin.is_low() };
        Some(Box::new(f))
    }

    fn leds(&mut self) -> Option<PamiLeds<Self::Led>> {
        self.leds.take()
    }

    fn line_sensor(&mut self) -> Option<TCA6408<Self::I2c>> {
        self.line_sensor.take()
    }

    fn buttons(&mut self) -> Option<Self::Buttons> {
        self.buttons.take()
    }

    fn display(&mut self) -> Option<Self::Display> {
        self.display.take()
    }

    fn vlx_sensor(&mut self) -> Option<Self::Vlx> {
        self.vlx_sensor.take()
    }

    fn motors(&mut self) -> Option<PamiMotors<Self::MotorEncoder, Self::MotorPwm>> {
        self.motors.take()
    }

    fn pwm_controller(&mut self) -> Option<PamiPwmController<Self::I2c>> {
        self.pwm_controller.take()
    }

    fn rome<F: Fn([u8; 6], u32) + Send + Sync +'static>(&mut self, device_name: String, passkey_notifier: F) -> Option<(Sender<Box<[u8]>>, Sender<String>, Receiver<Box<[u8]>>)> {
        let (ble_server, _ble_client) = BleBuilder::new()
            .with_passkey_notifier(passkey_notifier)
            .run();

        let rome_reg = ble::rome::register_gatt();
        ble_server.start_host();
        let rome = rome_reg.start();

        ble_server.setup_advertising(&device_name, &ble::rome::SERVICE_UUID_BYTES).unwrap();
        ble_server.start_advertising().unwrap();

        Some((rome.tm_sender, rome.logs_sender, rome.orders_receiver))
    }
}


type AdcCh0 = esp_idf_svc::hal::adc::ADCCH0<ADCU1>;
pub struct PamiBatteryReader(AdcChannelDriver<'static, AdcCh0, Rc<AdcDriver<'static, ADCU1>>>);

impl PamiBatteryReader {
    const fn raw_to_mv(raw: f32) -> f32 {
        const VBATT_RL_KOHMS: f32 = 91.0;
        const VBATT_RH_KOHMS: f32 = 91.0;
        const ADC_INPUT_IMP_KOHMS: f32 = 500.0;
        const RL_KOHMS: f32 = VBATT_RL_KOHMS * ADC_INPUT_IMP_KOHMS / (VBATT_RL_KOHMS + ADC_INPUT_IMP_KOHMS);
        raw * (1.0 + VBATT_RH_KOHMS/RL_KOHMS)
    }

    fn mv_to_percent(measure_mv: f32) -> u8 {
        // LiFePO4 voltage to percentage lookup table (voltage in mV, percentage points)
        const LIFEPO4_CURVE: [(f32, f32); 11] = [
            (3400.0, 100.0),
            (3350.0, 90.0),
            (3320.0, 80.0),
            (3300.0, 70.0),
            (3270.0, 60.0),
            (3260.0, 50.0),
            (3250.0, 40.0),
            (3220.0, 35.0),
            (3200.0, 20.0),
            (3000.0, 10.0),
            (2500.0, 0.0),
        ];

        match LIFEPO4_CURVE.iter().position(|(mv, _)| measure_mv >= *mv) {
            None => 0,
            Some(0) => 100,
            Some(i) => {
                let (mv0, pct0) = LIFEPO4_CURVE[i];
                let (mv1, pct1) = LIFEPO4_CURVE[i - 1];
                let pct = pct0 + (pct1 - pct0) * (measure_mv - mv0) / (mv1 - mv0);
                pct as u8
            }
        }
    }
}

impl BatteryReader for PamiBatteryReader {
    fn read_vbatt(&mut self) -> BatteryLevel {
        let raw = self.0.read().unwrap() as f32;
        let mv = Self::raw_to_mv(raw);
        let percent = Self::mv_to_percent(mv);
        BatteryLevel { mv: mv as u16, percent }
    }
}


pub struct PamiVlxSensor {
    sensor: VL53L5CX,
    enable: PinDriver<'static, Output>,
}

impl VlxSensor for PamiVlxSensor {
    fn init(&mut self) -> Result<(), VlxError> {
        // Disable then enable VLX
        self.enable.set_low().unwrap();
        std::thread::sleep(std::time::Duration::from_millis(10));
        self.enable.set_high().unwrap();
        std::thread::sleep(std::time::Duration::from_millis(100));
        // Initialize sensor
        self.sensor.init()
    }

    fn get_distance(&mut self) -> Result<DistanceData, VlxError> {
        self.sensor.get_distance()
    }

    fn set_alarms(&mut self, alarms: &[ZoneAlarm]) -> Result<(), VlxError> {
        self.sensor.set_alarms(alarms)
    }
}


pub struct EspPamiButtons {
    tca: TCA6408<I2cType>,
    pin: PinDriver<'static, Input>,
}

impl PamiButtons for EspPamiButtons {
    fn read_state(&mut self) -> PamiButtonsState {
        let value = self.tca.read_inputs().unwrap_or(0);
        let dpad = match value & 0b11111 {
            0b00001 => DpadState::Right,
            0b00010 => DpadState::Down,
            0b00100 => DpadState::Up,
            0b01000 => DpadState::Middle,
            0b10000 => DpadState::Left,
            _ => DpadState::None,
        };
        let switches = value.reverse_bits() | if self.pin.is_high() { 0b1000 } else { 0 };
        PamiButtonsState { dpad, switches }
    }
}
