cocobot/cocotter/code/pami/src/routines.rs

use std::sync::{Arc, Mutex};
use std::time::{Duration, Instant};
use asserv::differential::{conf::*, Asserv, rome::AsservDiffRome};
use asserv::rome::AsservRome;
use board_common::{Color, Periodicity};
use board_pami::{BatteryLevel, BatteryReader, PamiBoard, PamiButtons, PamiLeds, PamiPwmController};
use embedded_hal::digital::StatefulOutputPin;
use flume::{Receiver, Sender};
use vlx::VlxSensor;
use crate::pami_asserv::{ASSERV_PERIOD, PamiAsservHardware};
use crate::events::*;


/// Everything needed for PAMI routines
///
/// Update state from multiple peripherals.
/// States are updated when calling `idle()` or `step_idle()`.
pub struct PamiRoutines<B: PamiBoard> {
    pub asserv: Asserv<PamiAsservHardware<B>>,

    // Current state of various updated values
    pub emergency_stop: bool,
    pub battery_level: BatteryLevel,
    // Instants for when PAMI can starts moving, and match end; unset if match has not started yet
    match_instants: Option<(Instant, Instant)>,

    // Peripherals
    pub pami_leds: PamiLeds<B::Led>,
    pub pami_buttons: B::Buttons,
    pub battery_reader: B::BatteryReader,
    pub pwm_controller: PamiPwmController<B::I2c>,
    pub vlx_data: Arc<Mutex<Option<vlx::DistanceData>>>,
    starting_cord_read: Box<dyn FnMut() -> bool>,

    // ROME sender/receiver
    pub rome_tx: Sender<Box<[u8]>>,
    pub rome_rx: Receiver<Box<[u8]>>,
    pub rlogger: Sender<String>,
    // UI sender/receiver
    pub ui_events: Sender<UiEvent>,
    pub ui_triggers: Receiver<UiTrigger>,

    // Periodicity states
    asserv_periodicity: Periodicity,
    asserv_tm_periodicity: Periodicity,
    battery_level_periodicity: Periodicity,
    vlx_tm_periodicity: Option<Periodicity>,
}


/// Duration during which a paninja PAMI can move
const PANINJA_ACTIVE_DURATION: Duration = Duration::from_secs(10);
/// Total match duration
const MATCH_DURATION: Duration = Duration::from_secs(100);

pub enum MatchStep {
    /// Waiting for match to start
    WaitingMatchStart,
    /// Waiting PAMI start time (90s except for ninja), value is duration until next step
    WaitingPamiStart(Duration),
    /// PAMI can move, value is duration until end of match
    PamiActive(Duration),
    /// Match ended
    MatchEnded,
}


impl<B: PamiBoard> PamiRoutines<B> {
    const EMERGENCY_STOP_COLOR: Color = Color::RED;

    /// Initialize with default state values and peripherals from board
    ///
    /// Peripherals must be available on the board.
    /// The asserv must be configured manually, using `asserv.set_conf()`.
    pub fn new(
        board: &mut B,
        (rome_tx, rlogger, rome_rx): (Sender<Box<[u8]>>, Sender<String>, Receiver<Box<[u8]>>),
        (ui_events, ui_triggers): (Sender<UiEvent>, Receiver<UiTrigger>),
    ) -> Self {
        rome::info!(rlogger, "Initializing PAMI routines");

        // Start VLX thread
        let vlx_data: Arc<Mutex<Option<vlx::DistanceData>>> = Default::default();
        let vlx_data_clone = vlx_data.clone();
        let mut vlx = board.vlx_sensor().unwrap();
        std::thread::Builder::new()
            .name("VLX".to_string())
            .stack_size(8192)
            .spawn(move || {
                log::info!("Initialize VLX");
                if let Err(err) = vlx.init() {
                    log::error!("VLX initalization failed, abort VLX thread: {err:?}");
                    return;
                }

                loop {
                    match vlx.get_distance() {
                        Ok(distance) => *vlx_data_clone.lock().unwrap() = Some(distance),
                        Err(err) => log::error!("Failed to get VLX sensor distance: {err:?}"),
                    }

                    std::thread::sleep(Duration::from_millis(1000));
                }
            })
            .expect("Failed to spawn VLX thread");

        let mut pwm_controller = board.pwm_controller().unwrap();
        pwm_controller.init().unwrap();

        Self {
            asserv: Asserv::new(PamiAsservHardware::new(board), ASSERV_PERIOD),
            emergency_stop: false,
            battery_level: Default::default(),
            match_instants: None,

            pami_leds: board.leds().unwrap(),
            pami_buttons: board.buttons().unwrap(),
            battery_reader: board.battery_reader().unwrap(),
            pwm_controller,
            vlx_data,
            starting_cord_read: board.starting_cord().unwrap(),

            rome_tx,
            rome_rx,
            rlogger,
            ui_events,
            ui_triggers,

            asserv_periodicity: Periodicity::new(ASSERV_PERIOD),
            asserv_tm_periodicity: Periodicity::new(Duration::from_millis(100)),
            battery_level_periodicity: Periodicity::new(Duration::from_millis(2000)),
            vlx_tm_periodicity: None,
        }
    }

    /// Intialize states and peripherals
    pub fn init(&mut self) {
        self.pwm_controller.set_battery_rgb(&Color::new(0.0, 0.0, 0.02));
        self.pwm_controller.set_ground_rgb(&Color::new(0.02, 0.02, 0.02));
    }

    /// Run the match setup procedure
    pub fn match_setup(&mut self) -> MatchConf {
        let mut ground_led_color = BlinkingColor::new(Duration::from_millis(1000));

        log::info!("Unplug starting cord...");
        self.ui_events.send(UiEvent::ShowMessage("UNPLUG\nCORD")).unwrap();

        ground_led_color.set_colors(Color::MAGENTA, Color::BLACK);
        while (self.starting_cord_read)() {
            let now = self.step_idle();
            if let Some(color) = ground_led_color.update(&now) {
                self.set_ground_led_color(color);
            }
        }

        // Initialize match conf from buttons state
        let mut buttons = self.pami_buttons.read_state();
        let mut match_conf = MatchConf {
            team: match buttons.switch(0) {
                false => Team::Left,
                true => Team::Right,
            },
            start_delay: 90,
            role: match (buttons.switch(1), buttons.switch(2), buttons.switch(3)) {
                (false, false, false) => PamiRole::None,
                (true,  false, false) => PamiRole::Paninja(1),
                (false,  true, false) => PamiRole::Paninja(2),
                (true,   true, false) => PamiRole::Paninja(3),
                (false, false,  true) => PamiRole::Paninja(4),
                (true,  false,  true) => PamiRole::Paninja(5),
                (false,  true,  true) => PamiRole::Paninja(6),
                (true,   true,  true) => PamiRole::Ninja,
            },
        };

        const fn role_color(role: PamiRole) -> Color {
            match role {
                PamiRole::None => Color::BLACK,
                PamiRole::Ninja => Color::GREEN,
                PamiRole::Paninja(_) => Color::MAGENTA,
            }
        }

        log::info!("Configure PAMI for match");
        self.ui_events.send(UiEvent::ShowMatchConf(match_conf.clone())).unwrap();

        let mut buttons_periodicity = Periodicity::new(Duration::from_millis(200));
        //TODO Use the other color for role
        ground_led_color.set_colors(role_color(match_conf.role), match_conf.team.color());

        while !(self.starting_cord_read)() {
            let now = self.step_idle();
            if let Some(color) = ground_led_color.update(&now) {
                self.set_ground_led_color(color);
            }

            // Dpad update
            if buttons_periodicity.update(&now) {
                // Don't handle switch changes after init, only dpad for UI
                let new_buttons = self.pami_buttons.read_state();
                if new_buttons.dpad != buttons.dpad {
                    buttons = new_buttons;
                    self.ui_events.send(UiEvent::Dpad(new_buttons.dpad)).unwrap();
                }
            }

            // UI events
            while let Ok(trigger) = self.ui_triggers.try_recv() {
                match trigger {
                    UiTrigger::ChangeTeam(value) => {
                        match_conf.team = value;
                        self.ui_events.send(UiEvent::ChangeTeam(value)).unwrap();
                        ground_led_color.set_colors(role_color(match_conf.role), match_conf.team.color());
                    }
                    UiTrigger::ChangeStartDelay(value) => {
                        match_conf.start_delay = value;
                        self.ui_events.send(UiEvent::ChangeStartDelay(value)).unwrap();
                    }
                    UiTrigger::ChangeRole(value) => {
                        match_conf.role = value;
                        self.ui_events.send(UiEvent::ChangeRole(value)).unwrap();
                        ground_led_color.set_colors(role_color(match_conf.role), match_conf.team.color());
                    }
                }
            }
        }

        log::info!("configured: team={} delay={} role={:?}", match_conf.team.name(), match_conf.start_delay, match_conf.role);
        match_conf
    }

    /// Wait for match start
    pub fn wait_match_start(&mut self, match_conf: &MatchConf) {
        let mut ground_led_color = BlinkingColor::new(Duration::from_millis(1000));

        log::info!("Waiting match start...");
        self.ui_events.send(UiEvent::ShowMessage("WAITING\nSTART")).unwrap();

        ground_led_color.set_colors(Color::MAGENTA, match_conf.team.color());
        while (self.starting_cord_read)() {
            let now = self.step_idle();
            if let Some(color) = ground_led_color.update(&now) {
                self.set_ground_led_color(color);
            }
        }

        log::info!("Match starts!");
        let now = Instant::now();
        if match_conf.role == PamiRole::Ninja {
            let active_time = now + Duration::from_secs(match_conf.start_delay as u64);
            let match_end = active_time + PANINJA_ACTIVE_DURATION;
            self.match_instants = Some((active_time, match_end));
        } else {
            self.match_instants = Some((now, now + MATCH_DURATION));
        }
        self.set_ground_led_color(&Color::BLACK);
    }


    /// Execute one round of idle updates
    ///
    /// This method must be called regularly.
    pub fn idle(&mut self, now: &Instant) {
        let _ = self.pami_leds.esp.toggle();

        // Emergency stop: check whenever possible
        let new_emergency_stop = self.asserv.hardware_mut().emergency_stop_active();
        if new_emergency_stop != self.emergency_stop {
            log::info!("Emergency stop changed: {new_emergency_stop}");
            self.ui_events.send(UiEvent::EmergencyStop(new_emergency_stop)).unwrap();
            self.pwm_controller.set_ground_rgb(&Self::EMERGENCY_STOP_COLOR);
            self.emergency_stop = new_emergency_stop;
        }

        // Process ROME input messages
        for data in self.rome_rx.try_iter() {
            let _ = self.pami_leds.com.toggle();
            match rome::Message::decode(&data) {
                Err(err) => log::error!("ROME RX error: {err:?}"),
                Ok(message) => {
                    // Don't put message handling in a `on_message()` method to avoid borrowing issue.
                    // The borrow checker cannot guess that our `on_message()` won't modify `rome_rx`.
                    let handled = match message {
                        rome::Message::VlxSetTmPeriod(period_ms) => {
                            log::info!("Set VLX telemetry period: {}", period_ms);
                            self.vlx_tm_periodicity = Some(Periodicity::new(Duration::from_millis(period_ms as u64)));
                            true
                        }
                        _ => !self.asserv.on_rome_message(&message),
                    };
                    if !handled {
                        log::warn!("ROME: ignored message: {}", message.message_id());
                    }
                },
            }
        }

        // Update asserv, send asserv telemetry
        if self.asserv_periodicity.update(now) {
            self.asserv.update(self.asserv_periodicity.period());
        }
        if self.asserv_tm_periodicity.update(now) {
            if let Err(err) = self.rome_tx.send(self.asserv.asserv_tm_status().encode()) {
                log::error!("ROME send error: {:?}", err);
            }
            if let Err(err) = self.rome_tx.send(self.asserv.asserv_diff_tm_status().encode()) {
                log::error!("ROME send error: {:?}", err);
            }
        }

        // Battery level, send update to ROME and UI
        if self.battery_level_periodicity.update(now) {
            let level = self.battery_reader.read_vbatt();

            let message = rome::Message::BatteryLevel { mv: level.mv, percent: level.percent };
            if let Err(err) = self.rome_tx.send(message.encode()) {
                log::error!("BLE send error: {:?}", err);
            }

            if level.percent != self.battery_level.percent {
                log::info!("Battery: {} mV, {}%", level.mv, level.percent);
                self.ui_events.send(UiEvent::Battery { percent: level.percent }).unwrap();
                self.pwm_controller.set_battery_rgb(&Self::battery_led_color(level.percent));
            }

            self.battery_level = level;
        }

        // VLX telemetry, if enabled
        if let Some(periodicity) = &mut self.vlx_tm_periodicity {
            if periodicity.update(now) {
                let mut distances = [u16::MAX; 16];
                if let Some(sensor_data) = self.vlx_data.lock().unwrap().as_ref() {
                    // Copy, `vlx_distances` into `distances`, truncate to the shortest
                    for (src, dst) in sensor_data.all_distances().iter().zip(distances.iter_mut()) {
                        *dst = *src;
                    }
                }
                let message = rome::Message::VlxTmDistances { sensor: 0, distances };
                if let Err(err) = self.rome_tx.send(message.encode()) {
                    log::error!("BLE send error: {:?}", err);
                }
            }
        }
    }

    /// Wait for the next asserv step, the run `idle()` and return the associated instant
    pub fn step_idle(&mut self) -> Instant {
        let mut now = Instant::now();
        let next_instant = self.asserv_periodicity.next();
        if let Some(duration) = next_instant.checked_duration_since(now) {
            std::thread::sleep(duration);
            now = *next_instant;
        }
        self.idle(&now);
        now
    }

    /// Return current match step
    pub fn match_step(&self, now: Instant) -> MatchStep {
        if let Some((active, end)) = self.match_instants {
            if now >= end {
                MatchStep::MatchEnded
            } else if now >= active {
                MatchStep::PamiActive(end.saturating_duration_since(now))
            } else {
                MatchStep::WaitingPamiStart(active.saturating_duration_since(now))
            }
        } else {
            MatchStep::WaitingMatchStart
        }
    }

    /// Update ground led color, override with red if emergency stop is active
    fn set_ground_led_color(&mut self, color: &Color) {
        if self.emergency_stop {
            self.pwm_controller.set_ground_rgb(&Self::EMERGENCY_STOP_COLOR);
        } else {
            self.pwm_controller.set_ground_rgb(color);
        }
    }

    /// Return battery led color to use
    const fn battery_led_color(percent: u8) -> Color {
        if percent < 10 {
            Color::new(1.0, 0.0, 0.0)
        } else if percent < 30 {
            Color::new(0.5, 0.2, 0.0)
        } else {
            Color::BLACK
        }
    }
}


struct BlinkingColor {
    periodicity: Periodicity,
    colors: [Color; 2],
    state: bool,
}

impl BlinkingColor {
    pub fn new(period: Duration) -> Self {
        Self {
            periodicity: Periodicity::new(period),
            colors: [Color::BLACK, Color::BLACK],
            state: false
        }
    }

    pub fn set_colors(&mut self, color1: Color, color2: Color) {
        self.colors = [color1, color2];
    }

    pub fn update(&mut self, now: &Instant) -> Option<&Color> {
        if self.periodicity.update(now) {
            self.state = !self.state;
            Some(&self.colors[if self.state { 0 } else { 1}])
        } else {
            None
        }
    }
}
