cocobot/cocotter/(commit log)

2023-06-24 Ajout des librairies de composants Ajout du projet PMI 2023
    [pmi_2023.kicad_pcb, pmi_2023.kicad_sch, pmi_tof_sensor.kicad_pcb, pmi_tof_sensor.kicad_sch]
2023-07-10 pmi_2023 schematics
    [actuators.kicad_sch, com.kicad_sch, pmi_2023.kicad_sch, power_supply.kicad_sch, propulsion.kicad_sch, sensors.kicad_sch, uc.kicad_sch]
2023-07-10 pmi_tof_sensors schematicsupdate after review
    [pmi_tof_sensor.kicad_sch]
2023-07-12 pmi 2023 wip
    [actuators.kicad_sch, com.kicad_sch, pmi_2023.kicad_sch, sensors.kicad_sch]
2023-07-13 pmi2023 wip
    [actuators.kicad_sch, com.kicad_sch, interface.kicad_sch, pmi_2023.kicad_sch, sensors.kicad_sch]
2023-07-19 tof sensor wip
    [pmi_tof_sensor.kicad_pcb]
2023-07-19 modified kicad libraries
2023-07-21 Remove asserv_2023 board
    [asserv_2023.kicad_pcb, asserv_2023.kicad_sch, motor_driver.kicad_sch, sensors.kicad_sch]
2023-07-21 Update gitignore for kicad
2023-07-21 Import canon 2019
    [canon_2019.kicad_pcb, canon_2019.kicad_sch, canon_2019.sch, control.kicad_sch, control.sch, drive.kicad_sch, drive.sch, phase.kicad_sch]
2023-12-14 pmi_2023 wip
    [actuators.kicad_sch, com.kicad_sch, interface.kicad_sch, pmi_2023.kicad_pcb, power_supply.kicad_sch, propulsion.kicad_sch, sensors.kicad_sch]
2024-02-04 pmi layout (WIP)
    [actuators.kicad_sch, com.kicad_sch, interface.kicad_sch, pmi_2023.kicad_pcb, power_supply.kicad_sch, propulsion.kicad_sch, sensors.kicad_sch]
2024-02-05 pmi2023: second board components placed
    [interface.kicad_sch, pmi_2023.kicad_pcb]
2024-03-18 front and back tof added, selector changed, ready to route
    [actuators.kicad_sch, boards_interface.kicad_sch, com.kicad_sch, interface.kicad_sch, pmi_2023.kicad_pcb, pmi_2023.kicad_sch, power_supply.kicad_sch, propulsion.kicad_sch]
2024-03-25 corrected librariesand ongoing routing
    [com.kicad_sch, interface.kicad_sch, pmi_2023.kicad_pcb, sensor_module.kicad_sch]
2024-04-18 added oled display power supply res selectors, jlcpcb refs : wip
    [actuators.kicad_sch, boards_interface.kicad_sch, com.kicad_sch, interface.kicad_sch, pmi_2023.kicad_pcb, pmi_2023.kicad_sch, power_supply.kicad_sch, propulsion.kicad_sch]
2024-04-28 3d models added
    [pmi_2023.kicad_pcb]
2024-04-28 3d models updated: wip
    [pmi_2023.kicad_pcb]
2024-05-06 reset button added to esp32 reset. uart prog connector replaces ftdi one
    [actuators.kicad_sch, boards_interface.kicad_sch, com.kicad_sch, interface.kicad_sch, pmi_2023.kicad_pcb, pmi_2023.kicad_sch, power_supply.kicad_sch, propulsion.kicad_sch]
2024-05-09 Base PAMI project to check pin assignation
2024-05-10 pmi2023 : drc cleanup
    [actuators.kicad_sch, boards_interface.kicad_sch, com.kicad_sch, pmi_2023.kicad_pcb, power_supply.kicad_sch, sensor_module.kicad_sch]
2024-05-12 routing cleanup, test points added to allow charging of battery in the pmi
    [actuators.kicad_sch, boards_interface.kicad_sch, com.kicad_sch, interface.kicad_sch, pmi_2023.kicad_pcb, pmi_2023.kicad_sch, power_supply.kicad_sch, propulsion.kicad_sch]
2024-05-13 modified mecanical fixation
    [pmi_2023.kicad_pcb]
2024-05-14 update pcb footprint lib path
2024-05-14 update schematic lib path
2024-05-14 Use relative path instead of hardcoded env variable for 3d
    [pmi_2023.kicad_pcb]
2024-05-28 pmi charger 2023 project added
    [pmi_charger_2023.kicad_pcb, pmi_charger_2023.kicad_sch]
2024-06-13 small changes
    [actuators.kicad_sch, com.kicad_sch, pmi_2023.kicad_pcb, pmi_2023.kicad_sch, power_supply.kicad_sch]
2024-06-13 add pmi_2023 charger
    [pmi_charger_2023.step]
2024-06-13 add first versions of encoder wheel : 22 step and 64 steps, with two different central hole pattern
    [encoder_wheel.kicad_pcb, encoder_wheel.kicad_sch]
2024-06-13 encoder_wheel : added beginning of 48 step version
    [encoder_wheel.kicad_pcb]
2024-06-14 encoder_wheel: update 48 step version and fill the stencil
2024-06-14 PAMI 2023: update jlc part number
    [actuators.kicad_sch, boards_interface.kicad_sch, com.kicad_sch, interface.kicad_sch, power_supply.kicad_sch, propulsion.kicad_sch, sensors.kicad_sch]
2024-06-15 fix:CC1/CC2 corrected, R6 connected to VBUS, R7 : set to unmounted
    [pmi_charger_2023.kicad_pcb, pmi_charger_2023.kicad_sch]
2024-06-16 GP2S60B replaced by ITR1204SR10A, RGB LED replaced by NH-B2020RGBA
    [actuators.kicad_sch, pmi_2023.kicad_pcb, sensor_module.kicad_sch, sensors.kicad_sch]
2024-06-17 PAMI charger: fix silkscreen
    [pmi_charger_2023.kicad_pcb]
2024-06-23 pami : reduce length from 73mm to 71.5mm to be able to climb sleep area
    [pmi_2023.kicad_pcb]
2024-08-17 pmi_tof_sensor : last commit before tmf8821 deletion
    [actuators.kicad_sch, boards_interface.kicad_sch, interface.kicad_sch, pmi_2023.kicad_pcb, pmi_tof_sensor.kicad_pcb, pmi_tof_sensor.kicad_sch, propulsion.kicad_sch]
2024-08-19 pmi_tof_sensor : new form factor and enable sequencer
    [pmi_tof_sensor.kicad_pcb, pmi_tof_sensor.kicad_sch]
2024-08-19 kicad libraries updated
2024-08-23 modified rc constant of enable circuit
    [pmi_tof_sensor.kicad_pcb, pmi_tof_sensor.kicad_sch]
2024-08-23 encoder resistors values corrected
    [com.kicad_sch, pmi_2023.kicad_pcb, propulsion.kicad_sch, sensors.kicad_sch]
2024-08-31 lib update, pmi2023 mecanical integration in progress
    [pmi_2023.kicad_pcb]
2024-09-08 modified mounting hole, replaced transistors to place them in bottom layer
    [interface.kicad_sch, pmi_2023.kicad_pcb, pmi_tof_sensor.kicad_pcb, pmi_tof_sensor.kicad_sch, propulsion.kicad_sch]
2024-09-08 BAU moved to bottom layer
    [interface.kicad_sch, pmi_2023.kicad_pcb]
2024-09-16 modified axis to 4mm diameter
2024-09-24 Move special pami code to test the board to a dedicated folder
2024-10-01 encoders updated
2024-10-01 start sensor replaced
    [interface.kicad_sch, pmi_2023.kicad_pcb, sensor_module.kicad_sch]
2024-10-01 updated kicad libraries
2024-10-07 XRA1200 replaced by TCA6408
    [actuators.kicad_sch, com.kicad_sch, interface.kicad_sch, pmi_2023.kicad_pcb, power_supply.kicad_sch, propulsion.kicad_sch, sensor_module.kicad_sch, sensors.kicad_sch]
2024-10-07 pmi2023 project pannel added
    [pannel.kicad_sch]
2024-10-12 device folder structure modified
2024-10-22 bom updated and component selection optimized to decrease bom cost
    [actuators.kicad_sch, com.kicad_sch, interface.kicad_sch, pmi_2023.kicad_pcb, pmi_tof_sensor.kicad_pcb, pmi_tof_sensor.kicad_sch, power_supply.kicad_sch, propulsion.kicad_sch]
2024-10-22 kicad lirbaries updates
2024-10-26 first pass review corrections
    [actuators.kicad_sch, interface.kicad_sch, pmi_2023.kicad_pcb, sensor_module.kicad_sch, sensors.kicad_sch]
2024-10-29 second round of review corrections
    [com.kicad_sch, interface.kicad_sch, pmi_2023.kicad_pcb, power_supply.kicad_sch, sensor_module.kicad_sch]
2024-10-30 review number 3 taken into account
    [com.kicad_sch, interface.kicad_sch, pmi_2023.kicad_pcb]
2024-10-31 18nF capacitors replaced by 2nF
    [pmi_2023.kicad_pcb, pmi_tof_sensor.kicad_pcb, pmi_tof_sensor.kicad_sch, power_supply.kicad_sch]
2024-11-02 pannel updated with latest pmi_2023 and pmi_tof_sensor boards
    [pmi_2023.kicad_pcb, pmi_tof_sensor.kicad_pcb]
2024-11-03 spare parts pcb added
    [spare_parts_pcb.kicad_pcb, spare_parts_pcb.kicad_sch]
2024-11-05 fusion of both spare parts into one pcb to decrease cost
2024-11-06 Add basic board project for pami2023
2024-11-06 Set real pc9685 i2c addr
2024-11-06 pmi_2023 : deleted spare parts, replaced touch bumpers
    [pmi_2023.kicad_pcb, sensors.kicad_sch]
2024-11-06 pmi 2023: board name and version added to pannel
2024-11-08 encoder_wheel : reduced number of wheels
2024-11-09 Add a help to configure tca6408a addr from pin state
2024-11-09 reduce the size of the encoder wheel stencil
2024-11-12 corrected sot-23-5 footprint
2024-11-12 corrected U5 footprint and ESE58xxx fopotprints
    [pmi_2023.kicad_pcb, sensors.kicad_sch]
2024-11-21 Add line and buttons drivers
2024-12-01 some input pins added, first adc try
2024-12-03 pami2023 : adc added
2024-12-03 Add encoder devices
2024-12-04 corrected pami 2023 schematic comments, updated 3d model for bumper switches
    [actuators.kicad_sch]
2024-12-04 updated 3d model for bumper switches
    [pmi_2023.kicad_pcb]
2024-12-06 Create shared pwm module
2024-12-06 fix battery reading
2024-12-13 corrected NH-B2020RGBA LED 3d body
2024-12-13 pami2023 : 3d body update
    [pmi_2023.kicad_pcb]
2024-12-13 pami : demo code to display accelerometer data
2025-01-04 corrected encoder increment direction. changed motor pwm full scale from 100 to 1000
2025-01-04 added right pwm
2025-01-05 added pwm offset automatic detection
2025-01-07 first version of pami printable mechanical parts
    [PAMI-support_moteur_helice.stl]
2025-02-01 fixed VBATT adc wrong measure : adc res and resistor gain
    [main.rs, mod.rs]
2025-02-04 feat : emergency stop added to asserv. fix : encoder patch to prevent counter drop and clock disabling.
    [config.rs, main.rs]
2025-04-02 Add motor filter config to generic config structure
2025-04-05 corrected asserv and updated config for yellow pami
    [config.rs]
2025-04-11 Convert current motor to mA
2025-04-11 Fix asserv (ramp config inversion)
    [config.rs]
2025-04-11 Improve battery SOC computation
2025-07-14 Add support for L1 and L5 tof sensors
    [VL53L1X_ULD_API_Example Run.cfg]
2025-07-16 Add tca6408 device support
2025-07-18 Fix vl53L5 with real hardware tests
    [lib.rs, main.rs, mod.rs]
2025-07-28 Fix vl53L1 with real hardware
    [lib.rs, mod.rs]
2025-09-17 feat: enable ble communication
    [partitions.csv]
2025-09-27 Add light controll on right joystick and fan on L2
2025-09-28 fix pamiu pwm
2025-11-01 reset added at init of sch16t device, and angle computed with low resolution measure if saturation detected
2025-11-01 sc16t: Remove 'sensor_data' field, redundant with 'dcnt'
2025-11-14 Simplify/improve vlx implementation
    - Merge all error types: there is no need for implementations to return
    a specific error type if it's ignore by the VLX wrapper
    - Factorize dispatch to sensor implementations
    - Limit the scope of unsafe blocks
    - Use explicit 'extern "C"' to fix warnings
    - Remove unneedeed 'unsafe' on 'call_i2c_*()'
    - Return bool from 'call_i2c_*()'
    - Simplify code here and there
2025-11-14 Improve ble
    - Fix indentation
    - Use a static name to avoid clone
    - Don't store rome_tx on state, it's not needed
    - Don't store a GattResponse on state, it's not needed and avoids a lock
    - Simplify some prototypes/calls
    - Declare BtUuid constants directly
    - Fix typo in SERVICE_ROME_UUID in ble
    - Remove unused 'mtu' and 'subscribed' fields
    - Cosmetic changes
    [main.rs]
2025-11-14 Make VLX buildable on non-esp target, fix some non-esp build errors
    - Disable compilation on non-esp target
    - Separate "hardware-specific" symbols
    Projects are still not buildable on non-esp targets.
    [lib.rs]
2025-11-22 Rework VLX, improve PAMI board
    VLX rework
    - Remove the "configuration" structure that creates an indirection.
    Now, each VLX sensor is handled individually.
    - The enable/reset routines are not specific to 'boards/pami'.
    If we don't need to initialize VLX "in parallel", this may change.
    - As a result, VLX must be initialized using a dedicated board method.
    - Merge MultiZoneData and DistanceData: "single" capture can be handled
    as a 1x1 grid.
    Add buttons and line sensor to PAMI board.
    [lib.rs, main.rs]
2025-11-26 galipeur: begin asserv integration (fix build)
    [partitions.csv]
2025-11-28 galipeur: put gyro reading into asserv module
2025-11-28 galipeur: better error message for gyro
2025-12-03 galipeur: configure encoder and motor drive (tested on real robot !)
2025-12-03 pami: Keep only the valid sensor
2025-12-05 vlx: Clean-up and refactor
    - Remove unused leftovers of previous cleaning
    - Simplify the "alarm" API
    - Use macros to simplify calls to bindings
    - Define constants in bindings.rs
    - Rework error enum
    - Move common symbols to the root module
    - Change zone coordinates to u8 types
    [lib.rs, main.rs]
2025-12-05 pami: Rework PAMI board and related code
    [config.rs, esp.rs, lib.rs, main.rs, mock.rs, ui.rs]
2025-12-18 pami: Replace EmergencyStop trait with FnMut
    [esp.rs, lib.rs, mock.rs, pami_asserv.rs]
2025-12-19 Add 'board-common' crate
2025-12-19 pami: Use board-common crate
2025-12-19 Move Periodicity helper to board-common
2025-12-19 pami: More work on main
    - Add starting cord
    - Prepare "start procedure"
    - Remove the "reboot" UI action: there is a alraedy a hardware button
    - Fix few things
    [esp.rs, events.rs, lib.rs, main.rs, mock.rs, ui.rs]
2025-12-28 vlx: Fix I2C address change
    vl53l5cx_set_i2c_address() always fails, even if the address is actually
    updated. Implement a workaround.
2026-01-09 galipeur: try to find which encoder is inverted. should be ok but need test
    [lib.rs, movement.rs]
2026-01-10 galipeur: angle pid adjustement moved from default value
2026-01-12 esp32_encoder: Adjust min/max values
    Low values are dangerous and there are no known drawbacks for higher values.
2026-01-12 asserv: Fix inversed stop/steering windows for holonomic
2026-01-13 Clean-up various code/ files
    [partitions.csv]
2026-02-21 asserv: Fix differential::MotorsConf::from_dimensions()
2026-02-21 pami: Support more hardware, especially LEDs
2026-03-14 Update and homogeneize Rust dependencies
    - Use edition 2024 for all projects
    - Sort dependencies, separate "local" en remote ones
    - Cosmetic fixes
    Only build of pami and galipeur for esp has been checked.
    [main.rs]
2026-03-14 Upgrade esp-idf-svc to 0.52 and esp-idf to 5.5.
    The following changes have been made to reflect API changes
    - Adjust trait parameters related to pins, peripheral, ...
    - Use new 'pcnt' module for encoders. Follow the basic encoder example.
    It provides builtin "overflow" handling.
    - Explicitely set pull mode for PAMI input pins.
    Values have not been chosen carefully though.
    - Adjust handling of BLE scan results. API now provides Rust structures.
    Note that we don't use scan results yet so it won't be tested.
    [esp.rs, lib.rs]
2026-03-14 Fix few clippy warnings
    [main.rs]
2026-03-16 pami: Rename BatteryLevel to BatteryReader, add a BatteryLevel struct for result
2026-03-17 Fix: bry-dev build issue
    [main.rs]
2026-03-18 picotter: add board support and can communication
2026-03-18 sabotter: fix sabotter run when not connected to trimotter
    [main.rs]
2026-03-19 pami: Complete rework of main routine
    [events.rs, lib.rs, main.rs, routines.rs, ui.rs]
2026-03-19 galipeur: Remove unused motor GPIO pin 4
2026-03-20 picotter: pin rust toolchain to 1.94.0 stable
    Fixes build failure on machines with nightly 1.96.0 which has a
    regression in std's GlobalAlloc implementation.
2026-03-21 Use esp32_encoder for pami, move some board_common traits
2026-03-21 Remove board/simulator
    Host target will be handled differently.
    Remove everything for now.
2026-03-21 Simplify galipeur and its board, remove unused elements, clean up
2026-03-22 Rework sabotter board to be generic as for pami
    [esp.rs, lib.rs, main.rs, mock.rs, movement.rs]
2026-03-24 Remove superfluous explict lifetime on boards
2026-03-25 galipeur: Add CAN bus and meca messages
2026-03-25 Fix board builds for host target
    They were not compiling at all.
    [mock.rs]
2026-03-28 sabotter: add color selection, cleanup some warnings, color sensor configuration
2026-03-28 picotter: add ground lidar and color sensor
2026-03-28 Replace std::sync::mpsc with flume to fix task watchdog on ESP-IDF
    Rust's std mpsc channel uses a spin-wait (sched_yield) internally when
    a reader catches a slot mid-write. On FreeRTOS, sched_yield only yields
    to equal/higher priority tasks, never to the IDLE task, which triggers
    the task watchdog (rust-lang/rust#112723).
    flume uses condvar-based blocking instead, which properly parks the
    thread and lets the IDLE task run.
    [esp.rs, led.rs, lib.rs, main.rs, mock.rs, ui.rs]
2026-03-29 Rewrite libs/ble from Bluedroid to NimBLE
    Bluedroid BLE broken on ESP32-S3. Switch to NimBLE raw FFI with
    extended advertising, static GATT tables, and automatic CCCD handling.
    [esp.rs, lib.rs, main.rs]
2026-03-29 galipeur: use release arm positions in meca init
2026-04-03 Add support for OTA + 2nd stage of picotter
    [partitions.csv]
2026-04-03 galipeur: test code for color sensor
2026-04-04 galipeur: Add routines, rework CAN support
    Add "routines" similar to PAMI.
    Rework CAN handling completely to remove hardware-specific things from
    galipeur. This required to hack to both avoid to reimplement `CanDriver`
    and make it possible to receive CAN frames in a never-ending thread.
    [esp.rs, lib.rs, main.rs, mod.rs, movement.rs, proxy.rs, routines.rs]
2026-04-07 can: fix dropped can frame issue
    [can.rs, can_handler.rs, lib.rs, main.rs, mod.rs, proxy.rs]
2026-04-07 picotter: improve scan et set id servo commands
2026-04-09 galipeur: add logic battery check
2026-04-09 galipeur: enable battery adc
2026-04-09 picotter: enable lidars
2026-04-13 sabotter: fix rgb led gitch
    [lib.rs]
2026-04-13 picotter: do not enable color sensor led without sabotter order
2026-04-13 sabotter: add debug helper for ground sensor calibration
2026-04-13 sabotter: remove debug battery adc log
2026-04-14 galipeur: add ground lidar support
2026-04-15 gapileur: add sensors (also small fix for event loop timings)
    [esp.rs, ground_sensors.rs, ld06.rs, led.rs, lib.rs, m703a.rs, main.rs, mock.rs]
2026-04-19 galipeur: Use the common BatteryReader trait
2026-04-19 pami: Fix build, following changes of the previous big merge
    [esp.rs]
2026-04-27 test: ground lidar responses
2026-04-27 test: debug ground sensor
2026-04-27 test : debug ground sensor
2026-04-27 picotter: increase lidar timeout
2026-04-27 picotter: add debug on force lidar off
2026-04-27 picotter: debug lidar off
2026-04-27 sabotter: test lidar calibration
2026-05-01 galipeur: Rename 'get_side_state*()' to have shorter names
    [mod.rs, state.rs]
2026-05-01 galipeur: add functions to use arm sides when moving
2026-05-01 galipeur: fix color led not showing
    [led.rs]
2026-05-01 galipeur: fixes to strat init
    [mod.rs]
2026-05-01 amatheur: Add helper to flip X axis value
    Often used to switch the table side.
2026-05-02 meca: move actions to dedicated worker thread
    Prepare functions (prepare_direct_take, prepare_release) now return
    the chosen side immediately then execute movements in background.
    Direct functions (direct_take, release) block until completion.
    The FIFO channel guarantees ordering between prepare and direct calls.
2026-05-03 galipeur: fix meca orders (eirbot tests 020526)
    [lib.rs, mod.rs, primitives.rs, routines.rs, worker.rs]
2026-05-03 Rework meca ROME message, step 1
    - Rename some orders
    - Send MecaTmSideTranslation
    [mod.rs, routines.rs, state.rs, worker.rs]
2026-05-03 galipeur: Keep lower stage color displayed
2026-05-03 galipeur: Run asserv in a separate thread
2026-05-03 galipeur: Simplifications, cosmetic fixes
    [proxy.rs, watched.rs]
2026-05-03 pami: adjust pid coeff
2026-05-03 pami: Add match timer
2026-05-03 Fix warnings and lint warnings
    Don't include the whole message in `rome::DecodeError`. We don't intend
    to handle the error and it's better to avoid using a possibly very large
    error type.
    [led.rs, mod.rs, routines.rs, ui.rs]
2026-05-03 pami: Improve match timer handling
    - Don't use starting delay for ninja
    - Provide duration until next step in enum
2026-05-03 rome: Remove lidar messages, not used anymore
2026-05-04 galipeur: fix meca worker state transitions and side reset
    [worker.rs]
2026-05-23 pami: Move VLX processing to a separate thread
2026-05-23 asserv: Fix reset of differential::MotorFilter
    On reset, ramps must be reset to their current value, not 0.
    Also reset the ramps when emergency stop is active.
2026-05-24 pami: Increase VLX polling interval
    200ms is too fast. Change to 1s for the time being, at least to avoid warnings.
    [routines.rs]
2026-05-24 pami: Fix switches mapping
    Now, bits match physical switches from left to right, numbered 1 to 4.
    Switch usage has not been updated.
    [esp.rs]
2026-05-25 vlx: Add VLX device orientation
