cocobot/cocotter/(notices)

Notices in the files:
elec/hw/cartes/canon_2019/canon_2019.sch:
CC-BY 4.0
